brianssparetime/bronica-lens-housing/img-vid/bronica-s2-scan1.png

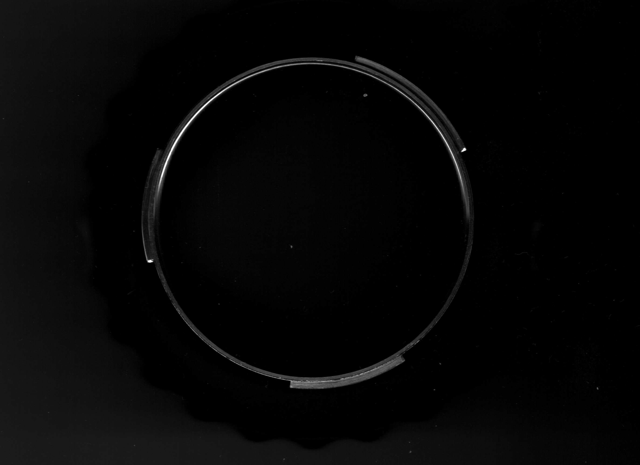
img-vid/bronica-s2-scan1.png
