brianssparetime/bronica-lens-housing/img-vid/bronica-s2-scan2.png

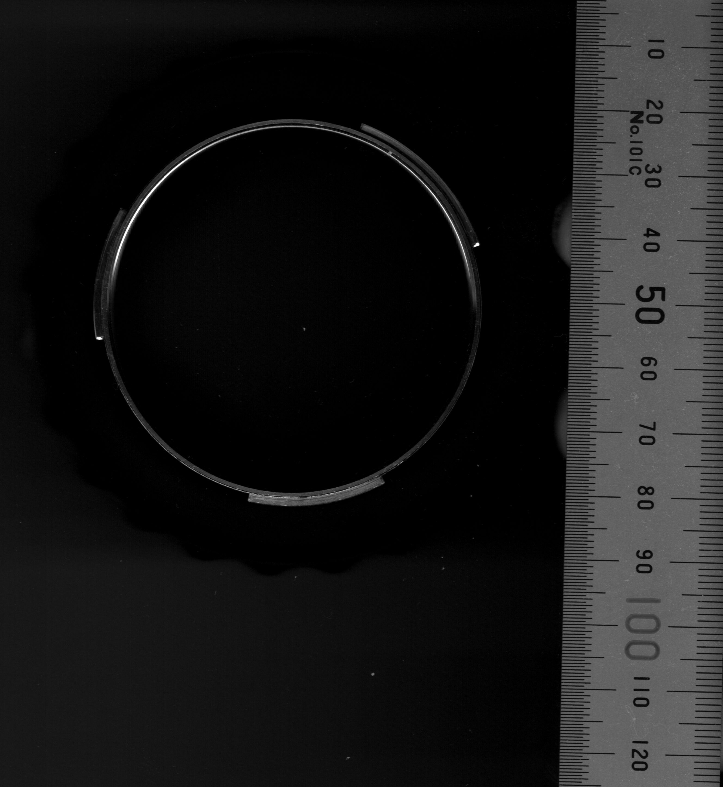
img-vid/bronica-s2-scan2.png
