brianssparetime/bronica-lens-housing/img-vid/IMG_2741 Large head on.jpeg

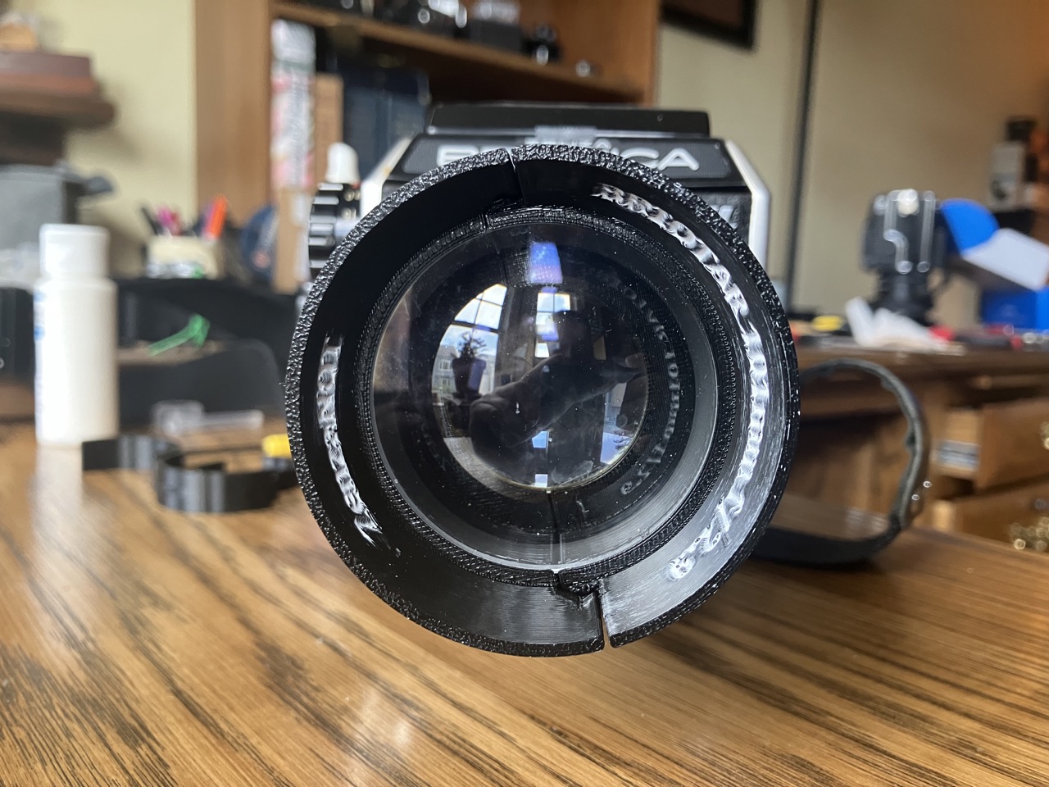
img-vid/IMG_2741 Large head on.jpeg
