brianssparetime/bronica-lens-housing/releases/13f/v13f-mount_ring_slice.stl

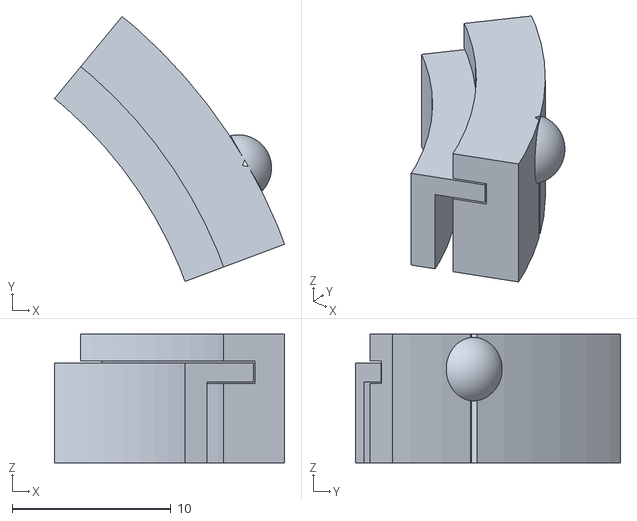
[picture p8: CAD file, 2026-08-01]
releases/13f/v13f-mount_ring_slice.stl
14.5 x 16.7 x 8.10
