brianssparetime/bronica-lens-housing/releases/14a/v14a-print_aperture_cover.stl

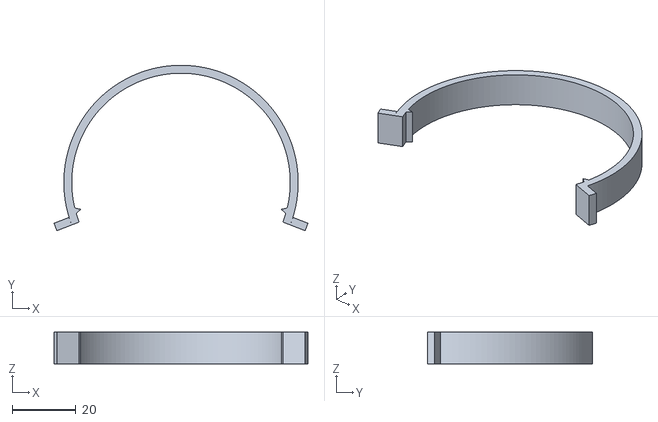
[picture p9: CAD file, 2026-08-01]
releases/14a/v14a-print_aperture_cover.stl
79.6 x 51.9 x 10.0
