brianssparetime/bronica-lens-housing/releases/15a/v15a-print_vertical.stl

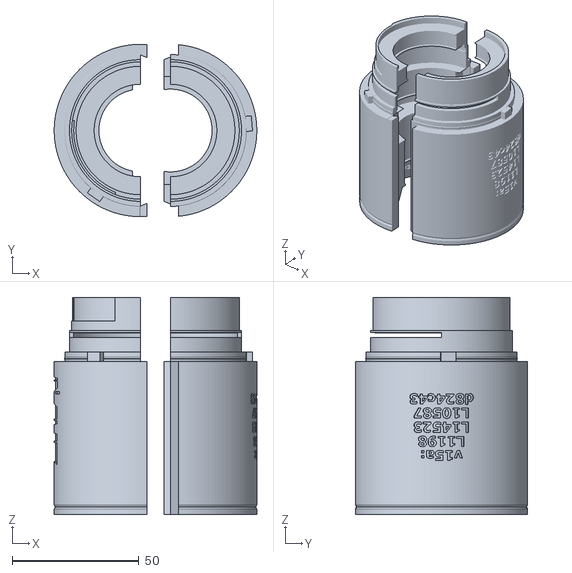
[picture p10: CAD file, 2026-08-01]
releases/15a/v15a-print_vertical.stl
80.1 x 68.1 x 85.8
