brianssparetime/bronica-lens-housing/releases/16c/v16c-print_vertical.stl

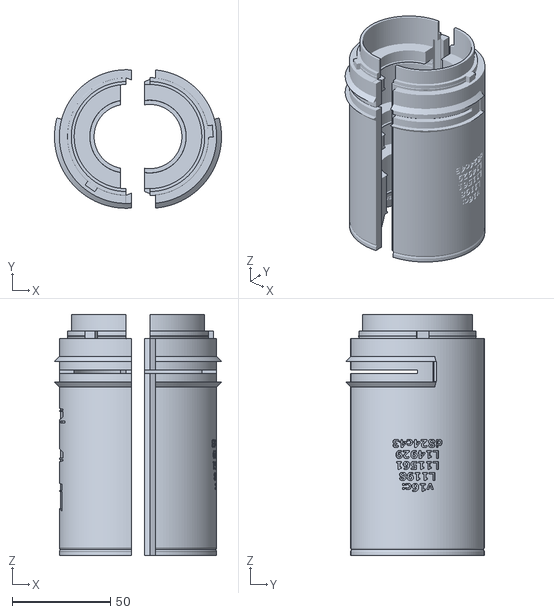
[picture p11: CAD file, 2026-08-01]
releases/16c/v16c-print_vertical.stl
85.1 x 70.6 x 122.8
