brianssparetime/bronica-lens-housing/releases/caps/rear_lens_cap-rear_cap.stl

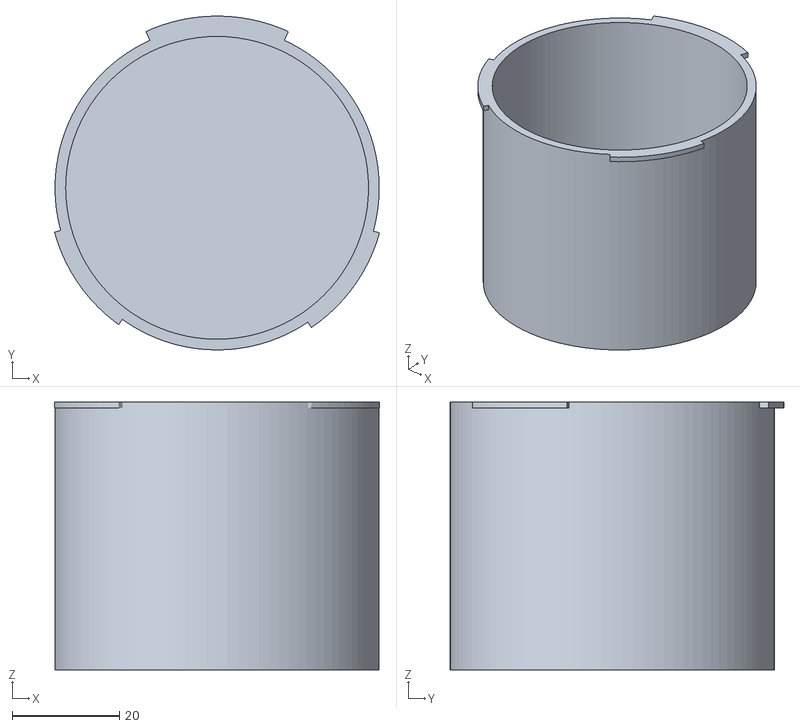
[picture p12: CAD file, 2026-11-03]
releases/caps/rear_lens_cap-rear_cap.stl
60.6 x 62.3 x 50.0
