brianssparetime/bronica-lens-housing/releases/mount-ring/lens_mount_ring-lens_print.stl

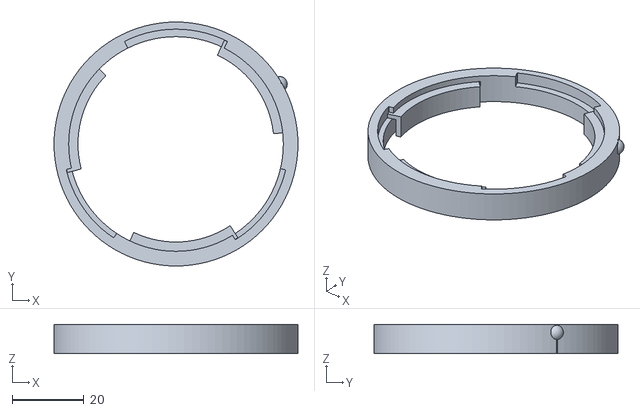
[picture p13: CAD file, 2026-08-01]
releases/mount-ring/lens_mount_ring-lens_print.stl
68.1 x 68.1 x 8.10
