brianssparetime/bronica-lens-housing/releases/14a/v14a-print_hood.stl

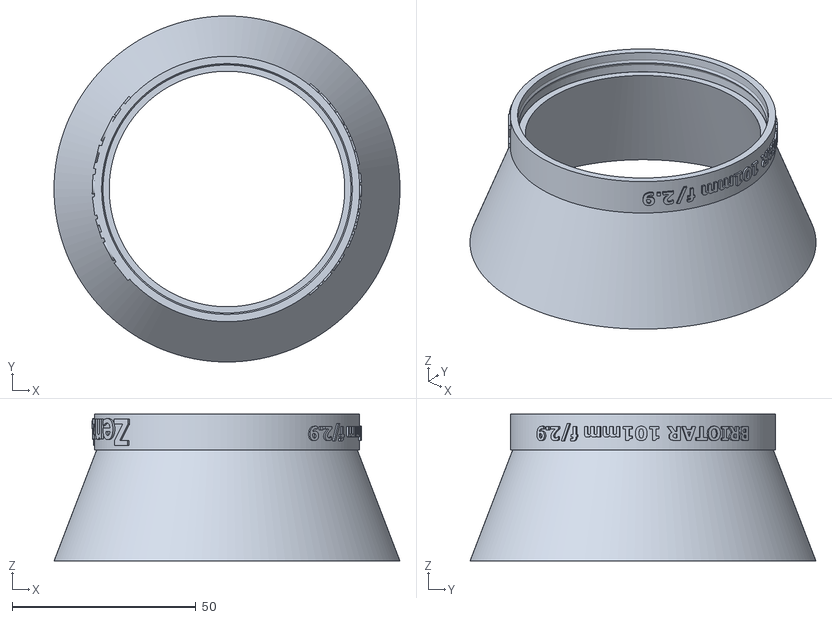
[picture p14: CAD file, 2026-08-01]
releases/14a/v14a-print_hood.stl
94.2 x 94.2 x 40.0
