brianssparetime/bronica-lens-housing/releases/caps/body_cap-cap.stl

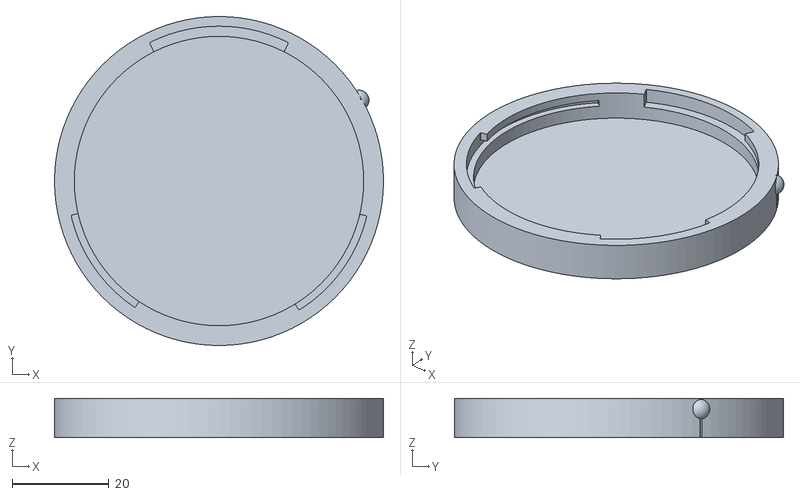
[picture p15: CAD file, 2026-11-03]
releases/caps/body_cap-cap.stl
68.1 x 68.1 x 8.10
