brianssparetime/bronica-lens-housing/releases/mount-ring/lens_mount_ring-lens.stl

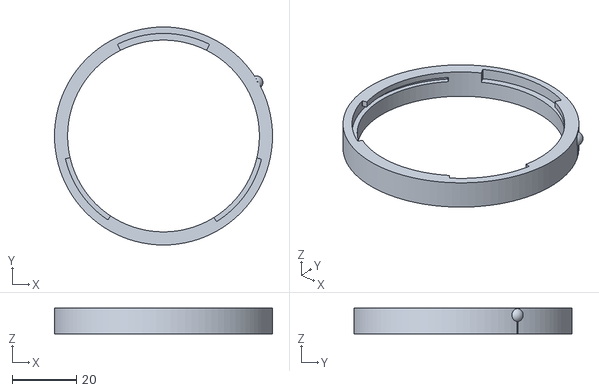
[picture p16: CAD file, 2026-08-01]
releases/mount-ring/lens_mount_ring-lens.stl
68.1 x 68.1 x 8.10
