brianssparetime/bronica-lens-housing/releases/14a/v14a-print_vertical.stl

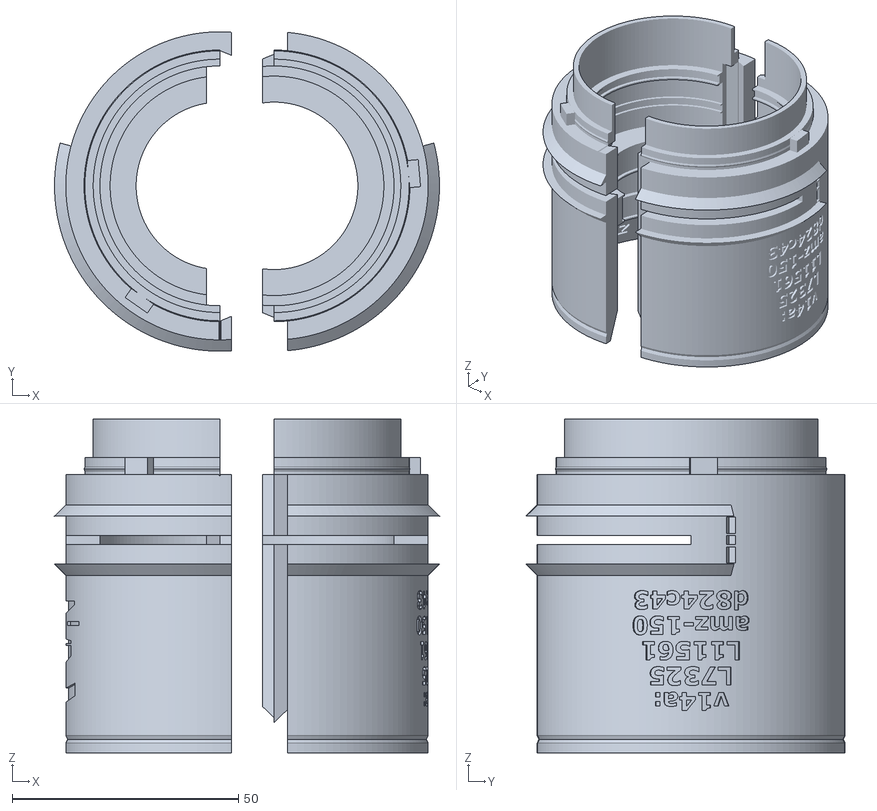
[picture p17: CAD file, 2026-08-01]
releases/14a/v14a-print_vertical.stl
85.1 x 70.6 x 73.8
