brianssparetime/bronica-lens-housing/releases/15a/v15a-print_stops.stl

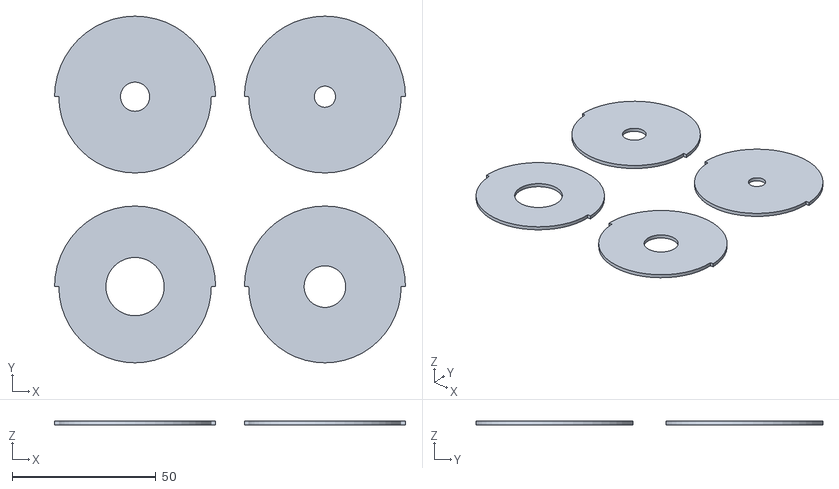
[picture p18: CAD file, 2026-08-01]
releases/15a/v15a-print_stops.stl
122.0 x 120.5 x 1.50
