brianssparetime/bronica-lens-housing/releases/caps/rear_lens_cap-rear_cap_sym.stl

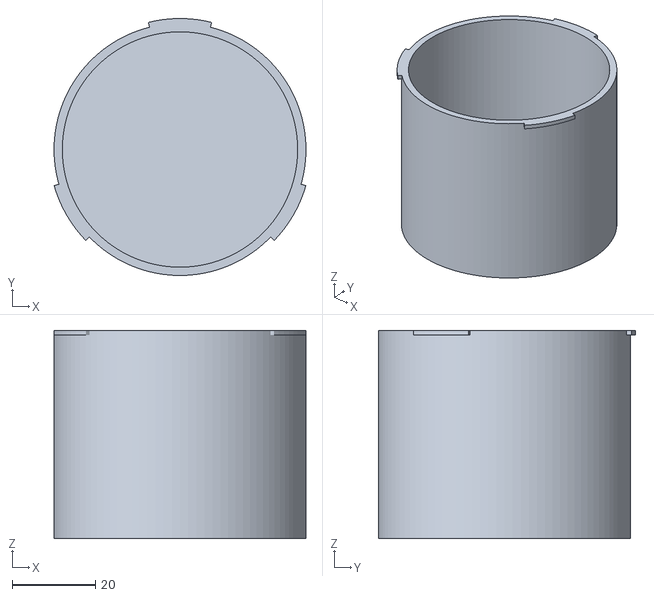
[picture p19: CAD file, 2026-11-03]
releases/caps/rear_lens_cap-rear_cap_sym.stl
60.5 x 61.7 x 50.0
