brianssparetime/bronica-lens-housing/releases/mount-ring/lens_mount_locking_ring-print.stl

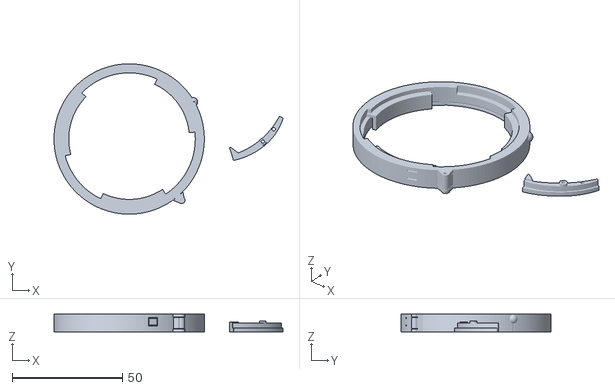
[picture p20: CAD file, 2026-08-01]
releases/mount-ring/lens_mount_locking_ring-print.stl
103.7 x 68.1 x 8.10
