brianssparetime/bronica-lens-housing/releases/15a/v15a-element_grippers.stl

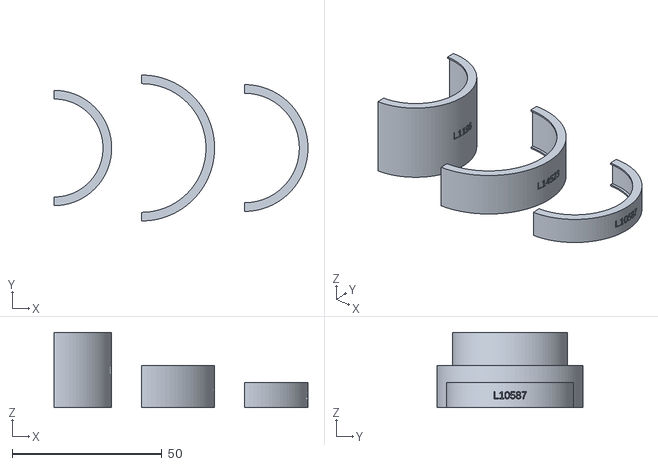
[picture p21: CAD file, 2026-08-01]
releases/15a/v15a-element_grippers.stl
84.8 x 48.7 x 25.1
