brianssparetime/bronica-lens-housing/releases/15a/v15a-print_shape_stops.stl

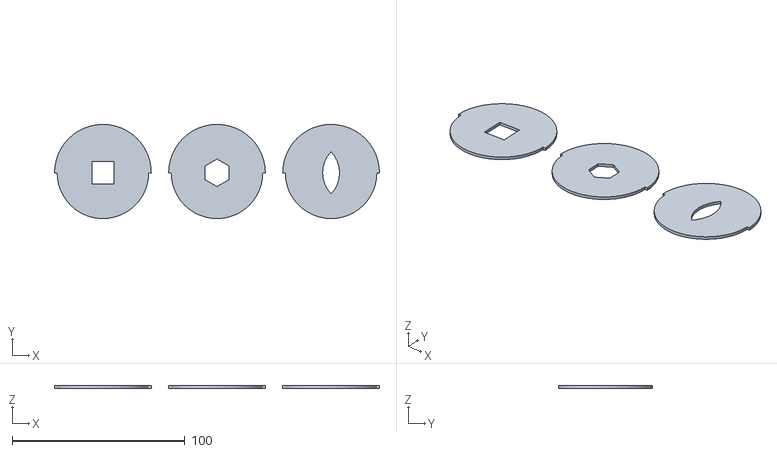
[picture p23: CAD file, 2026-08-01]
releases/15a/v15a-print_shape_stops.stl
188.0 x 54.5 x 1.50
