brianssparetime/bronica-lens-housing/releases/15a/v15a-element_grippers.scad

// Generated by scadwright. Do not hand-edit —
// edit the Python source and regenerate.

$fn = 96;

union() {
    translate([0, 24.35, 0]) {
        intersection() {
            difference() {
                // ElementTestGripper
                //  element     = Element(code='L1198', type='ACH', dia=34.2, edge_thk=23.75, spacing=51.9, face_z_top=64.475, face_z_bot=39.325, constricted=False, throat_dia_required=34.5, clearances=ElementClearances(axial=0.2, radial=0.3))  (input)
                //  grip_depth  = 1.5  (input)
                //  grip_width  = 1  (input)
                //  wall_thk    = 2  (input)
                //  gripper_h   = grip_width / 2 = 0.5
                //  surround_h  = element.face_z_top - element.spacing - gripper_h = 12.075
                //  rim_id      = element.dia - grip_depth = 32.7
                //  surround_id = element.dia + element.clearances.radial = 34.5
                //  od          = surround_id + 2 * wall_thk = 38.5
                //  total_h     = 2 * (gripper_h + surround_h) = 25.15
                union() {
                    // Tube
                    //  h  = 0.5  (input)
                    //  id = 32.7  (input)
                    //  od = 38.5  (input)
                    difference() {
                        cylinder(h=0.5, r=19.25, center=false);
                        translate([0, 0, -0.01]) {
                            scale([1, 1, 1.04]) {
                                cylinder(h=0.5, r=16.35, center=false);
                            }
                        }
                    }
                    translate([0, 0, 0.5]) {
                        // Tube
                        //  h  = 24.15  (input)
                        //  id = 34.5  (input)
                        //  od = 38.5  (input)
                        difference() {
                            cylinder(h=24.15, r=19.25, center=false);
                            translate([0, 0, -0.01]) {
                                scale([1, 1, 1.00083]) {
                                    cylinder(h=24.15, r=17.25, center=false);
                                }
                            }
                        }
                    }
                    translate([0, 0, 24.65]) {
                        // Tube
                        //  h  = 0.5  (input)
                        //  id = 32.7  (input)
                        //  od = 38.5  (input)
                        difference() {
                            cylinder(h=0.5, r=19.25, center=false);
                            translate([0, 0, -0.01]) {
                                scale([1, 1, 1.04]) {
                                    cylinder(h=0.5, r=16.35, center=false);
                                }
                            }
                        }
                    }
                }
                union() {
                    translate([18.4796, -3.66765, 12.575]) {
                        multmatrix([[0.194673, 0, 0.980868, 0], [0.980868, 0, -0.194673, 0], [0, 1, 0, 0], [0, 0, 0, 1]]) {
                            linear_extrude(height=0.91, center=false) {
                                translate([-0.942887, -1.25, 0]) {
                                    text("L", size=2.5);
                                }
                            }
                        }
                    }
                    translate([18.7497, -1.84266, 12.575]) {
                        multmatrix([[0.0978057, 0, 0.995206, 0], [0.995206, 0, -0.0978057, 0], [0, 1, 0, 0], [0, 0, 0, 1]]) {
                            linear_extrude(height=0.91, center=false) {
                                translate([-0.942887, -1.25, 0]) {
                                    text("1", size=2.5);
                                }
                            }
                        }
                    }
                    translate([18.84, 0, 12.575]) {
                        multmatrix([[0, 0, 1, 0], [1, 0, 0, 0], [0, 1, 0, 0], [0, 0, 0, 1]]) {
                            linear_extrude(height=0.91, center=false) {
                                translate([-0.942887, -1.25, 0]) {
                                    text("1", size=2.5);
                                }
                            }
                        }
                    }
                    translate([18.7497, 1.84266, 12.575]) {
                        multmatrix([[-0.0978057, 0, 0.995206, 0], [0.995206, 0, 0.0978057, 0], [0, 1, 0, 0], [0, 0, 0, 1]]) {
                            linear_extrude(height=0.91, center=false) {
                                translate([-0.942887, -1.25, 0]) {
                                    text("9", size=2.5);
                                }
                            }
                        }
                    }
                    translate([18.4796, 3.66765, 12.575]) {
                        multmatrix([[-0.194673, 0, 0.980868, 0], [0.980868, 0, 0.194673, 0], [0, 1, 0, 0], [0, 0, 0, 1]]) {
                            linear_extrude(height=0.91, center=false) {
                                translate([-0.942887, -1.25, 0]) {
                                    text("8", size=2.5);
                                }
                            }
                        }
                    }
                }
            }
            translate([25.653, 0, 0]) {
                cube([51.306, 51.306, 51.306], center=true);
            }
        }
    }

    translate([29.25, 24.35, 0]) {
        intersection() {
            difference() {
                // ElementTestGripper
                //  element     = Element(code='L14523', type='ACH', dia=44.4, edge_thk=12.6, spacing=25.9, face_z_top=32.9, face_z_bot=18.9, constricted=False, throat_dia_required=44.699999999999996, clearances=ElementClearances(axial=0.2, radial=0.3))  (input)
                //  grip_depth  = 1.5  (input)
                //  grip_width  = 1  (input)
                //  wall_thk    = 2  (input)
                //  gripper_h   = grip_width / 2 = 0.5
                //  surround_h  = element.face_z_top - element.spacing - gripper_h = 6.5
                //  rim_id      = element.dia - grip_depth = 42.9
                //  surround_id = element.dia + element.clearances.radial = 44.7
                //  od          = surround_id + 2 * wall_thk = 48.7
                //  total_h     = 2 * (gripper_h + surround_h) = 14
                union() {
                    // Tube
                    //  h  = 0.5  (input)
                    //  id = 42.9  (input)
                    //  od = 48.7  (input)
                    difference() {
                        cylinder(h=0.5, r=24.35, center=false);
                        translate([0, 0, -0.01]) {
                            scale([1, 1, 1.04]) {
                                cylinder(h=0.5, r=21.45, center=false);
                            }
                        }
                    }
                    translate([0, 0, 0.5]) {
                        // Tube
                        //  h  = 13  (input)
                        //  id = 44.7  (input)
                        //  od = 48.7  (input)
                        difference() {
                            cylinder(h=13, r=24.35, center=false);
                            translate([0, 0, -0.01]) {
                                scale([1, 1, 1.00154]) {
                                    cylinder(h=13, r=22.35, center=false);
                                }
                            }
                        }
                    }
                    translate([0, 0, 13.5]) {
                        // Tube
                        //  h  = 0.5  (input)
                        //  id = 42.9  (input)
                        //  od = 48.7  (input)
                        difference() {
                            cylinder(h=0.5, r=24.35, center=false);
                            translate([0, 0, -0.01]) {
                                scale([1, 1, 1.04]) {
                                    cylinder(h=0.5, r=21.45, center=false);
                                }
                            }
                        }
                    }
                }
                union() {
                    translate([23.4927, -4.60615, 7]) {
                        multmatrix([[0.192404, 0, 0.981316, 0], [0.981316, 0, -0.192404, 0], [0, 1, 0, 0], [0, 0, 0, 1]]) {
                            linear_extrude(height=0.91, center=false) {
                                translate([-0.942887, -1.25, 0]) {
                                    text("L", size=2.5);
                                }
                            }
                        }
                    }
                    translate([23.7786, -2.77478, 7]) {
                        multmatrix([[0.115906, 0, 0.99326, 0], [0.99326, 0, -0.115906, 0], [0, 1, 0, 0], [0, 0, 0, 1]]) {
                            linear_extrude(height=0.91, center=false) {
                                translate([-0.942887, -1.25, 0]) {
                                    text("1", size=2.5);
                                }
                            }
                        }
                    }
                    translate([23.9221, -0.926779, 7]) {
                        multmatrix([[0.0387126, 0, 0.99925, 0], [0.99925, 0, -0.0387126, 0], [0, 1, 0, 0], [0, 0, 0, 1]]) {
                            linear_extrude(height=0.91, center=false) {
                                translate([-0.942887, -1.25, 0]) {
                                    text("4", size=2.5);
                                }
                            }
                        }
                    }
                    translate([23.9221, 0.926779, 7]) {
                        multmatrix([[-0.0387126, 0, 0.99925, 0], [0.99925, 0, 0.0387126, 0], [0, 1, 0, 0], [0, 0, 0, 1]]) {
                            linear_extrude(height=0.91, center=false) {
                                translate([-0.942887, -1.25, 0]) {
                                    text("5", size=2.5);
                                }
                            }
                        }
                    }
                    translate([23.7786, 2.77478, 7]) {
                        multmatrix([[-0.115906, 0, 0.99326, 0], [0.99326, 0, 0.115906, 0], [0, 1, 0, 0], [0, 0, 0, 1]]) {
                            linear_extrude(height=0.91, center=false) {
                                translate([-0.942887, -1.25, 0]) {
                                    text("2", size=2.5);
                                }
                            }
                        }
                    }
                    translate([23.4927, 4.60615, 7]) {
                        multmatrix([[-0.192404, 0, 0.981316, 0], [0.981316, 0, 0.192404, 0], [0, 1, 0, 0], [0, 0, 0, 1]]) {
                            linear_extrude(height=0.91, center=false) {
                                translate([-0.942887, -1.25, 0]) {
                                    text("3", size=2.5);
                                }
                            }
                        }
                    }
                }
            }
            translate([24.837, 0, 0]) {
                cube([49.674, 49.674, 49.674], center=true);
            }
        }
    }

    translate([63.6, 24.35, 0]) {
        intersection() {
            difference() {
                // ElementTestGripper
                //  element     = Element(code='L10587', type='ACH', dia=38.0, edge_thk=7.0, spacing=0.9, face_z_top=5.1000000000000005, face_z_bot=-3.3000000000000003, constricted=True, throat_dia_required=38.3, clearances=ElementClearances(axial=0.2, radial=0.3))  (input)
                //  grip_depth  = 1.5  (input)
                //  grip_width  = 1  (input)
                //  wall_thk    = 2  (input)
                //  gripper_h   = grip_width / 2 = 0.5
                //  surround_h  = element.face_z_top - element.spacing - gripper_h = 3.7
                //  rim_id      = element.dia - grip_depth = 36.5
                //  surround_id = element.dia + element.clearances.radial = 38.3
                //  od          = surround_id + 2 * wall_thk = 42.3
                //  total_h     = 2 * (gripper_h + surround_h) = 8.4
                union() {
                    // Tube
                    //  h  = 0.5  (input)
                    //  id = 36.5  (input)
                    //  od = 42.3  (input)
                    difference() {
                        cylinder(h=0.5, r=21.15, center=false);
                        translate([0, 0, -0.01]) {
                            scale([1, 1, 1.04]) {
                                cylinder(h=0.5, r=18.25, center=false);
                            }
                        }
                    }
                    translate([0, 0, 0.5]) {
                        // Tube
                        //  h  = 7.4  (input)
                        //  id = 38.3  (input)
                        //  od = 42.3  (input)
                        difference() {
                            cylinder(h=7.4, r=21.15, center=false);
                            translate([0, 0, -0.01]) {
                                scale([1, 1, 1.0027]) {
                                    cylinder(h=7.4, r=19.15, center=false);
                                }
                            }
                        }
                    }
                    translate([0, 0, 7.9]) {
                        // Tube
                        //  h  = 0.5  (input)
                        //  id = 36.5  (input)
                        //  od = 42.3  (input)
                        difference() {
                            cylinder(h=0.5, r=21.15, center=false);
                            translate([0, 0, -0.01]) {
                                scale([1, 1, 1.04]) {
                                    cylinder(h=0.5, r=18.25, center=false);
                                }
                            }
                        }
                    }
                }
                union() {
                    translate([20.2269, -4.58485, 4.2]) {
                        multmatrix([[0.221063, 0, 0.975259, 0], [0.975259, 0, -0.221063, 0], [0, 1, 0, 0], [0, 0, 0, 1]]) {
                            linear_extrude(height=0.91, center=false) {
                                translate([-0.942887, -1.25, 0]) {
                                    text("L", size=2.5);
                                }
                            }
                        }
                    }
                    translate([20.5548, -2.76556, 4.2]) {
                        multmatrix([[0.133344, 0, 0.99107, 0], [0.99107, 0, -0.133344, 0], [0, 1, 0, 0], [0, 0, 0, 1]]) {
                            linear_extrude(height=0.91, center=false) {
                                translate([-0.942887, -1.25, 0]) {
                                    text("1", size=2.5);
                                }
                            }
                        }
                    }
                    translate([20.7194, -0.924302, 4.2]) {
                        multmatrix([[0.0445662, 0, 0.999006, 0], [0.999006, 0, -0.0445662, 0], [0, 1, 0, 0], [0, 0, 0, 1]]) {
                            linear_extrude(height=0.91, center=false) {
                                translate([-0.942887, -1.25, 0]) {
                                    text("0", size=2.5);
                                }
                            }
                        }
                    }
                    translate([20.7194, 0.924302, 4.2]) {
                        multmatrix([[-0.0445662, 0, 0.999006, 0], [0.999006, 0, 0.0445662, 0], [0, 1, 0, 0], [0, 0, 0, 1]]) {
                            linear_extrude(height=0.91, center=false) {
                                translate([-0.942887, -1.25, 0]) {
                                    text("5", size=2.5);
                                }
                            }
                        }
                    }
                    translate([20.5548, 2.76556, 4.2]) {
                        multmatrix([[-0.133344, 0, 0.99107, 0], [0.99107, 0, 0.133344, 0], [0, 1, 0, 0], [0, 0, 0, 1]]) {
                            linear_extrude(height=0.91, center=false) {
                                translate([-0.942887, -1.25, 0]) {
                                    text("8", size=2.5);
                                }
                            }
                        }
                    }
                    translate([20.2269, 4.58485, 4.2]) {
                        multmatrix([[-0.221063, 0, 0.975259, 0], [0.975259, 0, 0.221063, 0], [0, 1, 0, 0], [0, 0, 0, 1]]) {
                            linear_extrude(height=0.91, center=false) {
                                translate([-0.942887, -1.25, 0]) {
                                    text("7", size=2.5);
                                }
                            }
                        }
                    }
                }
            }
            translate([21.573, 0, 0]) {
                cube([43.146, 43.146, 43.146], center=true);
            }
        }
    }
}
