brianssparetime/bronica-lens-housing/releases/13f/v13f-mount_ring_slice.scad

// Generated by scadwright. Do not hand-edit —
// edit the Python source and regenerate.

$fn = 96;

union() {
    intersection() {
        // BronicaS2LensMount
        //  cam_barrel_id        = 56.5  (input)
        //  cam_barrel_od        = 60.5  (input)
        //  lug_axial            = 1.15  (input)
        //  lugs                 = ((90.0, 49.0, 1.8), (214.75, 39.0, 1.2), (324.25, 40.5, 1.2))  (input)
        //  clearance            = 0.2  (default)
        //  entry_arc_clearance  = 1  (default)
        //  groove_depth         = 0.3  (default)
        //  groove_width         = 0.5  (default)
        //  inner_shrink         = 1  (default)
        //  lock_angle_deg       = 60  (default)
        //  lug_axial_clearance  = 0.25  (default)
        //  lug_radial_clearance = 0  (default)
        //  mount_skirt          = 1.7  (default)
        //  protrusion_len       = 5  (default)
        //  wall_thk             = 2  (default)
        //  insertion_depth      = lug_axial + lug_axial_clearance + mount_skirt = 3.1
        //  h                    = protrusion_len + insertion_depth = 8.1
        //  max_lug_proj         = max((p for c, w, p in lugs)) = 1.8
        //  outer_od             = cam_barrel_od + 2 * max_lug_proj + 2 * wall_thk = 68.1
        //  inner_id             = cam_barrel_id - 2 * wall_thk - inner_shrink = 51.5
        //  body_or              = cam_barrel_od / 2 = 30.25
        //  outer_or             = outer_od / 2 = 34.05
        //  rest_z               = h - insertion_depth = 5
        //  bore_inner_r         = body_or + clearance - inner_shrink / 2 = 29.95
        //  channel_breakthrough = 0.5 = 0.5
        //  channel_inner_r      = bore_inner_r + clearance - channel_breakthrough = 29.65
        //  widest_w             = max((lw for lc, lw, lp in lugs)) = 49
        //  widest_center        = [lc for lc, lw, lp in lugs if lw == widest_w][0] = 90
        //  groove_angle_deg     = widest_center - lock_angle_deg = 30
        union() {
            difference() {
                // Tube
                //  h  = 8.1  (input)
                //  id = 51.5  (input)
                //  od = 68.1  (input)
                difference() {
                    cylinder(h=8.1, r=34.05, center=false);
                    translate([0, 0, -0.01]) {
                        scale([1, 1, 1.00247]) {
                            cylinder(h=8.1, r=25.75, center=false);
                        }
                    }
                }
                translate([0, 0, -0.01]) {
                    linear_extrude(height=8.12, center=false) {
                        offset(r=0.2) {
                            circle(r=29.75);
                        }
                    }
                }
                translate([0, 0, 5]) {
                    linear_extrude(height=3.11, center=false) {
                        offset(r=0.2) {
                            union() {
                                // Arc
                                //  angles  = [63.6606, 116.339]  (input)
                                //  r       = 30.75  (input)
                                //  width   = 2.2  (input)
                                //  inner_r = r - width / 2 = 29.65
                                //  outer_r = r + width / 2 = 31.85
                                difference() {
                                    // Sector
                                    //  angles = [63.6606, 116.339]  (input)
                                    //  r      = 31.85  (input)
                                    intersection() {
                                        circle(r=31.85);
                                        polygon(points=[[0, 0], [28.2628, 57.0868], [-28.2628, 57.0868]]);
                                    }
                                    circle(r=29.65);
                                }
                                // Arc
                                //  angles  = [193.393, 236.107]  (input)
                                //  r       = 30.45  (input)
                                //  width   = 1.6  (input)
                                //  inner_r = r - width / 2 = 29.65
                                //  outer_r = r + width / 2 = 31.25
                                difference() {
                                    // Sector
                                    //  angles = [193.393, 236.107]  (input)
                                    //  r      = 31.25  (input)
                                    intersection() {
                                        circle(r=31.25);
                                        polygon(points=[[0, 0], [-60.8003, -14.4766], [-34.8525, -51.8802]]);
                                    }
                                    circle(r=29.65);
                                }
                                // Arc
                                //  angles  = [302.143, 346.357]  (input)
                                //  r       = 30.45  (input)
                                //  width   = 1.6  (input)
                                //  inner_r = r - width / 2 = 29.65
                                //  outer_r = r + width / 2 = 31.25
                                difference() {
                                    // Sector
                                    //  angles = [302.143, 346.357]  (input)
                                    //  r      = 31.25  (input)
                                    intersection() {
                                        circle(r=31.25);
                                        polygon(points=[[0, 0], [33.2519, -52.9203], [60.7366, -14.7417]]);
                                    }
                                    circle(r=29.65);
                                }
                            }
                        }
                    }
                }
                translate([0, 0, 5]) {
                    linear_extrude(height=1.4, center=false) {
                        offset(r=0.2) {
                            union() {
                                // Arc
                                //  angles  = [5.5, 114.5]  (input)
                                //  r       = 30.75  (input)
                                //  width   = 2.2  (input)
                                //  inner_r = r - width / 2 = 29.65
                                //  outer_r = r + width / 2 = 31.85
                                difference() {
                                    // Sector
                                    //  angles = [5.5, 114.5]  (input)
                                    //  r      = 31.85  (input)
                                    intersection() {
                                        circle(r=31.85);
                                        polygon(points=[[0, 0], [63.4067, 6.10537], [31.85, 55.1658], [-26.416, 57.9645]]);
                                    }
                                    circle(r=29.65);
                                }
                                // Arc
                                //  angles  = [135.25, 234.25]  (input)
                                //  r       = 30.45  (input)
                                //  width   = 1.6  (input)
                                //  inner_r = r - width / 2 = 29.65
                                //  outer_r = r + width / 2 = 31.25
                                difference() {
                                    // Sector
                                    //  angles = [135.25, 234.25]  (input)
                                    //  r      = 31.25  (input)
                                    intersection() {
                                        circle(r=31.25);
                                        polygon(points=[[0, 0], [-44.3866, 44.0009], [-62.2853, -5.17551], [-36.5156, -50.7234]]);
                                    }
                                    circle(r=29.65);
                                }
                                // Arc
                                //  angles  = [244, 344.5]  (input)
                                //  r       = 30.45  (input)
                                //  width   = 1.6  (input)
                                //  inner_r = r - width / 2 = 29.65
                                //  outer_r = r + width / 2 = 31.25
                                difference() {
                                    // Sector
                                    //  angles = [244, 344.5]  (input)
                                    //  r      = 31.25  (input)
                                    intersection() {
                                        circle(r=31.25);
                                        polygon(points=[[0, 0], [-27.3982, -56.1746], [25.6699, -56.9851], [60.2269, -16.7024]]);
                                    }
                                    circle(r=29.65);
                                }
                            }
                        }
                    }
                }
                rotate([0, 0, 30]) {
                    translate([0, 0, -0.01]) {
                        linear_extrude(height=8.12, center=false) {
                            polygon(points=[[33.75, 0], [34.06, 0.25], [34.06, -0.25]]);
                        }
                    }
                }
            }
            rotate([0, 0, 30]) {
                translate([34.04, 0, 5.9]) {
                    rotate([0, 90, 0]) {
                        // Dome
                        //  cap_dia    = 4  (input)
                        //  cap_height = 1.5  (input)
                        //  cap_r      = cap_dia / 2 = 2
                        intersection() {
                            translate([0, 0, -0.583333]) {
                                sphere(r=2.08333);
                            }
                            cylinder(h=1.5, r=2.09333, center=false);
                        }
                    }
                }
            }
        }
        translate([0, 0, -1]) {
            linear_extrude(height=10.1, center=false) {
                // Sector
                //  angles = [20.5, 50.5]  (input)
                //  r      = 38.05  (input)
                intersection() {
                    circle(r=38.05);
                    polygon(points=[[0, 0], [71.2808, 26.6508], [48.4056, 58.7206]]);
                }
            }
        }
    }

    color("red") {
        intersection() {
            // BronicaS2LensMountSupports
            //  cam_barrel_id        = 56.5  (input)
            //  cam_barrel_od        = 60.5  (input)
            //  lug_axial            = 1.15  (input)
            //  lugs                 = ((90.0, 49.0, 1.8), (214.75, 39.0, 1.2), (324.25, 40.5, 1.2))  (input)
            //  clearance            = 0.2  (default)
            //  entry_arc_clearance  = 1  (default)
            //  groove_depth         = 0.3  (default)
            //  groove_width         = 0.5  (default)
            //  inner_shrink         = 1  (default)
            //  lock_angle_deg       = 60  (default)
            //  lug_axial_clearance  = 0.25  (default)
            //  lug_radial_clearance = 0  (default)
            //  mount_skirt          = 1.7  (default)
            //  protrusion_len       = 5  (default)
            //  wall_thk             = 2  (default)
            //  insertion_depth      = lug_axial + lug_axial_clearance + mount_skirt = 3.1
            //  h                    = protrusion_len + insertion_depth = 8.1
            //  max_lug_proj         = max((p for c, w, p in lugs)) = 1.8
            //  outer_od             = cam_barrel_od + 2 * max_lug_proj + 2 * wall_thk = 68.1
            //  inner_id             = cam_barrel_id - 2 * wall_thk - inner_shrink = 51.5
            //  body_or              = cam_barrel_od / 2 = 30.25
            //  outer_or             = outer_od / 2 = 34.05
            //  rest_z               = h - insertion_depth = 5
            //  bore_inner_r         = body_or + clearance - inner_shrink / 2 = 29.95
            //  channel_breakthrough = 0.5 = 0.5
            //  channel_inner_r      = bore_inner_r + clearance - channel_breakthrough = 29.65
            //  widest_w             = max((lw for lc, lw, lp in lugs)) = 49
            //  widest_center        = [lc for lc, lw, lp in lugs if lw == widest_w][0] = 90
            //  groove_angle_deg     = widest_center - lock_angle_deg = 30
            union() {
                translate([0, 0, 0]) {
                    linear_extrude(height=6.3, center=false) {
                        // Arc
                        //  angles  = [6, 65]  (input)
                        //  r       = 28.1  (input)
                        //  width   = 1.5  (input)
                        //  inner_r = r - width / 2 = 27.35
                        //  outer_r = r + width / 2 = 28.85
                        difference() {
                            // Sector
                            //  angles = [6, 65]  (input)
                            //  r      = 28.85  (input)
                            intersection() {
                                circle(r=28.85);
                                polygon(points=[[0, 0], [57.3839, 6.03129], [24.3851, 52.294]]);
                            }
                            circle(r=27.35);
                        }
                    }
                }
                translate([0, 0, 5.1]) {
                    linear_extrude(height=1.2, center=false) {
                        // Arc
                        //  angles  = [6, 65]  (input)
                        //  r       = 30.395  (input)
                        //  width   = 3.11  (input)
                        //  inner_r = r - width / 2 = 28.84
                        //  outer_r = r + width / 2 = 31.95
                        difference() {
                            // Sector
                            //  angles = [6, 65]  (input)
                            //  r      = 31.95  (input)
                            intersection() {
                                circle(r=31.95);
                                polygon(points=[[0, 0], [63.5499, 6.67937], [27.0053, 57.9131]]);
                            }
                            circle(r=28.84);
                        }
                    }
                }
                translate([0, 0, 0]) {
                    linear_extrude(height=6.3, center=false) {
                        // Arc
                        //  angles  = [135.75, 194.75]  (input)
                        //  r       = 28.1  (input)
                        //  width   = 1.5  (input)
                        //  inner_r = r - width / 2 = 27.35
                        //  outer_r = r + width / 2 = 28.85
                        difference() {
                            // Sector
                            //  angles = [135.75, 194.75]  (input)
                            //  r      = 28.85  (input)
                            intersection() {
                                circle(r=28.85);
                                polygon(points=[[0, 0], [-41.3306, 40.2625], [-55.7986, -14.6905]]);
                            }
                            circle(r=27.35);
                        }
                    }
                }
                translate([0, 0, 5.1]) {
                    linear_extrude(height=1.2, center=false) {
                        // Arc
                        //  angles  = [135.75, 194.75]  (input)
                        //  r       = 30.095  (input)
                        //  width   = 2.51  (input)
                        //  inner_r = r - width / 2 = 28.84
                        //  outer_r = r + width / 2 = 31.35
                        difference() {
                            // Sector
                            //  angles = [135.75, 194.75]  (input)
                            //  r      = 31.35  (input)
                            intersection() {
                                circle(r=31.35);
                                polygon(points=[[0, 0], [-44.9121, 43.7515], [-60.6338, -15.9635]]);
                            }
                            circle(r=28.84);
                        }
                    }
                }
                translate([0, 0, 0]) {
                    linear_extrude(height=6.3, center=false) {
                        // Arc
                        //  angles  = [244.5, 303.5]  (input)
                        //  r       = 28.1  (input)
                        //  width   = 1.5  (input)
                        //  inner_r = r - width / 2 = 27.35
                        //  outer_r = r + width / 2 = 28.85
                        difference() {
                            // Sector
                            //  angles = [244.5, 303.5]  (input)
                            //  r      = 28.85  (input)
                            intersection() {
                                circle(r=28.85);
                                polygon(points=[[0, 0], [-24.8405, -52.0792], [31.8468, -48.1152]]);
                            }
                            circle(r=27.35);
                        }
                    }
                }
                translate([0, 0, 5.1]) {
                    linear_extrude(height=1.2, center=false) {
                        // Arc
                        //  angles  = [244.5, 303.5]  (input)
                        //  r       = 30.095  (input)
                        //  width   = 2.51  (input)
                        //  inner_r = r - width / 2 = 28.84
                        //  outer_r = r + width / 2 = 31.35
                        difference() {
                            // Sector
                            //  angles = [244.5, 303.5]  (input)
                            //  r      = 31.35  (input)
                            intersection() {
                                circle(r=31.35);
                                polygon(points=[[0, 0], [-26.993, -56.5921], [34.6064, -52.2846]]);
                            }
                            circle(r=28.84);
                        }
                    }
                }
            }
            translate([0, 0, -1]) {
                linear_extrude(height=10.1, center=false) {
                    // Sector
                    //  angles = [20.5, 50.5]  (input)
                    //  r      = 38.05  (input)
                    intersection() {
                        circle(r=38.05);
                        polygon(points=[[0, 0], [71.2808, 26.6508], [48.4056, 58.7206]]);
                    }
                }
            }
        }
    }
}
