brianssparetime/bronica-lens-housing/releases/14a/v14a-display.scad

// Generated by scadwright. Do not hand-edit —
// edit the Python source and regenerate.

$fn = 48;

union() {
    difference() {
        // S2LensHousing
        //  alignment_groove_depth           = 0.3  (default)
        //  alignment_groove_width           = 0.5  (default)
        //  aperture_cover_axial             = 10  (default)
        //  aperture_cover_clearance         = 0.1  (default)
        //  aperture_cover_fillet_angle      = 45  (default)
        //  aperture_cover_fillet_clearance  = 0.3  (default)
        //  aperture_cover_groove_offset_deg = 15  (default)
        //  aperture_cover_ridge_base        = 1.8  (default)
        //  aperture_cover_ridge_height      = 1.5  (default)
        //  aperture_cover_wall_thk          = 2.5  (default)
        //  aperture_feeler_slot             = [0, 15, 0.5, -30, -20.3, 60, 0.01]  (default)
        //  bore_fillet_base_angle           = 45  (default)
        //  elements                         = (Element(code='L7325', type='NMN', dia=52.0, edge_thk=6.2, spacing=51.489, face_z_top=55.288999999999994, face_z_bot=47.689, constricted=False, throat_dia_required=52.3, clearances=ElementClearances(axial=0.2, radial=0.3)), Element(code='L11561', type='ACH', dia=38.5, edge_thk=7.5, spacing=31.489, face_z_top=35.939, face_z_bot=27.039, constricted=False, throat_dia_required=38.8, clearances=ElementClearances(axial=0.2, radial=0.3)), Element(code='amz-150', type='PCX', dia=50.0, edge_thk=2.0, spacing=9.489, face_z_top=11.189, face_z_bot=7.789000000000001, constricted=False, throat_dia_required=50.3, clearances=ElementClearances(axial=0.2, radial=0.3)))  (default)
        //  flange_flange_len                = 5  (default)
        //  flange_flange_od                 = 68.1  (default)
        //  fov_angle                        = 42  (default)
        //  grip_depth                       = 1.5  (default)
        //  grip_width                       = 1  (default)
        //  helicoid_focus_slot              = [180, 8, 0.8, -20.3, -11, 60, 0.01]  (default)
        //  hood_coupler_overlap             = 6  (default)
        //  hood_snap_axial                  = 1.5  (default)
        //  hood_snap_clearance              = 0.1  (default)
        //  hood_snap_engage                 = 0.3  (default)
        //  lower_inner_len                  = 9.7  (default)
        //  lower_inner_od                   = 49  (default)
        //  lower_inner_thk                  = 1.5  (default)
        //  lower_mid_len                    = 13  (default)
        //  lower_mid_od                     = 54.25  (default)
        //  lower_mid_thk                    = 1.75  (default)
        //  lower_outer_len                  = 7.3  (default)
        //  lower_outer_od                   = 56  (default)
        //  lower_outer_thk                  = 1.5  (default)
        //  mating_disc                      = [59.65, 1.2, 5]  (default)
        //  mating_disc_bead                 = [0.2, 1, 3.75, 0.05, 0.05]  (default)
        //  mating_disc_tabs                 = MatingDiscTabs(axial=3.8, radial=2.4, circumferential=6.0, z_top=5.0, angles_deg=(55.0, 185.0), clearance=0.15, disc_od=59.65, housing_tab_offset_deg=-60.0)  (default)
        //  mount_offset                     = 5  (default)
        //  stop                             = [19.439, 1.5, 0.5]  (default)
        //  upper_barrel_thk                 = 5  (default)
        //  force_all_lower_segments         = false  (default)
        //  slot_hi                          = 20.439  (default)
        //  hood_base_angle                  = 90 - fov_angle / 2 = 69
        //  lower_outer_id                   = lower_outer_od - 2 * lower_outer_thk = 53
        //  lower_mid_id                     = lower_mid_od - 2 * lower_mid_thk = 50.75
        //  lower_inner_id                   = lower_inner_od - 2 * lower_inner_thk = 46
        //  lower_outer_z_top                = mount_offset = 5
        //  lower_outer_z_bot                = -lower_outer_len = -7.3
        //  lower_mid_z_top                  = lower_outer_z_bot = -7.3
        //  lower_mid_z_bot                  = lower_mid_z_top - lower_mid_len = -20.3
        //  lower_inner_z_top                = lower_mid_z_bot = -20.3
        //  lower_inner_z_bot                = lower_inner_z_top - lower_inner_len = -30
        //  housing_insertion_depth          = lower_outer_len + lower_mid_len + lower_inner_len = 30
        //  lower_housing_len                = housing_insertion_depth + mount_offset = 35
        //  unconstricted                    = tuple((e for e in elements if not e.constricted)) = (Element(code='L7325', type='NMN', dia=52.0, edge_thk=6.2, spacing=51.489, face_z_top=55.288999999999994, face_z_bot=47.689, constricted=False, throat_dia_required=52.3, clearances=ElementClearances(axial=0.2, radial=0.3)), Element(code='L11561', type='ACH', dia=38.5, edge_thk=7.5, spacing=31.489, face_z_top=35.939, face_z_bot=27.039, constricted=False, throat_dia_required=38.8, clearances=ElementClearances(axial=0.2, radial=0.3)), Element(code='amz-150', type='PCX', dia=50.0, edge_thk=2.0, spacing=9.489, face_z_top=11.189, face_z_bot=7.789000000000001, constricted=False, throat_dia_required=50.3, clearances=ElementClearances(axial=0.2, radial=0.3)))
        //  max_upper_ele_dia                = max((e.dia for e in unconstricted), default=0.0) = 52
        //  is_wide                          = max_upper_ele_dia > lower_outer_id = false
        //  expansion_funnel_len             = min((e.face_z_bot for e in unconstricted), default=inf) = 7.789
        //  upper_housing_len                = max((e.face_z_top for e in elements)) = 55.289
        //  upper_housing_od                 = max_upper_ele_dia + 2 * upper_barrel_thk if is_wide else flange_flange_od = 68.1
        //  slot_lo                          = stop.spacing - (stop.thk + stop.clr) / 2 = 18.439
        //  upper_floor                      = expansion_funnel_len if is_wide else mount_offset + flange_flange_len = 10
        union() {
            difference() {
                union() {
                    difference() {
                        union() {
                            // HousingSection
                            //  bot_id        = 53  (input)
                            //  thk           = 1.5  (input)
                            //  top_id        = 53  (input)
                            //  top_overshoot = 0.01  (input)
                            //  z_bot         = -7.3  (input)
                            //  z_top         = 5  (input)
                            translate([0, 0, -7.3]) {
                                // Tube
                                //  h  = 12.31  (input)
                                //  id = 53  (input)
                                //  od = 56  (input)
                                difference() {
                                    cylinder(h=12.31, r=28, center=false);
                                    translate([0, 0, -0.01]) {
                                        scale([1, 1, 1.00162]) {
                                            cylinder(h=12.31, r=26.5, center=false);
                                        }
                                    }
                                }
                            }
                            // HousingSection
                            //  bot_id        = 53  (input)
                            //  thk           = 7.55  (input)
                            //  top_id        = 53  (input)
                            //  top_overshoot = 0.01  (input)
                            //  z_bot         = 5  (input)
                            //  z_top         = 10  (input)
                            translate([0, 0, 5]) {
                                // Tube
                                //  h  = 5.01  (input)
                                //  id = 53  (input)
                                //  od = 68.1  (input)
                                difference() {
                                    cylinder(h=5.01, r=34.05, center=false);
                                    translate([0, 0, -0.01]) {
                                        scale([1, 1, 1.00399]) {
                                            cylinder(h=5.01, r=26.5, center=false);
                                        }
                                    }
                                }
                            }
                            // HousingSection
                            //  bot_id = 53  (input)
                            //  thk    = 7.55  (input)
                            //  top_id = 53  (input)
                            //  z_bot  = 10  (input)
                            //  z_top  = 55.289  (input)
                            translate([0, 0, 10]) {
                                // Tube
                                //  h  = 45.289  (input)
                                //  id = 53  (input)
                                //  od = 68.1  (input)
                                difference() {
                                    cylinder(h=45.289, r=34.05, center=false);
                                    translate([0, 0, -0.01]) {
                                        scale([1, 1, 1.00044]) {
                                            cylinder(h=45.289, r=26.5, center=false);
                                        }
                                    }
                                }
                            }
                            // HousingSection
                            //  bot_id = 56  (input)
                            //  thk    = 1.825  (input)
                            //  top_id = 56  (input)
                            //  z_bot  = 1.2  (input)
                            //  z_top  = 5  (input)
                            translate([0, 0, 1.2]) {
                                // Tube
                                //  h  = 3.8  (input)
                                //  id = 56  (input)
                                //  od = 59.65  (input)
                                difference() {
                                    cylinder(h=3.8, r=29.825, center=false);
                                    translate([0, 0, -0.01]) {
                                        scale([1, 1, 1.00526]) {
                                            cylinder(h=3.8, r=28, center=false);
                                        }
                                    }
                                }
                            }
                        }
                        translate([0, 0, 18.439]) {
                            intersection() {
                                // Tube
                                //  h  = 2  (input)
                                //  id = 52.9  (input)
                                //  od = 69.1  (input)
                                difference() {
                                    cylinder(h=2, r=34.55, center=false);
                                    translate([0, 0, -0.01]) {
                                        scale([1, 1, 1.01]) {
                                            cylinder(h=2, r=26.45, center=false);
                                        }
                                    }
                                }
                                translate([0, 35.241, 0]) {
                                    cube([70.482, 70.482, 70.482], center=true);
                                }
                            }
                        }
                        translate([0, 34.06, 5]) {
                            rotate([90, 0, 0]) {
                                linear_extrude(height=4.245, center=false) {
                                    polygon(points=[[-0.25, -0.01], [0.25, -0.01], [0, 0.3]]);
                                }
                            }
                        }
                        union() {
                            rotate([0, 0, -15]) {
                                translate([0, 0, 14.339]) {
                                    linear_extrude(height=10.2, center=false) {
                                        polygon(points=[[34.06, -1], [34.06, 1], [32.45, 0]]);
                                    }
                                }
                            }
                            rotate([0, 0, 195]) {
                                translate([0, 0, 14.339]) {
                                    linear_extrude(height=10.2, center=false) {
                                        polygon(points=[[34.06, -1], [34.06, 1], [32.45, 0]]);
                                    }
                                }
                            }
                        }
                    }
                    rotate([0, 0, -15]) {
                        rotate_extrude(angle=210) {
                            polygon(points=[[34.04, 24.739], [36.55, 24.739], [34.04, 27.239]]);
                        }
                    }
                    rotate([0, 0, -15]) {
                        rotate_extrude(angle=210) {
                            polygon(points=[[34.04, 14.139], [36.55, 14.139], [34.04, 11.639]]);
                        }
                    }
                    rotate([0, 0, -5]) {
                        translate([0, 0, 1.2]) {
                            linear_extrude(height=3.8, center=false) {
                                polygon(points=[[29.815, -3], [32.225, -3], [32.225, 3], [29.815, 3]]);
                            }
                        }
                    }
                    rotate([0, 0, 125]) {
                        translate([0, 0, 1.2]) {
                            linear_extrude(height=3.8, center=false) {
                                polygon(points=[[29.815, -3], [32.225, -3], [32.225, 3], [29.815, 3]]);
                            }
                        }
                    }
                    rotate_extrude() {
                        polygon(points=[[29.815, 3.25], [30.025, 3.75], [29.815, 4.25]]);
                    }
                }
                rotate_extrude() {
                    polygon(points=[[34.06, 62.6409], [34.06, 64.3409], [33.65, 63.4909]]);
                }
            }
            // ElementHolder
            //  element    = Element(code='L7325', type='NMN', dia=52.0, edge_thk=6.2, spacing=51.489, face_z_top=55.288999999999994, face_z_bot=47.689, constricted=False, throat_dia_required=52.3, clearances=ElementClearances(axial=0.2, radial=0.3))  (input)
            //  grip_depth = 1.5  (input)
            //  grip_width = 1  (input)
            //  od         = 53.02  (input)
            union() {
                translate([0, 0, 47.689]) {
                    // Tube
                    //  h  = 7.6  (input)
                    //  id = 52.3  (input)
                    //  od = 53.02  (input)
                    difference() {
                        cylinder(h=7.6, r=26.51, center=false);
                        translate([0, 0, -0.01]) {
                            scale([1, 1, 1.00263]) {
                                cylinder(h=7.6, r=26.15, center=false);
                            }
                        }
                    }
                }
                translate([0, 0, 47.689]) {
                    // Tube
                    //  h  = 0.5  (input)
                    //  id = 50.5  (input)
                    //  od = 53.02  (input)
                    difference() {
                        cylinder(h=0.5, r=26.51, center=false);
                        translate([0, 0, -0.01]) {
                            scale([1, 1, 1.04]) {
                                cylinder(h=0.5, r=25.25, center=false);
                            }
                        }
                    }
                }
                translate([0, 0, 54.789]) {
                    // Tube
                    //  h  = 0.5  (input)
                    //  id = 50.5  (input)
                    //  od = 53.02  (input)
                    difference() {
                        cylinder(h=0.5, r=26.51, center=false);
                        translate([0, 0, -0.01]) {
                            scale([1, 1, 1.04]) {
                                cylinder(h=0.5, r=25.25, center=false);
                            }
                        }
                    }
                }
            }
            // ElementHolder
            //  element    = Element(code='L11561', type='ACH', dia=38.5, edge_thk=7.5, spacing=31.489, face_z_top=35.939, face_z_bot=27.039, constricted=False, throat_dia_required=38.8, clearances=ElementClearances(axial=0.2, radial=0.3))  (input)
            //  grip_depth = 1.5  (input)
            //  grip_width = 1  (input)
            //  od         = 53.02  (input)
            union() {
                translate([0, 0, 27.039]) {
                    // Tube
                    //  h  = 8.9  (input)
                    //  id = 38.8  (input)
                    //  od = 53.02  (input)
                    difference() {
                        cylinder(h=8.9, r=26.51, center=false);
                        translate([0, 0, -0.01]) {
                            scale([1, 1, 1.00225]) {
                                cylinder(h=8.9, r=19.4, center=false);
                            }
                        }
                    }
                }
                translate([0, 0, 27.039]) {
                    // Tube
                    //  h  = 0.5  (input)
                    //  id = 37  (input)
                    //  od = 53.02  (input)
                    difference() {
                        cylinder(h=0.5, r=26.51, center=false);
                        translate([0, 0, -0.01]) {
                            scale([1, 1, 1.04]) {
                                cylinder(h=0.5, r=18.5, center=false);
                            }
                        }
                    }
                }
                translate([0, 0, 35.439]) {
                    // Tube
                    //  h  = 0.5  (input)
                    //  id = 37  (input)
                    //  od = 53.02  (input)
                    difference() {
                        cylinder(h=0.5, r=26.51, center=false);
                        translate([0, 0, -0.01]) {
                            scale([1, 1, 1.04]) {
                                cylinder(h=0.5, r=18.5, center=false);
                            }
                        }
                    }
                }
            }
            // ElementHolder
            //  element    = Element(code='amz-150', type='PCX', dia=50.0, edge_thk=2.0, spacing=9.489, face_z_top=11.189, face_z_bot=7.789000000000001, constricted=False, throat_dia_required=50.3, clearances=ElementClearances(axial=0.2, radial=0.3))  (input)
            //  grip_depth = 1.5  (input)
            //  grip_width = 1  (input)
            //  od         = 53.02  (input)
            union() {
                translate([0, 0, 7.789]) {
                    // Tube
                    //  h  = 3.4  (input)
                    //  id = 50.3  (input)
                    //  od = 53.02  (input)
                    difference() {
                        cylinder(h=3.4, r=26.51, center=false);
                        translate([0, 0, -0.01]) {
                            scale([1, 1, 1.00588]) {
                                cylinder(h=3.4, r=25.15, center=false);
                            }
                        }
                    }
                }
                translate([0, 0, 7.789]) {
                    // Tube
                    //  h  = 0.5  (input)
                    //  id = 48.5  (input)
                    //  od = 53.02  (input)
                    difference() {
                        cylinder(h=0.5, r=26.51, center=false);
                        translate([0, 0, -0.01]) {
                            scale([1, 1, 1.04]) {
                                cylinder(h=0.5, r=24.25, center=false);
                            }
                        }
                    }
                }
                translate([0, 0, 10.689]) {
                    // Tube
                    //  h  = 0.5  (input)
                    //  id = 48.5  (input)
                    //  od = 53.02  (input)
                    difference() {
                        cylinder(h=0.5, r=26.51, center=false);
                        translate([0, 0, -0.01]) {
                            scale([1, 1, 1.04]) {
                                cylinder(h=0.5, r=24.25, center=false);
                            }
                        }
                    }
                }
            }
            // StopHolder
            //  barrel_id  = 53  (input)
            //  grip_depth = 1.5  (input)
            //  grip_width = 1  (input)
            //  od_bot     = 68.1  (input)
            //  od_top     = 68.1  (input)
            //  stop       = [19.439, 1.5, 0.5]  (input)
            color("green") {
                translate([0, 0, 19.439]) {
                    union() {
                        translate([0, 0, 1]) {
                            // Tube
                            //  h  = 0.5  (input)
                            //  id = 51.5  (input)
                            //  od = 68.1  (input)
                            difference() {
                                cylinder(h=0.5, r=34.05, center=false);
                                translate([0, 0, -0.01]) {
                                    scale([1, 1, 1.04]) {
                                        cylinder(h=0.5, r=25.75, center=false);
                                    }
                                }
                            }
                        }
                        translate([0, 0, -1.5]) {
                            // Tube
                            //  h  = 0.5  (input)
                            //  id = 51.5  (input)
                            //  od = 68.1  (input)
                            difference() {
                                cylinder(h=0.5, r=34.05, center=false);
                                translate([0, 0, -0.01]) {
                                    scale([1, 1, 1.04]) {
                                        cylinder(h=0.5, r=25.75, center=false);
                                    }
                                }
                            }
                        }
                    }
                }
            }
            difference() {
                translate([0, 0, 55.279]) {
                    // TruncFilletRing
                    //  base_angle = 69  (input)
                    //  id         = 55.5  (input)
                    //  od         = 68.1  (input)
                    //  rim_width  = 2  (input)
                    //  slant      = 'inwards'  (input)
                    //  h_full     = tan(base_angle) * (od - id) / 2 = 16.4121
                    //  z_t        = tan(base_angle) * ((od - id) / 2 - rim_width) = 11.2019
                    difference() {
                        // FilletRing
                        //  base_angle = 69  (input)
                        //  id         = 55.5  (input)
                        //  od         = 68.1  (input)
                        //  slant      = 'inwards'  (input)
                        difference() {
                            cylinder(h=16.4121, r=34.05, center=false);
                            translate([0, 0, -0.0681]) {
                                cylinder(h=16.5483, r1=27.75, r2=34.1181, center=false);
                            }
                        }
                        translate([0, 0, -0.0215]) {
                            scale([1, 1, 1.00192]) {
                                translate([0, 0, 11.2019]) {
                                    cylinder(h=5.21018, r=34.06, center=false);
                                }
                            }
                        }
                    }
                }
                rotate_extrude() {
                    polygon(points=[[34.06, 62.6409], [34.06, 64.3409], [33.65, 63.4909]]);
                }
            }
        }
        union() {
            translate([0, 0, 11.2417]) {
                union() {
                    translate([32.7831, -6.59567, 43.8445]) {
                        multmatrix([[0.197239, 0, 0.980355, 0], [0.980355, 0, -0.197239, 0], [0, 1, 0, 0], [0, 0, 0, 1]]) {
                            linear_extrude(height=1.11, center=false) {
                                translate([-1.76293, -2, 0]) {
                                    text("v", size=4, font="Verdana:style=Bold");
                                }
                            }
                        }
                    }
                    translate([33.3043, -3.00984, 43.8445]) {
                        multmatrix([[0.0900071, 0, 0.995941, 0], [0.995941, 0, -0.0900071, 0], [0, 1, 0, 0], [0, 0, 0, 1]]) {
                            linear_extrude(height=1.11, center=false) {
                                translate([-1.92849, -2, 0]) {
                                    text("1", size=4, font="Verdana:style=Bold");
                                }
                            }
                        }
                    }
                    translate([33.431, 0.773897, 43.8445]) {
                        multmatrix([[-0.0231429, 0, 0.999732, 0], [0.999732, 0, 0.0231429, 0], [0, 1, 0, 0], [0, 0, 0, 1]]) {
                            linear_extrude(height=1.11, center=false) {
                                translate([-1.92849, -2, 0]) {
                                    text("4", size=4, font="Verdana:style=Bold");
                                }
                            }
                        }
                    }
                    translate([33.1447, 4.43428, 43.8445]) {
                        multmatrix([[-0.132604, 0, 0.991169, 0], [0.991169, 0, 0.132604, 0], [0, 1, 0, 0], [0, 0, 0, 1]]) {
                            linear_extrude(height=1.11, center=false) {
                                translate([-1.81193, -2, 0]) {
                                    text("a", size=4, font="Verdana:style=Bold");
                                }
                            }
                        }
                    }
                    translate([32.6466, 7.24088, 43.8445]) {
                        multmatrix([[-0.216534, 0, 0.976275, 0], [0.976275, 0, 0.216534, 0], [0, 1, 0, 0], [0, 0, 0, 1]]) {
                            linear_extrude(height=1.11, center=false) {
                                translate([-1.0914, -2, 0]) {
                                    text(":", size=4, font="Verdana:style=Bold");
                                }
                            }
                        }
                    }
                    translate([32.5855, -7.51113, 38.2445]) {
                        multmatrix([[0.224615, 0, 0.974448, 0], [0.974448, 0, -0.224615, 0], [0, 1, 0, 0], [0, 0, 0, 1]]) {
                            linear_extrude(height=1.11, center=false) {
                                translate([-1.72849, -2, 0]) {
                                    text("L", size=4, font="Verdana:style=Bold");
                                }
                            }
                        }
                    }
                    translate([33.2029, -3.97488, 38.2445]) {
                        multmatrix([[0.118866, 0, 0.99291, 0], [0.99291, 0, -0.118866, 0], [0, 1, 0, 0], [0, 0, 0, 1]]) {
                            linear_extrude(height=1.11, center=false) {
                                translate([-1.92849, -2, 0]) {
                                    text("7", size=4, font="Verdana:style=Bold");
                                }
                            }
                        }
                    }
                    translate([33.4394, -0.196417, 38.2445]) {
                        multmatrix([[0.00587372, 0, 0.999983, 0], [0.999983, 0, -0.00587372, 0], [0, 1, 0, 0], [0, 0, 0, 1]]) {
                            linear_extrude(height=1.11, center=false) {
                                translate([-1.92849, -2, 0]) {
                                    text("3", size=4, font="Verdana:style=Bold");
                                }
                            }
                        }
                    }
                    translate([33.2473, 3.58456, 38.2445]) {
                        multmatrix([[-0.107194, 0, 0.994238, 0], [0.994238, 0, 0.107194, 0], [0, 1, 0, 0], [0, 0, 0, 1]]) {
                            linear_extrude(height=1.11, center=false) {
                                translate([-1.92849, -2, 0]) {
                                    text("2", size=4, font="Verdana:style=Bold");
                                }
                            }
                        }
                    }
                    translate([32.6291, 7.3196, 38.2445]) {
                        multmatrix([[-0.218887, 0, 0.97575, 0], [0.97575, 0, 0.218887, 0], [0, 1, 0, 0], [0, 0, 0, 1]]) {
                            linear_extrude(height=1.11, center=false) {
                                translate([-1.92849, -2, 0]) {
                                    text("5", size=4, font="Verdana:style=Bold");
                                }
                            }
                        }
                    }
                    translate([32.1081, -9.34364, 32.6445]) {
                        multmatrix([[0.279415, 0, 0.96017, 0], [0.96017, 0, -0.279415, 0], [0, 1, 0, 0], [0, 0, 0, 1]]) {
                            linear_extrude(height=1.11, center=false) {
                                translate([-1.72849, -2, 0]) {
                                    text("L", size=4, font="Verdana:style=Bold");
                                }
                            }
                        }
                    }
                    translate([32.9247, -5.84801, 32.6445]) {
                        multmatrix([[0.174881, 0, 0.98459, 0], [0.98459, 0, -0.174881, 0], [0, 1, 0, 0], [0, 0, 0, 1]]) {
                            linear_extrude(height=1.11, center=false) {
                                translate([-1.92849, -2, 0]) {
                                    text("1", size=4, font="Verdana:style=Bold");
                                }
                            }
                        }
                    }
                    translate([33.3747, -2.089, 32.6445]) {
                        multmatrix([[0.06247, 0, 0.998047, 0], [0.998047, 0, -0.06247, 0], [0, 1, 0, 0], [0, 0, 0, 1]]) {
                            linear_extrude(height=1.11, center=false) {
                                translate([-1.92849, -2, 0]) {
                                    text("1", size=4, font="Verdana:style=Bold");
                                }
                            }
                        }
                    }
                    translate([33.3969, 1.69679, 32.6445]) {
                        multmatrix([[-0.0507414, 0, 0.998712, 0], [0.998712, 0, 0.0507414, 0], [0, 1, 0, 0], [0, 0, 0, 1]]) {
                            linear_extrude(height=1.11, center=false) {
                                translate([-1.92849, -2, 0]) {
                                    text("5", size=4, font="Verdana:style=Bold");
                                }
                            }
                        }
                    }
                    translate([32.9911, 5.46084, 32.6445]) {
                        multmatrix([[-0.163303, 0, 0.986576, 0], [0.986576, 0, 0.163303, 0], [0, 1, 0, 0], [0, 0, 0, 1]]) {
                            linear_extrude(height=1.11, center=false) {
                                translate([-1.92849, -2, 0]) {
                                    text("6", size=4, font="Verdana:style=Bold");
                                }
                            }
                        }
                    }
                    translate([32.1624, 9.15489, 32.6445]) {
                        multmatrix([[-0.273771, 0, 0.961795, 0], [0.961795, 0, 0.273771, 0], [0, 1, 0, 0], [0, 0, 0, 1]]) {
                            linear_extrude(height=1.11, center=false) {
                                translate([-1.92849, -2, 0]) {
                                    text("1", size=4, font="Verdana:style=Bold");
                                }
                            }
                        }
                    }
                    translate([31.526, -11.1511, 27.0445]) {
                        multmatrix([[0.333466, 0, 0.942762, 0], [0.942762, 0, -0.333466, 0], [0, 1, 0, 0], [0, 0, 0, 1]]) {
                            linear_extrude(height=1.11, center=false) {
                                translate([-1.81193, -2, 0]) {
                                    text("a", size=4, font="Verdana:style=Bold");
                                }
                            }
                        }
                    }
                    translate([32.7569, -6.72441, 27.0445]) {
                        multmatrix([[0.201089, 0, 0.979573, 0], [0.979573, 0, -0.201089, 0], [0, 1, 0, 0], [0, 0, 0, 1]]) {
                            linear_extrude(height=1.11, center=false) {
                                translate([-2.87022, -2, 0]) {
                                    text("m", size=4, font="Verdana:style=Bold");
                                }
                            }
                        }
                    }
                    translate([33.3566, -2.36026, 27.0445]) {
                        multmatrix([[0.0705819, 0, 0.997506, 0], [0.997506, 0, -0.0705819, 0], [0, 1, 0, 0], [0, 0, 0, 1]]) {
                            linear_extrude(height=1.11, center=false) {
                                translate([-1.61855, -2, 0]) {
                                    text("z", size=4, font="Verdana:style=Bold");
                                }
                            }
                        }
                    }
                    translate([33.4362, 0.505985, 27.0445]) {
                        multmatrix([[-0.0151311, 0, 0.999886, 0], [0.999886, 0, 0.0151311, 0], [0, 1, 0, 0], [0, 0, 0, 1]]) {
                            linear_extrude(height=1.11, center=false) {
                                translate([-1.302, -2, 0]) {
                                    text("-", size=4, font="Verdana:style=Bold");
                                }
                            }
                        }
                    }
                    translate([33.2379, 3.6712, 27.0445]) {
                        multmatrix([[-0.109785, 0, 0.993955, 0], [0.993955, 0, 0.109785, 0], [0, 1, 0, 0], [0, 0, 0, 1]]) {
                            linear_extrude(height=1.11, center=false) {
                                translate([-1.92849, -2, 0]) {
                                    text("1", size=4, font="Verdana:style=Bold");
                                }
                            }
                        }
                    }
                    translate([32.6099, 7.40461, 27.0445]) {
                        multmatrix([[-0.22143, 0, 0.975176, 0], [0.975176, 0, 0.22143, 0], [0, 1, 0, 0], [0, 0, 0, 1]]) {
                            linear_extrude(height=1.11, center=false) {
                                translate([-1.92849, -2, 0]) {
                                    text("5", size=4, font="Verdana:style=Bold");
                                }
                            }
                        }
                    }
                    translate([31.564, 11.0431, 27.0445]) {
                        multmatrix([[-0.330237, 0, 0.943898, 0], [0.943898, 0, 0.330237, 0], [0, 1, 0, 0], [0, 0, 0, 1]]) {
                            linear_extrude(height=1.11, center=false) {
                                translate([-1.92849, -2, 0]) {
                                    text("0", size=4, font="Verdana:style=Bold");
                                }
                            }
                        }
                    }
                    translate([31.635, -10.8378, 21.4445]) {
                        multmatrix([[0.324098, 0, 0.946023, 0], [0.946023, 0, -0.324098, 0], [0, 1, 0, 0], [0, 0, 0, 1]]) {
                            linear_extrude(height=1.11, center=false) {
                                translate([-1.8967, -2, 0]) {
                                    text("d", size=4, font="Verdana:style=Bold");
                                }
                            }
                        }
                    }
                    translate([32.6506, -7.2231, 21.4445]) {
                        multmatrix([[0.216002, 0, 0.976393, 0], [0.976393, 0, -0.216002, 0], [0, 1, 0, 0], [0, 0, 0, 1]]) {
                            linear_extrude(height=1.11, center=false) {
                                translate([-1.92849, -2, 0]) {
                                    text("8", size=4, font="Verdana:style=Bold");
                                }
                            }
                        }
                    }
                    translate([33.2578, -3.48626, 21.4445]) {
                        multmatrix([[0.104254, 0, 0.994551, 0], [0.994551, 0, -0.104254, 0], [0, 1, 0, 0], [0, 0, 0, 1]]) {
                            linear_extrude(height=1.11, center=false) {
                                translate([-1.92849, -2, 0]) {
                                    text("2", size=4, font="Verdana:style=Bold");
                                }
                            }
                        }
                    }
                    translate([33.4387, 0.295274, 21.4445]) {
                        multmatrix([[-0.00882996, 0, 0.999961, 0], [0.999961, 0, 0.00882996, 0], [0, 1, 0, 0], [0, 0, 0, 1]]) {
                            linear_extrude(height=1.11, center=false) {
                                translate([-1.92849, -2, 0]) {
                                    text("4", size=4, font="Verdana:style=Bold");
                                }
                            }
                        }
                    }
                    translate([33.2292, 3.74877, 21.4445]) {
                        multmatrix([[-0.112104, 0, 0.993696, 0], [0.993696, 0, 0.112104, 0], [0, 1, 0, 0], [0, 0, 0, 1]]) {
                            linear_extrude(height=1.11, center=false) {
                                translate([-1.59604, -2, 0]) {
                                    text("c", size=4, font="Verdana:style=Bold");
                                }
                            }
                        }
                    }
                    translate([32.664, 7.16213, 21.4445]) {
                        multmatrix([[-0.214178, 0, 0.976795, 0], [0.976795, 0, 0.214178, 0], [0, 1, 0, 0], [0, 0, 0, 1]]) {
                            linear_extrude(height=1.11, center=false) {
                                translate([-1.92849, -2, 0]) {
                                    text("4", size=4, font="Verdana:style=Bold");
                                }
                            }
                        }
                    }
                    translate([31.6451, 10.8083, 21.4445]) {
                        multmatrix([[-0.323215, 0, 0.946326, 0], [0.946326, 0, 0.323215, 0], [0, 1, 0, 0], [0, 0, 0, 1]]) {
                            linear_extrude(height=1.11, center=false) {
                                translate([-1.92849, -2, 0]) {
                                    text("3", size=4, font="Verdana:style=Bold");
                                }
                            }
                        }
                    }
                }
            }
            translate([15.162, 26.4759, 60.8899]) {
                multmatrix([[0.867779, 0.178091, -0.463943, 0], [-0.49695, 0.310984, -0.810142, 0], [0, 0.93358, 0.358368, 0], [0, 0, 0, 1]]) {
                    linear_extrude(height=1.11, center=false) {
                        translate([-1.95413, -1.89149, 0]) {
                            text("B", size=3.78297, font="Verdana:style=Bold");
                        }
                    }
                }
            }
            translate([18.5261, 24.2413, 60.8899]) {
                multmatrix([[0.794537, 0.217607, -0.566885, 0], [-0.607216, 0.284737, -0.741764, 0], [0, 0.93358, 0.358368, 0], [0, 0, 0, 1]]) {
                    linear_extrude(height=1.11, center=false) {
                        translate([-2.00674, -1.89149, 0]) {
                            text("R", size=3.78297, font="Verdana:style=Bold");
                        }
                    }
                }
            }
            translate([21.1624, 21.9776, 60.8899]) {
                multmatrix([[0.72034, 0.248572, -0.647552, 0], [-0.693622, 0.258147, -0.672495, 0], [0, 0.93358, 0.358368, 0], [0, 0, 0, 1]]) {
                    linear_extrude(height=1.11, center=false) {
                        translate([-1.40046, -1.89149, 0]) {
                            text("I", size=3.78297, font="Verdana:style=Bold");
                        }
                    }
                }
            }
            translate([23.6369, 19.2914, 60.8899]) {
                multmatrix([[0.632298, 0.277637, -0.723269, 0], [-0.774726, 0.226595, -0.590301, 0], [0, 0.93358, 0.358368, 0], [0, 0, 0, 1]]) {
                    linear_extrude(height=1.11, center=false) {
                        translate([-2.18086, -1.89149, 0]) {
                            text("O", size=3.78297, font="Verdana:style=Bold");
                        }
                    }
                }
            }
            translate([25.9611, 16.0275, 60.8899]) {
                multmatrix([[0.525321, 0.304937, -0.794388, 0], [-0.850904, 0.188258, -0.490429, 0], [0, 0.93358, 0.358368, 0], [0, 0, 0, 1]]) {
                    linear_extrude(height=1.11, center=false) {
                        translate([-1.7487, -1.89149, 0]) {
                            text("T", size=3.78297, font="Verdana:style=Bold");
                        }
                    }
                }
            }
            translate([27.758, 12.6631, 60.8899]) {
                multmatrix([[0.415047, 0.326043, -0.849371, 0], [-0.9098, 0.14874, -0.38748, 0], [0, 0.93358, 0.358368, 0], [0, 0, 0, 1]]) {
                    linear_extrude(height=1.11, center=false) {
                        translate([-1.99171, -1.89149, 0]) {
                            text("A", size=3.78297, font="Verdana:style=Bold");
                        }
                    }
                }
            }
            translate([29.1985, 8.84908, 60.8899]) {
                multmatrix([[0.290039, 0.342963, -0.89345, 0], [-0.957015, 0.103941, -0.270775, 0], [0, 0.93358, 0.358368, 0], [0, 0, 0, 1]]) {
                    linear_extrude(height=1.11, center=false) {
                        translate([-2.00674, -1.89149, 0]) {
                            text("R", size=3.78297, font="Verdana:style=Bold");
                        }
                    }
                }
            }
            translate([29.9149, 5.99638, 60.8899]) {
                multmatrix([[0.196538, 0.351378, -0.915372, 0], [-0.980496, 0.070433, -0.183484, 0], [0, 0.93358, 0.358368, 0], [0, 0, 0, 1]]) {
                    linear_extrude(height=1.11, center=false) {
                        translate([-0.876853, -1.89149, 0]) {
                            text(" ", size=3.78297, font="Verdana:style=Bold");
                        }
                    }
                }
            }
            translate([30.3339, 3.27356, 60.8899]) {
                multmatrix([[0.107295, 0.356299, -0.928191, 0], [-0.994227, 0.0384509, -0.100168, 0], [0, 0.93358, 0.358368, 0], [0, 0, 0, 1]]) {
                    linear_extrude(height=1.11, center=false) {
                        translate([-1.82385, -1.89149, 0]) {
                            text("1", size=3.78297, font="Verdana:style=Bold");
                        }
                    }
                }
            }
            translate([30.5068, -0.442243, 60.8899]) {
                multmatrix([[-0.014495, 0.35833, -0.933482, 0], [-0.999895, -0.00519455, 0.0135323, 0], [0, 0.93358, 0.358368, 0], [0, 0, 0, 1]]) {
                    linear_extrude(height=1.11, center=false) {
                        translate([-1.82385, -1.89149, 0]) {
                            text("0", size=3.78297, font="Verdana:style=Bold");
                        }
                    }
                }
            }
            translate([30.2262, -4.15147, 60.8899]) {
                multmatrix([[-0.136069, 0.355035, -0.924898, 0], [-0.990699, -0.0487628, 0.127031, 0], [0, 0.93358, 0.358368, 0], [0, 0, 0, 1]]) {
                    linear_extrude(height=1.11, center=false) {
                        translate([-1.82385, -1.89149, 0]) {
                            text("1", size=3.78297, font="Verdana:style=Bold");
                        }
                    }
                }
            }
            translate([29.251, -8.674, 60.8899]) {
                multmatrix([[-0.2843, 0.34358, -0.895057, 0], [-0.958735, -0.101884, 0.265417, 0], [0, 0.93358, 0.358368, 0], [0, 0, 0, 1]]) {
                    linear_extrude(height=1.11, center=false) {
                        translate([-2.71449, -1.89149, 0]) {
                            text("m", size=3.78297, font="Verdana:style=Bold");
                        }
                    }
                }
            }
            translate([27.2039, -13.8134, 60.8899]) {
                multmatrix([[-0.45275, 0.319534, -0.832415, 0], [-0.891637, -0.162251, 0.422679, 0], [0, 0.93358, 0.358368, 0], [0, 0, 0, 1]]) {
                    linear_extrude(height=1.11, center=false) {
                        translate([-2.71449, -1.89149, 0]) {
                            text("m", size=3.78297, font="Verdana:style=Bold");
                        }
                    }
                }
            }
            translate([25.3527, -16.9735, 60.8899]) {
                multmatrix([[-0.556327, 0.297791, -0.775771, 0], [-0.830963, -0.19937, 0.519376, 0], [0, 0.93358, 0.358368, 0], [0, 0, 0, 1]]) {
                    linear_extrude(height=1.11, center=false) {
                        translate([-0.876853, -1.89149, 0]) {
                            text(" ", size=3.78297, font="Verdana:style=Bold");
                        }
                    }
                }
            }
            translate([24.1861, -18.5981, 60.8899]) {
                multmatrix([[-0.609575, 0.284088, -0.740076, 0], [-0.792729, -0.218452, 0.569087, 0], [0, 0.93358, 0.358368, 0], [0, 0, 0, 1]]) {
                    linear_extrude(height=1.11, center=false) {
                        translate([-1.08354, -1.89149, 0]) {
                            text("f", size=3.78297, font="Verdana:style=Bold");
                        }
                    }
                }
            }
            translate([22.3047, -20.8173, 60.8899]) {
                multmatrix([[-0.68231, 0.261989, -0.682506, 0], [-0.731063, -0.244518, 0.636991, 0], [0, 0.93358, 0.358368, 0], [0, 0, 0, 1]]) {
                    linear_extrude(height=1.11, center=false) {
                        translate([-1.76874, -1.89149, 0]) {
                            text("/", size=3.78297, font="Verdana:style=Bold");
                        }
                    }
                }
            }
            translate([19.6487, -23.3407, 60.8899]) {
                multmatrix([[-0.76502, 0.230791, -0.601232, 0], [-0.644007, -0.274158, 0.714207, 0], [0, 0.93358, 0.358368, 0], [0, 0, 0, 1]]) {
                    linear_extrude(height=1.11, center=false) {
                        translate([-1.82385, -1.89149, 0]) {
                            text("2", size=3.78297, font="Verdana:style=Bold");
                        }
                    }
                }
            }
            translate([17.4212, -25.0472, 60.8899]) {
                multmatrix([[-0.82095, 0.204628, -0.533075, 0], [-0.571001, -0.294202, 0.766423, 0], [0, 0.93358, 0.358368, 0], [0, 0, 0, 1]]) {
                    linear_extrude(height=1.11, center=false) {
                        translate([-0.926959, -1.89149, 0]) {
                            text(".", size=3.78297, font="Verdana:style=Bold");
                        }
                    }
                }
            }
            translate([15.0465, -26.5417, 60.8899]) {
                multmatrix([[-0.869936, 0.176734, -0.460409, 0], [-0.493165, -0.311757, 0.812155, 0], [0, 0.93358, 0.358368, 0], [0, 0, 0, 1]]) {
                    linear_extrude(height=1.11, center=false) {
                        translate([-1.82385, -1.89149, 0]) {
                            text("9", size=3.78297, font="Verdana:style=Bold");
                        }
                    }
                }
            }
            translate([-27.7521, -12.6759, 60.8899]) {
                multmatrix([[-0.415468, -0.325974, 0.849192, 0], [0.909608, -0.14889, 0.387872, 0], [0, 0.93358, 0.358368, 0], [0, 0, 0, 1]]) {
                    linear_extrude(height=1.11, center=false) {
                        translate([-1.76585, -1.88174, 0]) {
                            text("Z", size=3.76348, font="Verdana:style=Bold");
                        }
                    }
                }
            }
            translate([-29.0303, -9.38619, 60.8899]) {
                multmatrix([[-0.307643, -0.340988, 0.888303, 0], [0.951502, -0.110249, 0.28721, 0], [0, 0.93358, 0.358368, 0], [0, 0, 0, 1]]) {
                    linear_extrude(height=1.11, center=false) {
                        translate([-1.69482, -1.88174, 0]) {
                            text("e", size=3.76348, font="Verdana:style=Bold");
                        }
                    }
                }
            }
            translate([-29.9304, -5.91849, 60.8899]) {
                multmatrix([[-0.193985, -0.351561, 0.915847, 0], [0.981004, -0.0695181, 0.181101, 0], [0, 0.93358, 0.358368, 0], [0, 0, 0, 1]]) {
                    linear_extrude(height=1.11, center=false) {
                        translate([-1.81819, -1.88174, 0]) {
                            text("n", size=3.76348, font="Verdana:style=Bold");
                        }
                    }
                }
            }
            translate([-30.4037, -2.54409, 60.8899]) {
                multmatrix([[-0.0833855, -0.35712, 0.930329, 0], [0.996517, -0.0298827, 0.077847, 0], [0, 0.93358, 0.358368, 0], [0, 0, 0, 1]]) {
                    linear_extrude(height=1.11, center=false) {
                        translate([-1.52285, -1.88174, 0]) {
                            text("z", size=3.76348, font="Verdana:style=Bold");
                        }
                    }
                }
            }
            translate([-30.5009, 0.746364, 60.8899]) {
                multmatrix([[0.0244629, -0.358261, 0.933301, 0], [0.999701, 0.00876674, -0.0228381, 0], [0, 0.93358, 0.358368, 0], [0, 0, 0, 1]]) {
                    linear_extrude(height=1.11, center=false) {
                        translate([-1.70479, -1.88174, 0]) {
                            text("a", size=3.76348, font="Verdana:style=Bold");
                        }
                    }
                }
            }
            translate([-30.1501, 4.67253, 60.8899]) {
                multmatrix([[0.153148, -0.35414, 0.922567, 0], [0.988203, 0.0548832, -0.142976, 0], [0, 0.93358, 0.358368, 0], [0, 0, 0, 1]]) {
                    linear_extrude(height=1.11, center=false) {
                        translate([-2.1609, -1.88174, 0]) {
                            text("N", size=3.76348, font="Verdana:style=Bold");
                        }
                    }
                }
            }
            translate([-29.16, 8.9751, 60.8899]) {
                multmatrix([[0.294169, -0.342511, 0.892273, 0], [0.955753, 0.105421, -0.274631, 0], [0, 0.93358, 0.358368, 0], [0, 0, 0, 1]]) {
                    linear_extrude(height=1.11, center=false) {
                        translate([-2.16962, -1.88174, 0]) {
                            text("O", size=3.76348, font="Verdana:style=Bold");
                        }
                    }
                }
            }
            translate([-27.741, 12.7002, 60.8899]) {
                multmatrix([[0.416264, -0.325844, 0.848852, 0], [0.909244, 0.149176, -0.388616, 0], [0, 0.93358, 0.358368, 0], [0, 0, 0, 1]]) {
                    linear_extrude(height=1.11, center=false) {
                        translate([-1.73968, -1.88174, 0]) {
                            text("T", size=3.76348, font="Verdana:style=Bold");
                        }
                    }
                }
            }
        }
    }

    translate([0, 0, 77.6911]) {
        // S2LensHood
        //  back_label       = 'ZenzaNOT'  (input)
        //  hood_base_angle  = 69  (input)
        //  housing_upper_od = 68.1  (input)
        //  label            = 'BRIOTAR 101mm f/2.9'  (input)
        //  label_font       = 'Verdana:style=Bold'  (input)
        //  snap_axial       = 1.5  (input)
        //  snap_engage      = 0.3  (input)
        //  coupler_overlap  = 6  (default)
        //  hood_clr         = 0.15  (default)
        //  hood_length      = 34  (default)
        //  wall_thk         = 2  (default)
        //  id_coupler       = housing_upper_od + hood_clr = 68.25
        //  od_coupler       = id_coupler + 2 * wall_thk = 72.25
        //  flare_od         = housing_upper_od + 2 * hood_length * tan(90 - hood_base_angle) = 94.2028
        union() {
            // Tube
            //  h   = 6  (input)
            //  id  = 68.25  (input)
            //  thk = 2  (input)
            //  od  = id + 2 * thk = 72.25
            difference() {
                cylinder(h=6, r=36.125, center=false);
                translate([0, 0, -0.01]) {
                    scale([1, 1, 1.00333]) {
                        cylinder(h=6, r=34.125, center=false);
                    }
                }
            }
            translate([0, 0, 2.25804]) {
                union() {
                    translate([23.217, -27.0205, 3]) {
                        multmatrix([[0.758471, 0, 0.651706, 0], [0.651706, 0, -0.758471, 0], [0, 1, 0, 0], [0, 0, 0, 1]]) {
                            linear_extrude(height=1, center=false) {
                                translate([-1.9346, -1.87258, 0]) {
                                    text("B", size=3.74515, font="Verdana:style=Bold");
                                }
                            }
                        }
                    }
                    translate([26.0076, -24.3463, 3]) {
                        multmatrix([[0.683405, 0, 0.730039, 0], [0.730039, 0, -0.683405, 0], [0, 1, 0, 0], [0, 0, 0, 1]]) {
                            linear_extrude(height=1, center=false) {
                                translate([-1.98668, -1.87258, 0]) {
                                    text("R", size=3.74515, font="Verdana:style=Bold");
                                }
                            }
                        }
                    }
                    translate([28.1644, -21.8153, 3]) {
                        multmatrix([[0.61236, 0, 0.790579, 0], [0.790579, 0, -0.61236, 0], [0, 1, 0, 0], [0, 0, 0, 1]]) {
                            linear_extrude(height=1, center=false) {
                                translate([-1.38646, -1.87258, 0]) {
                                    text("I", size=3.74515, font="Verdana:style=Bold");
                                }
                            }
                        }
                    }
                    translate([30.1665, -18.9506, 3]) {
                        multmatrix([[0.531946, 0, 0.846778, 0], [0.846778, 0, -0.531946, 0], [0, 1, 0, 0], [0, 0, 0, 1]]) {
                            linear_extrude(height=1, center=false) {
                                translate([-2.15906, -1.87258, 0]) {
                                    text("O", size=3.74515, font="Verdana:style=Bold");
                                }
                            }
                        }
                    }
                    translate([32.0286, -15.5985, 3]) {
                        multmatrix([[0.437852, 0, 0.899047, 0], [0.899047, 0, -0.437852, 0], [0, 1, 0, 0], [0, 0, 0, 1]]) {
                            linear_extrude(height=1, center=false) {
                                translate([-1.73121, -1.87258, 0]) {
                                    text("T", size=3.74515, font="Verdana:style=Bold");
                                }
                            }
                        }
                    }
                    translate([33.4566, -12.2392, 3]) {
                        multmatrix([[0.343557, 0, 0.939132, 0], [0.939132, 0, -0.343557, 0], [0, 1, 0, 0], [0, 0, 0, 1]]) {
                            linear_extrude(height=1, center=false) {
                                translate([-1.9718, -1.87258, 0]) {
                                    text("A", size=3.74515, font="Verdana:style=Bold");
                                }
                            }
                        }
                    }
                    translate([34.5944, -8.50708, 3]) {
                        multmatrix([[0.238795, 0, 0.97107, 0], [0.97107, 0, -0.238795, 0], [0, 1, 0, 0], [0, 0, 0, 1]]) {
                            linear_extrude(height=1, center=false) {
                                translate([-1.98668, -1.87258, 0]) {
                                    text("R", size=3.74515, font="Verdana:style=Bold");
                                }
                            }
                        }
                    }
                    translate([35.158, -5.74956, 3]) {
                        multmatrix([[0.161391, 0, 0.986891, 0], [0.986891, 0, -0.161391, 0], [0, 1, 0, 0], [0, 0, 0, 1]]) {
                            linear_extrude(height=1, center=false) {
                                translate([-0.868088, -1.87258, 0]) {
                                    text(" ", size=3.74515, font="Verdana:style=Bold");
                                }
                            }
                        }
                    }
                    translate([35.4869, -3.13406, 3]) {
                        multmatrix([[0.0879736, 0, 0.996123, 0], [0.996123, 0, -0.0879736, 0], [0, 1, 0, 0], [0, 0, 0, 1]]) {
                            linear_extrude(height=1, center=false) {
                                translate([-1.80562, -1.87258, 0]) {
                                    text("1", size=3.74515, font="Verdana:style=Bold");
                                }
                            }
                        }
                    }
                    translate([35.6225, 0.423134, 3]) {
                        multmatrix([[-0.0118775, 0, 0.999929, 0], [0.999929, 0, 0.0118775, 0], [0, 1, 0, 0], [0, 0, 0, 1]]) {
                            linear_extrude(height=1, center=false) {
                                translate([-1.80562, -1.87258, 0]) {
                                    text("0", size=3.74515, font="Verdana:style=Bold");
                                }
                            }
                        }
                    }
                    translate([35.4024, 3.9761, 3]) {
                        multmatrix([[-0.11161, 0, 0.993752, 0], [0.993752, 0, 0.11161, 0], [0, 1, 0, 0], [0, 0, 0, 1]]) {
                            linear_extrude(height=1, center=false) {
                                translate([-1.80562, -1.87258, 0]) {
                                    text("1", size=3.74515, font="Verdana:style=Bold");
                                }
                            }
                        }
                    }
                    translate([34.6357, 8.33715, 3]) {
                        multmatrix([[-0.234025, 0, 0.972231, 0], [0.972231, 0, 0.234025, 0], [0, 1, 0, 0], [0, 0, 0, 1]]) {
                            linear_extrude(height=1, center=false) {
                                translate([-2.68735, -1.87258, 0]) {
                                    text("m", size=3.74515, font="Verdana:style=Bold");
                                }
                            }
                        }
                    }
                    translate([33.0172, 13.3792, 3]) {
                        multmatrix([[-0.375556, 0, 0.9268, 0], [0.9268, 0, 0.375556, 0], [0, 1, 0, 0], [0, 0, 0, 1]]) {
                            linear_extrude(height=1, center=false) {
                                translate([-2.68735, -1.87258, 0]) {
                                    text("m", size=3.74515, font="Verdana:style=Bold");
                                }
                            }
                        }
                    }
                    translate([31.5428, 16.5588, 3]) {
                        multmatrix([[-0.464807, 0, 0.885412, 0], [0.885412, 0, 0.464807, 0], [0, 1, 0, 0], [0, 0, 0, 1]]) {
                            linear_extrude(height=1, center=false) {
                                translate([-0.868088, -1.87258, 0]) {
                                    text(" ", size=3.74515, font="Verdana:style=Bold");
                                }
                            }
                        }
                    }
                    translate([30.6081, 18.2287, 3]) {
                        multmatrix([[-0.511682, 0, 0.859175, 0], [0.859175, 0, 0.511682, 0], [0, 1, 0, 0], [0, 0, 0, 1]]) {
                            linear_extrude(height=1, center=false) {
                                translate([-1.07271, -1.87258, 0]) {
                                    text("f", size=3.74515, font="Verdana:style=Bold");
                                }
                            }
                        }
                    }
                    translate([29.0912, 20.5631, 3]) {
                        multmatrix([[-0.57721, 0, 0.816596, 0], [0.816596, 0, 0.57721, 0], [0, 1, 0, 0], [0, 0, 0, 1]]) {
                            linear_extrude(height=1, center=false) {
                                translate([-1.75106, -1.87258, 0]) {
                                    text("/", size=3.74515, font="Verdana:style=Bold");
                                }
                            }
                        }
                    }
                    translate([26.9291, 23.3231, 3]) {
                        multmatrix([[-0.654683, 0, 0.755904, 0], [0.755904, 0, 0.654683, 0], [0, 1, 0, 0], [0, 0, 0, 1]]) {
                            linear_extrude(height=1, center=false) {
                                translate([-1.80562, -1.87258, 0]) {
                                    text("2", size=3.74515, font="Verdana:style=Bold");
                                }
                            }
                        }
                    }
                    translate([25.096, 25.285, 3]) {
                        multmatrix([[-0.709754, 0, 0.70445, 0], [0.70445, 0, 0.709754, 0], [0, 1, 0, 0], [0, 0, 0, 1]]) {
                            linear_extrude(height=1, center=false) {
                                translate([-0.917693, -1.87258, 0]) {
                                    text(".", size=3.74515, font="Verdana:style=Bold");
                                }
                            }
                        }
                    }
                    translate([23.1204, 27.1033, 3]) {
                        multmatrix([[-0.760793, 0, 0.648994, 0], [0.648994, 0, 0.760793, 0], [0, 1, 0, 0], [0, 0, 0, 1]]) {
                            linear_extrude(height=1, center=false) {
                                translate([-1.80562, -1.87258, 0]) {
                                    text("9", size=3.74515, font="Verdana:style=Bold");
                                }
                            }
                        }
                    }
                }
            }
            translate([0, 0, 1.92819]) {
                union() {
                    translate([-27.9921, 22.036, 3]) {
                        multmatrix([[-0.618553, 0, -0.785743, 0], [-0.785743, 0, 0.618553, 0], [0, 1, 0, 0], [0, 0, 0, 1]]) {
                            linear_extrude(height=1, center=false) {
                                translate([-3.32082, -3.53875, 0]) {
                                    text("Z", size=7.0775, font="Verdana:style=Bold");
                                }
                            }
                        }
                    }
                    translate([-31.4875, 16.6637, 3]) {
                        multmatrix([[-0.467753, 0, -0.883859, 0], [-0.883859, 0, 0.467753, 0], [0, 1, 0, 0], [0, 0, 0, 1]]) {
                            linear_extrude(height=1, center=false) {
                                translate([-3.18724, -3.53875, 0]) {
                                    text("e", size=7.0775, font="Verdana:style=Bold");
                                }
                            }
                        }
                    }
                    translate([-33.9929, 10.6595, 3]) {
                        multmatrix([[-0.299213, 0, -0.954186, 0], [-0.954186, 0, 0.299213, 0], [0, 1, 0, 0], [0, 0, 0, 1]]) {
                            linear_extrude(height=1, center=false) {
                                translate([-3.41925, -3.53875, 0]) {
                                    text("n", size=7.0775, font="Verdana:style=Bold");
                                }
                            }
                        }
                    }
                    translate([-35.3247, 4.61616, 3]) {
                        multmatrix([[-0.129576, 0, -0.991569, 0], [-0.991569, 0, 0.129576, 0], [0, 1, 0, 0], [0, 0, 0, 1]]) {
                            linear_extrude(height=1, center=false) {
                                translate([-2.86383, -3.53875, 0]) {
                                    text("z", size=7.0775, font="Verdana:style=Bold");
                                }
                            }
                        }
                    }
                    translate([-35.5992, -1.3563, 3]) {
                        multmatrix([[0.0380716, 0, -0.999275, 0], [-0.999275, 0, -0.0380716, 0], [0, 1, 0, 0], [0, 0, 0, 1]]) {
                            linear_extrude(height=1, center=false) {
                                translate([-3.20599, -3.53875, 0]) {
                                    text("a", size=7.0775, font="Verdana:style=Bold");
                                }
                            }
                        }
                    }
                    translate([-34.6097, -8.44458, 3]) {
                        multmatrix([[0.237041, 0, -0.9715, 0], [-0.9715, 0, -0.237041, 0], [0, 1, 0, 0], [0, 0, 0, 1]]) {
                            linear_extrude(height=1, center=false) {
                                translate([-4.06373, -3.53875, 0]) {
                                    text("N", size=7.0775, font="Verdana:style=Bold");
                                }
                            }
                        }
                    }
                    translate([-31.8463, -15.9672, 3]) {
                        multmatrix([[0.448203, 0, -0.893932, 0], [-0.893932, 0, -0.448203, 0], [0, 1, 0, 0], [0, 0, 0, 1]]) {
                            linear_extrude(height=1, center=false) {
                                translate([-4.08013, -3.53875, 0]) {
                                    text("O", size=7.0775, font="Verdana:style=Bold");
                                }
                            }
                        }
                    }
                    translate([-27.962, -22.0741, 3]) {
                        multmatrix([[0.619623, 0, -0.784899, 0], [-0.784899, 0, -0.619623, 0], [0, 1, 0, 0], [0, 0, 0, 1]]) {
                            linear_extrude(height=1, center=false) {
                                translate([-3.27161, -3.53875, 0]) {
                                    text("T", size=7.0775, font="Verdana:style=Bold");
                                }
                            }
                        }
                    }
                }
            }
            rotate_extrude() {
                polygon(points=[[34.135, 2.25], [34.135, 3.75], [33.75, 3]]);
            }
            translate([0, 0, 6]) {
                union() {
                    // Funnel
                    //  bot_od = 68.1  (input)
                    //  h      = 34  (input)
                    //  thk    = 2  (input)
                    //  top_od = 94.2028  (input)
                    difference() {
                        cylinder(h=34, r1=34.05, r2=47.1014, center=false);
                        translate([0, 0, -0.01]) {
                            scale([1, 1, 1.00059]) {
                                cylinder(h=34, r1=32.05, r2=45.1014, center=false);
                            }
                        }
                    }
                    multmatrix([[1, 0, 0, 0], [0, -1, 1.22465e-16, 0], [0, -1.22465e-16, -1, 0], [0, 0, 0, 1]]) {
                        linear_extrude(height=0.01, center=false) {
                            projection(cut=true) {
                                multmatrix([[1, 0, 0, 0], [0, -1, -1.22465e-16, 0], [0, 1.22465e-16, -1, 0], [0, 0, 0, 1]]) {
                                    // Funnel
                                    //  bot_od = 68.1  (input)
                                    //  h      = 34  (input)
                                    //  thk    = 2  (input)
                                    //  top_od = 94.2028  (input)
                                    difference() {
                                        cylinder(h=34, r1=34.05, r2=47.1014, center=false);
                                        translate([0, 0, -0.01]) {
                                            scale([1, 1, 1.00059]) {
                                                cylinder(h=34, r1=32.05, r2=45.1014, center=false);
                                            }
                                        }
                                    }
                                }
                            }
                        }
                    }
                }
            }
            translate([0, 0, 5.99]) {
                // FilletRing
                //  base_angle = 63  (input)
                //  id         = 68.25  (input)
                //  od         = 72.25  (input)
                //  slant      = 'inwards'  (input)
                difference() {
                    cylinder(h=3.92522, r=36.125, center=false);
                    translate([0, 0, -0.07225]) {
                        cylinder(h=4.06972, r1=34.125, r2=36.1972, center=false);
                    }
                }
            }
        }
    }

    // WaterhouseStop
    //  hole_d         = 23.78  (input)
    //  inner_diameter = 53  (input)
    //  outer_diameter = 68.1  (input)
    //  spacing        = 19.439  (input)
    //  thk            = 1.5  (input)
    //  slot_bottom    = spacing - thk / 2 = 18.689
    color("red") {
        translate([0, 0, 18.689]) {
            linear_extrude(height=1.5, center=false) {
                difference() {
                    union() {
                        // Sector
                        //  angles = [0, 180]  (input)
                        //  r      = 34.05  (input)
                        intersection() {
                            circle(r=34.05);
                            polygon(points=[[0, 0], [68.1, 0], [4.16992e-15, 68.1], [-68.1, 8.33984e-15]]);
                        }
                        // Sector
                        //  angles = [180, 360]  (input)
                        //  r      = 26.5  (input)
                        intersection() {
                            circle(r=26.5);
                            polygon(points=[[0, 0], [-53, 6.49063e-15], [-9.73594e-15, -53], [53, -1.29813e-14]]);
                        }
                    }
                    circle(r=11.89);
                }
            }
        }
    }

    color("orange") {
        // S2ApertureCover
        //  barrel_od         = 68.1  (input)
        //  cover_axial       = 10  (input)
        //  groove_offset_deg = 15  (input)
        //  ridge_base        = 1.8  (input)
        //  ridge_height      = 1.5  (input)
        //  z_center          = 19.439  (input)
        //  end_extension     = 4  (default)
        //  id_clearance      = 0.2  (default)
        //  tab_radial        = 5  (default)
        //  tab_thk           = 2.5  (default)
        //  wall_thk          = 2.5  (default)
        //  id                = barrel_od + 2 * id_clearance = 68.5
        //  od                = id + 2 * wall_thk = 73.5
        //  cover_z_bot       = z_center - cover_axial / 2 = 14.439
        union() {
            translate([0, 0, 14.439]) {
                linear_extrude(height=10, center=false) {
                    difference() {
                        // Sector
                        //  angles = [-21.2363, 201.236]  (input)
                        //  r      = 36.75  (input)
                        intersection() {
                            circle(r=36.75);
                            polygon(points=[[0, 0], [68.509, -26.6228], [44.3141, 58.6389], [-44.3141, 58.6389], [-68.509, -26.6228]]);
                        }
                        circle(r=34.25);
                    }
                }
            }
            rotate([0, 0, -15]) {
                translate([0, 0, 14.439]) {
                    linear_extrude(height=10, center=false) {
                        polygon(points=[[34.26, -0.9], [34.26, 0.9], [32.55, 0]]);
                    }
                }
            }
            rotate([0, 0, 195]) {
                translate([0, 0, 14.439]) {
                    linear_extrude(height=10, center=false) {
                        polygon(points=[[34.26, -0.9], [34.26, 0.9], [32.55, 0]]);
                    }
                }
            }
            rotate([0, 0, -21.2363]) {
                translate([0, 0, 14.439]) {
                    linear_extrude(height=10, center=false) {
                        polygon(points=[[36.74, 0], [41.75, 0], [41.75, 2.5], [36.74, 2.5]]);
                    }
                }
            }
            rotate([0, 0, 201.236]) {
                translate([0, 0, 14.439]) {
                    linear_extrude(height=10, center=false) {
                        polygon(points=[[36.74, -2.5], [41.75, -2.5], [41.75, 0], [36.74, 0]]);
                    }
                }
            }
        }
    }
}
