brianssparetime/bronica-lens-housing/releases/15a/v15a-print_shape_stops.scad

// Generated by scadwright. Do not hand-edit —
// edit the Python source and regenerate.

$fn = 48;

union() {
    translate([28, 26.5, 6.15]) {
        // SquareStop
        //  equiv_area_circle_dia = 14.46  (input)
        //  inner_diameter        = 53  (input)
        //  outer_diameter        = 56  (input)
        //  spacing               = -5.4  (input)
        //  thk                   = 1.5  (input)
        //  slot_bottom           = spacing - thk / 2 = -6.15
        //  target_area           = pi * equiv_area_circle_dia ** 2 / 4 = 164.22
        //  side                  = equiv_area_circle_dia * sqrt(pi) / 2 = 12.8148
        color("red") {
            translate([0, 0, -6.15]) {
                linear_extrude(height=1.5, center=false) {
                    difference() {
                        union() {
                            // Sector
                            //  angles = [0, 180]  (input)
                            //  r      = 28  (input)
                            intersection() {
                                circle(r=28);
                                polygon(points=[[0, 0], [56, 0], [3.42901e-15, 56], [-56, 6.85802e-15]]);
                            }
                            // Sector
                            //  angles = [180, 360]  (input)
                            //  r      = 26.5  (input)
                            intersection() {
                                circle(r=26.5);
                                polygon(points=[[0, 0], [-53, 6.49063e-15], [-9.73594e-15, -53], [53, -1.29813e-14]]);
                            }
                        }
                        square([12.8148, 12.8148], center=true);
                    }
                }
            }
        }
    }

    translate([94, 26.5, 6.15]) {
        // HexStop
        //  equiv_area_circle_dia = 14.46  (input)
        //  inner_diameter        = 53  (input)
        //  outer_diameter        = 56  (input)
        //  spacing               = -5.4  (input)
        //  thk                   = 1.5  (input)
        //  slot_bottom           = spacing - thk / 2 = -6.15
        //  target_area           = pi * equiv_area_circle_dia ** 2 / 4 = 164.22
        //  hex_r                 = equiv_area_circle_dia * sqrt(pi / (6 * sqrt(3))) = 7.95037
        color("red") {
            translate([0, 0, -6.15]) {
                linear_extrude(height=1.5, center=false) {
                    difference() {
                        union() {
                            // Sector
                            //  angles = [0, 180]  (input)
                            //  r      = 28  (input)
                            intersection() {
                                circle(r=28);
                                polygon(points=[[0, 0], [56, 0], [3.42901e-15, 56], [-56, 6.85802e-15]]);
                            }
                            // Sector
                            //  angles = [180, 360]  (input)
                            //  r      = 26.5  (input)
                            intersection() {
                                circle(r=26.5);
                                polygon(points=[[0, 0], [-53, 6.49063e-15], [-9.73594e-15, -53], [53, -1.29813e-14]]);
                            }
                        }
                        rotate([0, 0, 30]) {
                            polygon(points=[[7.95037, 0], [3.97518, 6.88522], [-3.97518, 6.88522], [-7.95037, 9.73639e-16], [-3.97518, -6.88522], [3.97518, -6.88522]]);
                        }
                    }
                }
            }
        }
    }

    translate([160, 26.5, 6.15]) {
        // AlmondStop
        //  equiv_area_circle_dia = 14.46  (input)
        //  inner_diameter        = 53  (input)
        //  outer_diameter        = 56  (input)
        //  spacing               = -5.4  (input)
        //  thk                   = 1.5  (input)
        //  aspect                = 2.5  (default)
        //  slot_bottom           = spacing - thk / 2 = -6.15
        //  target_area           = pi * equiv_area_circle_dia ** 2 / 4 = 164.22
        //  almond_seg_r          = (aspect ** 2 + 1) / 2 = 3.625
        //  almond_half           = asin(2 * aspect / (aspect ** 2 + 1)) = 43.6028
        //  almond_area_unit      = almond_seg_r ** 2 * (radians(2 * almond_half) - sin(2 * almond_half)) = 6.87537
        //  sag                   = sqrt(target_area / almond_area_unit) = 4.88726
        //  chord_r               = aspect * sag = 12.2181
        color("red") {
            translate([0, 0, -6.15]) {
                linear_extrude(height=1.5, center=false) {
                    difference() {
                        union() {
                            // Sector
                            //  angles = [0, 180]  (input)
                            //  r      = 28  (input)
                            intersection() {
                                circle(r=28);
                                polygon(points=[[0, 0], [56, 0], [3.42901e-15, 56], [-56, 6.85802e-15]]);
                            }
                            // Sector
                            //  angles = [180, 360]  (input)
                            //  r      = 26.5  (input)
                            intersection() {
                                circle(r=26.5);
                                polygon(points=[[0, 0], [-53, 6.49063e-15], [-9.73594e-15, -53], [53, -1.29813e-14]]);
                            }
                        }
                        rotate([0, 0, 90]) {
                            polygon(points=[[12.2181, 1.77636e-15], [9.57162, 2.07906], [6.57967, 3.62013], [3.35029, 4.56759], [0, 4.88726], [-3.35029, 4.56759], [-6.57967, 3.62013], [-9.57162, 2.07906], [-12.2181, -1.77636e-15], [-9.57162, -2.07906], [-6.57967, -3.62013], [-3.35029, -4.56759], [0, -4.88726], [3.35029, -4.56759], [6.57967, -3.62013], [9.57162, -2.07906]]);
                        }
                    }
                }
            }
        }
    }
}
