brianssparetime/bronica-lens-housing/releases/15a/v15a-print_vertical.scad

// Generated by scadwright. Do not hand-edit —
// edit the Python source and regenerate.

$fn = 128;

module S2LensHousing_e53bc72f() {
    // S2LensHousing
    //  alignment_groove_depth           = 0.3  (default)
    //  alignment_groove_width           = 0.5  (default)
    //  aperture_cover_axial             = 10  (default)
    //  aperture_cover_clearance         = 0.1  (default)
    //  aperture_cover_fillet_angle      = 45  (default)
    //  aperture_cover_fillet_clearance  = 0.3  (default)
    //  aperture_cover_groove_offset_deg = 15  (default)
    //  aperture_cover_ridge_base        = 1.8  (default)
    //  aperture_cover_ridge_height      = 1.5  (default)
    //  aperture_cover_wall_thk          = 2.5  (default)
    //  aperture_feeler_slot             = [0, 15, 0.5, -30, -20.3, 60, 0.01]  (default)
    //  bore_fillet_base_angle           = 45  (default)
    //  elements                         = (Element(code='L1198', type='ACH', dia=34.2, edge_thk=23.75, spacing=37.9, face_z_top=50.474999999999994, face_z_bot=25.325, constricted=False, throat_dia_required=34.5, clearances=ElementClearances(axial=0.2, radial=0.3)), Element(code='L14523', type='ACH', dia=44.4, edge_thk=12.6, spacing=11.899999999999999, face_z_top=18.9, face_z_bot=4.899999999999999, constricted=True, throat_dia_required=44.699999999999996, clearances=ElementClearances(axial=0.2, radial=0.3)), Element(code='L10587', type='ACH', dia=38.0, edge_thk=7.0, spacing=-13.1, face_z_top=-8.899999999999999, face_z_bot=-17.3, constricted=True, throat_dia_required=38.3, clearances=ElementClearances(axial=0.2, radial=0.3)))  (default)
    //  flange_flange_len                = 5  (default)
    //  flange_flange_od                 = 68.1  (default)
    //  fov_angle                        = 47  (default)
    //  grip_depth                       = 1.5  (default)
    //  grip_width                       = 1  (default)
    //  helicoid_focus_slot              = [180, 8, 0.8, -20.3, -11, 60, 0.01]  (default)
    //  hood_coupler_overlap             = 6  (default)
    //  hood_snap_axial                  = 1.5  (default)
    //  hood_snap_clearance              = 0.1  (default)
    //  hood_snap_engage                 = 0.3  (default)
    //  lower_inner_len                  = 9.7  (default)
    //  lower_inner_od                   = 49  (default)
    //  lower_inner_thk                  = 1.5  (default)
    //  lower_mid_len                    = 13  (default)
    //  lower_mid_od                     = 54.25  (default)
    //  lower_mid_thk                    = 1.75  (default)
    //  lower_outer_len                  = 7.3  (default)
    //  lower_outer_od                   = 56  (default)
    //  lower_outer_thk                  = 1.5  (default)
    //  mating_disc                      = [59.65, 1.2, 5]  (default)
    //  mating_disc_bead                 = [0.2, 1, 3.75, 0.05, 0.05]  (default)
    //  mating_disc_tabs                 = MatingDiscTabs(axial=3.8, radial=2.4, circumferential=6.0, z_top=5.0, angles_deg=(55.0, 185.0), clearance=0.15, disc_od=59.65, housing_tab_offset_deg=-60.0)  (default)
    //  mount_offset                     = 5  (default)
    //  stop                             = [-5.4, 1.5, 0.5]  (default)
    //  upper_barrel_thk                 = 5  (default)
    //  force_all_lower_segments         = false  (default)
    //  slot_hi                          = -4.4  (default)
    //  hood_base_angle                  = 90 - fov_angle / 2 = 66.5
    //  lower_outer_id                   = lower_outer_od - 2 * lower_outer_thk = 53
    //  lower_mid_id                     = lower_mid_od - 2 * lower_mid_thk = 50.75
    //  lower_inner_id                   = lower_inner_od - 2 * lower_inner_thk = 46
    //  lower_outer_z_top                = mount_offset = 5
    //  lower_outer_z_bot                = -lower_outer_len = -7.3
    //  lower_mid_z_top                  = lower_outer_z_bot = -7.3
    //  lower_mid_z_bot                  = lower_mid_z_top - lower_mid_len = -20.3
    //  lower_inner_z_top                = lower_mid_z_bot = -20.3
    //  lower_inner_z_bot                = lower_inner_z_top - lower_inner_len = -30
    //  housing_insertion_depth          = lower_outer_len + lower_mid_len + lower_inner_len = 30
    //  lower_housing_len                = housing_insertion_depth + mount_offset = 35
    //  unconstricted                    = tuple((e for e in elements if not e.constricted)) = (Element(code='L1198', type='ACH', dia=34.2, edge_thk=23.75, spacing=37.9, face_z_top=50.474999999999994, face_z_bot=25.325, constricted=False, throat_dia_required=34.5, clearances=ElementClearances(axial=0.2, radial=0.3)),)
    //  max_upper_ele_dia                = max((e.dia for e in unconstricted), default=0.0) = 34.2
    //  is_wide                          = max_upper_ele_dia > lower_outer_id = false
    //  expansion_funnel_len             = min((e.face_z_bot for e in unconstricted), default=inf) = 25.325
    //  upper_housing_len                = max((e.face_z_top for e in elements)) = 50.475
    //  upper_housing_od                 = max_upper_ele_dia + 2 * upper_barrel_thk if is_wide else flange_flange_od = 68.1
    //  slot_lo                          = stop.spacing - (stop.thk + stop.clr) / 2 = -6.4
    //  upper_floor                      = expansion_funnel_len if is_wide else mount_offset + flange_flange_len = 10
    union() {
        difference() {
            union() {
                difference() {
                    union() {
                        // HousingSection
                        //  bot_id        = 53  (input)
                        //  thk           = 1.5  (input)
                        //  top_id        = 53  (input)
                        //  top_overshoot = 0.01  (input)
                        //  z_bot         = -7.3  (input)
                        //  z_top         = 5  (input)
                        translate([0, 0, -7.3]) {
                            // Tube
                            //  h  = 12.31  (input)
                            //  id = 53  (input)
                            //  od = 56  (input)
                            difference() {
                                cylinder(h=12.31, r=28, center=false);
                                translate([0, 0, -0.01]) {
                                    scale([1, 1, 1.00162]) {
                                        cylinder(h=12.31, r=26.5, center=false);
                                    }
                                }
                            }
                        }
                        // HousingSection
                        //  bot_id        = 50.75  (input)
                        //  thk           = 1.75  (input)
                        //  top_id        = 50.75  (input)
                        //  top_overshoot = 0.01  (input)
                        //  z_bot         = -20.3  (input)
                        //  z_top         = -7.3  (input)
                        translate([0, 0, -20.3]) {
                            // Tube
                            //  h  = 13.01  (input)
                            //  id = 50.75  (input)
                            //  od = 54.25  (input)
                            difference() {
                                cylinder(h=13.01, r=27.125, center=false);
                                translate([0, 0, -0.01]) {
                                    scale([1, 1, 1.00154]) {
                                        cylinder(h=13.01, r=25.375, center=false);
                                    }
                                }
                            }
                        }
                        // FilletSection
                        //  base_angle = 45  (input)
                        //  bot_id     = 50.75  (input)
                        //  top_id     = 53  (input)
                        //  z_bot      = -7.3  (input)
                        //  h_full     = tan(base_angle) * (top_id - bot_id) / 2 = 1.125
                        //  z_top      = z_bot + h_full = -6.175
                        translate([0, 0, -7.3]) {
                            // FilletRing
                            //  base_angle = 45  (input)
                            //  id         = 50.75  (input)
                            //  od         = 53  (input)
                            //  slant      = 'inwards'  (input)
                            difference() {
                                cylinder(h=1.125, r=26.5, center=false);
                                translate([0, 0, -0.053]) {
                                    cylinder(h=1.231, r1=25.375, r2=26.553, center=false);
                                }
                            }
                        }
                        // HousingSection
                        //  bot_id        = 53  (input)
                        //  thk           = 7.55  (input)
                        //  top_id        = 53  (input)
                        //  top_overshoot = 0.01  (input)
                        //  z_bot         = 5  (input)
                        //  z_top         = 10  (input)
                        translate([0, 0, 5]) {
                            // Tube
                            //  h  = 5.01  (input)
                            //  id = 53  (input)
                            //  od = 68.1  (input)
                            difference() {
                                cylinder(h=5.01, r=34.05, center=false);
                                translate([0, 0, -0.01]) {
                                    scale([1, 1, 1.00399]) {
                                        cylinder(h=5.01, r=26.5, center=false);
                                    }
                                }
                            }
                        }
                        // HousingSection
                        //  bot_id = 53  (input)
                        //  thk    = 7.55  (input)
                        //  top_id = 53  (input)
                        //  z_bot  = 10  (input)
                        //  z_top  = 50.475  (input)
                        translate([0, 0, 10]) {
                            // Tube
                            //  h  = 40.475  (input)
                            //  id = 53  (input)
                            //  od = 68.1  (input)
                            difference() {
                                cylinder(h=40.475, r=34.05, center=false);
                                translate([0, 0, -0.01]) {
                                    scale([1, 1, 1.00049]) {
                                        cylinder(h=40.475, r=26.5, center=false);
                                    }
                                }
                            }
                        }
                        // HousingSection
                        //  bot_id = 56  (input)
                        //  thk    = 1.825  (input)
                        //  top_id = 56  (input)
                        //  z_bot  = 1.2  (input)
                        //  z_top  = 5  (input)
                        translate([0, 0, 1.2]) {
                            // Tube
                            //  h  = 3.8  (input)
                            //  id = 56  (input)
                            //  od = 59.65  (input)
                            difference() {
                                cylinder(h=3.8, r=29.825, center=false);
                                translate([0, 0, -0.01]) {
                                    scale([1, 1, 1.00526]) {
                                        cylinder(h=3.8, r=28, center=false);
                                    }
                                }
                            }
                        }
                    }
                    translate([0, 0, -6.4]) {
                        intersection() {
                            // Tube
                            //  h  = 2  (input)
                            //  id = 52.9  (input)
                            //  od = 57  (input)
                            difference() {
                                cylinder(h=2, r=28.5, center=false);
                                translate([0, 0, -0.01]) {
                                    scale([1, 1, 1.01]) {
                                        cylinder(h=2, r=26.45, center=false);
                                    }
                                }
                            }
                            translate([0, 29.07, 0]) {
                                cube([58.14, 58.14, 58.14], center=true);
                            }
                        }
                    }
                    translate([0, 0, -20.31]) {
                        intersection() {
                            // Tube
                            //  h  = 9.31  (input)
                            //  id = 52.65  (input)
                            //  od = 54.27  (input)
                            difference() {
                                cylinder(h=9.31, r=27.135, center=false);
                                translate([0, 0, -0.01]) {
                                    scale([1, 1, 1.00215]) {
                                        cylinder(h=9.31, r=26.325, center=false);
                                    }
                                }
                            }
                            linear_extrude(height=9.31, center=false) {
                                // Sector
                                //  angles = [111.551, 188.449]  (input)
                                //  r      = 27.135  (input)
                                intersection() {
                                    circle(r=27.135);
                                    polygon(points=[[0, 0], [-19.9348, 50.4761], [-53.681, -7.97398]]);
                                }
                            }
                        }
                    }
                    translate([0, 34.06, 5]) {
                        rotate([90, 0, 0]) {
                            linear_extrude(height=4.245, center=false) {
                                polygon(points=[[-0.25, -0.01], [0.25, -0.01], [0, 0.3]]);
                            }
                        }
                    }
                }
                rotate([0, 0, -5]) {
                    translate([0, 0, 1.2]) {
                        linear_extrude(height=3.8, center=false) {
                            polygon(points=[[29.815, -3], [32.225, -3], [32.225, 3], [29.815, 3]]);
                        }
                    }
                }
                rotate([0, 0, 125]) {
                    translate([0, 0, 1.2]) {
                        linear_extrude(height=3.8, center=false) {
                            polygon(points=[[29.815, -3], [32.225, -3], [32.225, 3], [29.815, 3]]);
                        }
                    }
                }
                rotate_extrude() {
                    polygon(points=[[29.815, 3.25], [30.025, 3.75], [29.815, 4.25]]);
                }
            }
            rotate_extrude() {
                polygon(points=[[34.06, 61.625], [34.06, 63.325], [33.65, 62.475]]);
            }
        }
        // ElementHolder
        //  element    = Element(code='L1198', type='ACH', dia=34.2, edge_thk=23.75, spacing=37.9, face_z_top=50.474999999999994, face_z_bot=25.325, constricted=False, throat_dia_required=34.5, clearances=ElementClearances(axial=0.2, radial=0.3))  (input)
        //  grip_depth = 1.5  (input)
        //  grip_width = 1  (input)
        //  od         = 53.02  (input)
        union() {
            translate([0, 0, 25.325]) {
                // Tube
                //  h  = 25.15  (input)
                //  id = 34.5  (input)
                //  od = 53.02  (input)
                difference() {
                    cylinder(h=25.15, r=26.51, center=false);
                    translate([0, 0, -0.01]) {
                        scale([1, 1, 1.0008]) {
                            cylinder(h=25.15, r=17.25, center=false);
                        }
                    }
                }
            }
            translate([0, 0, 25.325]) {
                // Tube
                //  h  = 0.5  (input)
                //  id = 32.7  (input)
                //  od = 53.02  (input)
                difference() {
                    cylinder(h=0.5, r=26.51, center=false);
                    translate([0, 0, -0.01]) {
                        scale([1, 1, 1.04]) {
                            cylinder(h=0.5, r=16.35, center=false);
                        }
                    }
                }
            }
            translate([0, 0, 49.975]) {
                // Tube
                //  h  = 0.5  (input)
                //  id = 32.7  (input)
                //  od = 53.02  (input)
                difference() {
                    cylinder(h=0.5, r=26.51, center=false);
                    translate([0, 0, -0.01]) {
                        scale([1, 1, 1.04]) {
                            cylinder(h=0.5, r=16.35, center=false);
                        }
                    }
                }
            }
        }
        // ElementHolder
        //  element    = Element(code='L14523', type='ACH', dia=44.4, edge_thk=12.6, spacing=11.899999999999999, face_z_top=18.9, face_z_bot=4.899999999999999, constricted=True, throat_dia_required=44.699999999999996, clearances=ElementClearances(axial=0.2, radial=0.3))  (input)
        //  grip_depth = 1.5  (input)
        //  grip_width = 1  (input)
        //  od         = 53.02  (input)
        union() {
            translate([0, 0, 4.9]) {
                // Tube
                //  h  = 14  (input)
                //  id = 44.7  (input)
                //  od = 53.02  (input)
                difference() {
                    cylinder(h=14, r=26.51, center=false);
                    translate([0, 0, -0.01]) {
                        scale([1, 1, 1.00143]) {
                            cylinder(h=14, r=22.35, center=false);
                        }
                    }
                }
            }
            translate([0, 0, 4.9]) {
                // Tube
                //  h  = 0.5  (input)
                //  id = 42.9  (input)
                //  od = 53.02  (input)
                difference() {
                    cylinder(h=0.5, r=26.51, center=false);
                    translate([0, 0, -0.01]) {
                        scale([1, 1, 1.04]) {
                            cylinder(h=0.5, r=21.45, center=false);
                        }
                    }
                }
            }
            translate([0, 0, 18.4]) {
                // Tube
                //  h  = 0.5  (input)
                //  id = 42.9  (input)
                //  od = 53.02  (input)
                difference() {
                    cylinder(h=0.5, r=26.51, center=false);
                    translate([0, 0, -0.01]) {
                        scale([1, 1, 1.04]) {
                            cylinder(h=0.5, r=21.45, center=false);
                        }
                    }
                }
            }
        }
        // ElementHolder
        //  element    = Element(code='L10587', type='ACH', dia=38.0, edge_thk=7.0, spacing=-13.1, face_z_top=-8.899999999999999, face_z_bot=-17.3, constricted=True, throat_dia_required=38.3, clearances=ElementClearances(axial=0.2, radial=0.3))  (input)
        //  grip_depth = 1.5  (input)
        //  grip_width = 1  (input)
        //  od         = 50.77  (input)
        union() {
            translate([0, 0, -17.3]) {
                // Tube
                //  h  = 8.4  (input)
                //  id = 38.3  (input)
                //  od = 50.77  (input)
                difference() {
                    cylinder(h=8.4, r=25.385, center=false);
                    translate([0, 0, -0.01]) {
                        scale([1, 1, 1.00238]) {
                            cylinder(h=8.4, r=19.15, center=false);
                        }
                    }
                }
            }
            translate([0, 0, -17.3]) {
                // Tube
                //  h  = 0.5  (input)
                //  id = 36.5  (input)
                //  od = 50.77  (input)
                difference() {
                    cylinder(h=0.5, r=25.385, center=false);
                    translate([0, 0, -0.01]) {
                        scale([1, 1, 1.04]) {
                            cylinder(h=0.5, r=18.25, center=false);
                        }
                    }
                }
            }
            translate([0, 0, -9.4]) {
                // Tube
                //  h  = 0.5  (input)
                //  id = 36.5  (input)
                //  od = 50.77  (input)
                difference() {
                    cylinder(h=0.5, r=25.385, center=false);
                    translate([0, 0, -0.01]) {
                        scale([1, 1, 1.04]) {
                            cylinder(h=0.5, r=18.25, center=false);
                        }
                    }
                }
            }
        }
        // StopHolder
        //  barrel_id  = 53  (input)
        //  grip_depth = 1.5  (input)
        //  grip_width = 1  (input)
        //  od_bot     = 56  (input)
        //  od_top     = 56  (input)
        //  stop       = [-5.4, 1.5, 0.5]  (input)
        color("green") {
            translate([0, 0, -5.4]) {
                union() {
                    translate([0, 0, 1]) {
                        // Tube
                        //  h  = 0.5  (input)
                        //  id = 51.5  (input)
                        //  od = 56  (input)
                        difference() {
                            cylinder(h=0.5, r=28, center=false);
                            translate([0, 0, -0.01]) {
                                scale([1, 1, 1.04]) {
                                    cylinder(h=0.5, r=25.75, center=false);
                                }
                            }
                        }
                    }
                    translate([0, 0, -1.5]) {
                        // Tube
                        //  h  = 0.5  (input)
                        //  id = 51.5  (input)
                        //  od = 56  (input)
                        difference() {
                            cylinder(h=0.5, r=28, center=false);
                            translate([0, 0, -0.01]) {
                                scale([1, 1, 1.04]) {
                                    cylinder(h=0.5, r=25.75, center=false);
                                }
                            }
                        }
                    }
                }
            }
        }
        difference() {
            translate([0, 0, 50.465]) {
                // TruncFilletRing
                //  base_angle = 66.5  (input)
                //  id         = 37.7  (input)
                //  od         = 68.1  (input)
                //  rim_width  = 8.67781  (input)
                //  slant      = 'inwards'  (input)
                //  h_full     = tan(base_angle) * (od - id) / 2 = 34.9576
                //  z_t        = tan(base_angle) * ((od - id) / 2 - rim_width) = 15
                difference() {
                    // FilletRing
                    //  base_angle = 66.5  (input)
                    //  id         = 37.7  (input)
                    //  od         = 68.1  (input)
                    //  slant      = 'inwards'  (input)
                    difference() {
                        cylinder(h=34.9576, r=34.05, center=false);
                        translate([0, 0, -0.0681]) {
                            cylinder(h=35.0938, r1=18.85, r2=34.1181, center=false);
                        }
                    }
                    translate([0, 0, -0.00751593]) {
                        scale([1, 1, 1.0005]) {
                            translate([0, 0, 15]) {
                                cylinder(h=19.9576, r=34.06, center=false);
                            }
                        }
                    }
                }
            }
            rotate_extrude() {
                polygon(points=[[34.06, 61.625], [34.06, 63.325], [33.65, 62.475]]);
            }
        }
    }
}

module lap_split_x_5f912fee(clearance, key_sides, mid_radius, overlap, side, z_min) {
    difference() {
        union() {
            intersection() {
                children();
                translate([-100, 0, 0]) {
                    cube([200, 200, 200], center=true);
                }
            }
            difference() {
                intersection() {
                    children();
                    translate([-0.01, 0, 5]) {
                        translate([0, -100, 0]) {
                            cube([2.61, 200, 200], center=false);
                        }
                    }
                }
                translate([0, 0, -100]) {
                    linear_extrude(height=200, center=false) {
                        polygon(points=[[29.9, 0], [21.1425, 21.1425], [1.83085e-15, 29.9], [-21.1425, 21.1425], [-29.9, 3.66169e-15], [-21.1425, -21.1425], [-5.49254e-15, -29.9], [21.1425, -21.1425]]);
                    }
                }
            }
        }
        intersection() {
            children();
            translate([-3, 0, 5]) {
                translate([0, -100, 0]) {
                    cube([3.01, 200, 200], center=false);
                }
            }
            translate([0, 0, -100]) {
                linear_extrude(height=200, center=false) {
                    polygon(points=[[29.5, 0], [20.8597, 20.8597], [1.80635e-15, 29.5], [-20.8597, 20.8597], [-29.5, 3.61271e-15], [-20.8597, -20.8597], [-5.41906e-15, -29.5], [20.8597, -20.8597]]);
                }
            }
        }
    }
}

module lap_split_x_4b63ed99(clearance, key_sides, mid_radius, overlap, side, z_min) {
    difference() {
        union() {
            intersection() {
                children();
                translate([100, 0, 0]) {
                    cube([200, 200, 200], center=true);
                }
            }
            intersection() {
                children();
                translate([-2.6, 0, 5]) {
                    translate([0, -100, 0]) {
                        cube([2.61, 200, 200], center=false);
                    }
                }
                translate([0, 0, -100]) {
                    linear_extrude(height=200, center=false) {
                        polygon(points=[[29.1, 0], [20.5768, 20.5768], [1.78186e-15, 29.1], [-20.5768, 20.5768], [-29.1, 3.56372e-15], [-20.5768, -20.5768], [-5.34558e-15, -29.1], [20.5768, -20.5768]]);
                    }
                }
            }
        }
        difference() {
            intersection() {
                children();
                translate([-0.01, 0, 5]) {
                    translate([0, -100, 0]) {
                        cube([3.01, 200, 200], center=false);
                    }
                }
            }
            translate([0, 0, -100]) {
                linear_extrude(height=200, center=false) {
                    polygon(points=[[29.5, 0], [20.8597, 20.8597], [1.80635e-15, 29.5], [-20.8597, 20.8597], [-29.5, 3.61271e-15], [-20.8597, -20.8597], [-5.41906e-15, -29.5], [20.8597, -20.8597]]);
                }
            }
        }
    }
}

translate([40.05, 34.05, 65.475]) {
    union() {
        translate([-6, 0, 0]) {
            rotate([180, 0, 0]) {
                difference() {
                    render() {
                        lap_split_x_5f912fee(clearance=0.4, key_sides=8, mid_radius=29.5, overlap=3, side="minus", z_min=5) {
                            S2LensHousing_e53bc72f();
                        }
                    }
                    union() {
                        translate([0, 0, 0.721231]) {
                            union() {
                                translate([32.7831, -6.59567, 41.4375]) {
                                    multmatrix([[0.197239, 0, 0.980355, 0], [0.980355, 0, -0.197239, 0], [0, 1, 0, 0], [0, 0, 0, 1]]) {
                                        linear_extrude(height=1.11, center=false) {
                                            translate([-1.76293, -2, 0]) {
                                                text("v", size=4, font="Verdana:style=Bold");
                                            }
                                        }
                                    }
                                }
                                translate([33.3043, -3.00984, 41.4375]) {
                                    multmatrix([[0.0900071, 0, 0.995941, 0], [0.995941, 0, -0.0900071, 0], [0, 1, 0, 0], [0, 0, 0, 1]]) {
                                        linear_extrude(height=1.11, center=false) {
                                            translate([-1.92849, -2, 0]) {
                                                text("1", size=4, font="Verdana:style=Bold");
                                            }
                                        }
                                    }
                                }
                                translate([33.431, 0.773897, 41.4375]) {
                                    multmatrix([[-0.0231429, 0, 0.999732, 0], [0.999732, 0, 0.0231429, 0], [0, 1, 0, 0], [0, 0, 0, 1]]) {
                                        linear_extrude(height=1.11, center=false) {
                                            translate([-1.92849, -2, 0]) {
                                                text("5", size=4, font="Verdana:style=Bold");
                                            }
                                        }
                                    }
                                }
                                translate([33.1447, 4.43428, 41.4375]) {
                                    multmatrix([[-0.132604, 0, 0.991169, 0], [0.991169, 0, 0.132604, 0], [0, 1, 0, 0], [0, 0, 0, 1]]) {
                                        linear_extrude(height=1.11, center=false) {
                                            translate([-1.81193, -2, 0]) {
                                                text("a", size=4, font="Verdana:style=Bold");
                                            }
                                        }
                                    }
                                }
                                translate([32.6466, 7.24088, 41.4375]) {
                                    multmatrix([[-0.216534, 0, 0.976275, 0], [0.976275, 0, 0.216534, 0], [0, 1, 0, 0], [0, 0, 0, 1]]) {
                                        linear_extrude(height=1.11, center=false) {
                                            translate([-1.0914, -2, 0]) {
                                                text(":", size=4, font="Verdana:style=Bold");
                                            }
                                        }
                                    }
                                }
                                translate([32.5855, -7.51113, 35.8375]) {
                                    multmatrix([[0.224615, 0, 0.974448, 0], [0.974448, 0, -0.224615, 0], [0, 1, 0, 0], [0, 0, 0, 1]]) {
                                        linear_extrude(height=1.11, center=false) {
                                            translate([-1.72849, -2, 0]) {
                                                text("L", size=4, font="Verdana:style=Bold");
                                            }
                                        }
                                    }
                                }
                                translate([33.2029, -3.97488, 35.8375]) {
                                    multmatrix([[0.118866, 0, 0.99291, 0], [0.99291, 0, -0.118866, 0], [0, 1, 0, 0], [0, 0, 0, 1]]) {
                                        linear_extrude(height=1.11, center=false) {
                                            translate([-1.92849, -2, 0]) {
                                                text("1", size=4, font="Verdana:style=Bold");
                                            }
                                        }
                                    }
                                }
                                translate([33.4394, -0.196417, 35.8375]) {
                                    multmatrix([[0.00587372, 0, 0.999983, 0], [0.999983, 0, -0.00587372, 0], [0, 1, 0, 0], [0, 0, 0, 1]]) {
                                        linear_extrude(height=1.11, center=false) {
                                            translate([-1.92849, -2, 0]) {
                                                text("1", size=4, font="Verdana:style=Bold");
                                            }
                                        }
                                    }
                                }
                                translate([33.2473, 3.58456, 35.8375]) {
                                    multmatrix([[-0.107194, 0, 0.994238, 0], [0.994238, 0, 0.107194, 0], [0, 1, 0, 0], [0, 0, 0, 1]]) {
                                        linear_extrude(height=1.11, center=false) {
                                            translate([-1.92849, -2, 0]) {
                                                text("9", size=4, font="Verdana:style=Bold");
                                            }
                                        }
                                    }
                                }
                                translate([32.6291, 7.3196, 35.8375]) {
                                    multmatrix([[-0.218887, 0, 0.97575, 0], [0.97575, 0, 0.218887, 0], [0, 1, 0, 0], [0, 0, 0, 1]]) {
                                        linear_extrude(height=1.11, center=false) {
                                            translate([-1.92849, -2, 0]) {
                                                text("8", size=4, font="Verdana:style=Bold");
                                            }
                                        }
                                    }
                                }
                                translate([32.1081, -9.34364, 30.2375]) {
                                    multmatrix([[0.279415, 0, 0.96017, 0], [0.96017, 0, -0.279415, 0], [0, 1, 0, 0], [0, 0, 0, 1]]) {
                                        linear_extrude(height=1.11, center=false) {
                                            translate([-1.72849, -2, 0]) {
                                                text("L", size=4, font="Verdana:style=Bold");
                                            }
                                        }
                                    }
                                }
                                translate([32.9247, -5.84801, 30.2375]) {
                                    multmatrix([[0.174881, 0, 0.98459, 0], [0.98459, 0, -0.174881, 0], [0, 1, 0, 0], [0, 0, 0, 1]]) {
                                        linear_extrude(height=1.11, center=false) {
                                            translate([-1.92849, -2, 0]) {
                                                text("1", size=4, font="Verdana:style=Bold");
                                            }
                                        }
                                    }
                                }
                                translate([33.3747, -2.089, 30.2375]) {
                                    multmatrix([[0.06247, 0, 0.998047, 0], [0.998047, 0, -0.06247, 0], [0, 1, 0, 0], [0, 0, 0, 1]]) {
                                        linear_extrude(height=1.11, center=false) {
                                            translate([-1.92849, -2, 0]) {
                                                text("4", size=4, font="Verdana:style=Bold");
                                            }
                                        }
                                    }
                                }
                                translate([33.3969, 1.69679, 30.2375]) {
                                    multmatrix([[-0.0507414, 0, 0.998712, 0], [0.998712, 0, 0.0507414, 0], [0, 1, 0, 0], [0, 0, 0, 1]]) {
                                        linear_extrude(height=1.11, center=false) {
                                            translate([-1.92849, -2, 0]) {
                                                text("5", size=4, font="Verdana:style=Bold");
                                            }
                                        }
                                    }
                                }
                                translate([32.9911, 5.46084, 30.2375]) {
                                    multmatrix([[-0.163303, 0, 0.986576, 0], [0.986576, 0, 0.163303, 0], [0, 1, 0, 0], [0, 0, 0, 1]]) {
                                        linear_extrude(height=1.11, center=false) {
                                            translate([-1.92849, -2, 0]) {
                                                text("2", size=4, font="Verdana:style=Bold");
                                            }
                                        }
                                    }
                                }
                                translate([32.1624, 9.15489, 30.2375]) {
                                    multmatrix([[-0.273771, 0, 0.961795, 0], [0.961795, 0, 0.273771, 0], [0, 1, 0, 0], [0, 0, 0, 1]]) {
                                        linear_extrude(height=1.11, center=false) {
                                            translate([-1.92849, -2, 0]) {
                                                text("3", size=4, font="Verdana:style=Bold");
                                            }
                                        }
                                    }
                                }
                                translate([32.1081, -9.34364, 24.6375]) {
                                    multmatrix([[0.279415, 0, 0.96017, 0], [0.96017, 0, -0.279415, 0], [0, 1, 0, 0], [0, 0, 0, 1]]) {
                                        linear_extrude(height=1.11, center=false) {
                                            translate([-1.72849, -2, 0]) {
                                                text("L", size=4, font="Verdana:style=Bold");
                                            }
                                        }
                                    }
                                }
                                translate([32.9247, -5.84801, 24.6375]) {
                                    multmatrix([[0.174881, 0, 0.98459, 0], [0.98459, 0, -0.174881, 0], [0, 1, 0, 0], [0, 0, 0, 1]]) {
                                        linear_extrude(height=1.11, center=false) {
                                            translate([-1.92849, -2, 0]) {
                                                text("1", size=4, font="Verdana:style=Bold");
                                            }
                                        }
                                    }
                                }
                                translate([33.3747, -2.089, 24.6375]) {
                                    multmatrix([[0.06247, 0, 0.998047, 0], [0.998047, 0, -0.06247, 0], [0, 1, 0, 0], [0, 0, 0, 1]]) {
                                        linear_extrude(height=1.11, center=false) {
                                            translate([-1.92849, -2, 0]) {
                                                text("0", size=4, font="Verdana:style=Bold");
                                            }
                                        }
                                    }
                                }
                                translate([33.3969, 1.69679, 24.6375]) {
                                    multmatrix([[-0.0507414, 0, 0.998712, 0], [0.998712, 0, 0.0507414, 0], [0, 1, 0, 0], [0, 0, 0, 1]]) {
                                        linear_extrude(height=1.11, center=false) {
                                            translate([-1.92849, -2, 0]) {
                                                text("5", size=4, font="Verdana:style=Bold");
                                            }
                                        }
                                    }
                                }
                                translate([32.9911, 5.46084, 24.6375]) {
                                    multmatrix([[-0.163303, 0, 0.986576, 0], [0.986576, 0, 0.163303, 0], [0, 1, 0, 0], [0, 0, 0, 1]]) {
                                        linear_extrude(height=1.11, center=false) {
                                            translate([-1.92849, -2, 0]) {
                                                text("8", size=4, font="Verdana:style=Bold");
                                            }
                                        }
                                    }
                                }
                                translate([32.1624, 9.15489, 24.6375]) {
                                    multmatrix([[-0.273771, 0, 0.961795, 0], [0.961795, 0, 0.273771, 0], [0, 1, 0, 0], [0, 0, 0, 1]]) {
                                        linear_extrude(height=1.11, center=false) {
                                            translate([-1.92849, -2, 0]) {
                                                text("7", size=4, font="Verdana:style=Bold");
                                            }
                                        }
                                    }
                                }
                                translate([31.635, -10.8378, 19.0375]) {
                                    multmatrix([[0.324098, 0, 0.946023, 0], [0.946023, 0, -0.324098, 0], [0, 1, 0, 0], [0, 0, 0, 1]]) {
                                        linear_extrude(height=1.11, center=false) {
                                            translate([-1.8967, -2, 0]) {
                                                text("d", size=4, font="Verdana:style=Bold");
                                            }
                                        }
                                    }
                                }
                                translate([32.6506, -7.2231, 19.0375]) {
                                    multmatrix([[0.216002, 0, 0.976393, 0], [0.976393, 0, -0.216002, 0], [0, 1, 0, 0], [0, 0, 0, 1]]) {
                                        linear_extrude(height=1.11, center=false) {
                                            translate([-1.92849, -2, 0]) {
                                                text("8", size=4, font="Verdana:style=Bold");
                                            }
                                        }
                                    }
                                }
                                translate([33.2578, -3.48626, 19.0375]) {
                                    multmatrix([[0.104254, 0, 0.994551, 0], [0.994551, 0, -0.104254, 0], [0, 1, 0, 0], [0, 0, 0, 1]]) {
                                        linear_extrude(height=1.11, center=false) {
                                            translate([-1.92849, -2, 0]) {
                                                text("2", size=4, font="Verdana:style=Bold");
                                            }
                                        }
                                    }
                                }
                                translate([33.4387, 0.295274, 19.0375]) {
                                    multmatrix([[-0.00882996, 0, 0.999961, 0], [0.999961, 0, 0.00882996, 0], [0, 1, 0, 0], [0, 0, 0, 1]]) {
                                        linear_extrude(height=1.11, center=false) {
                                            translate([-1.92849, -2, 0]) {
                                                text("4", size=4, font="Verdana:style=Bold");
                                            }
                                        }
                                    }
                                }
                                translate([33.2292, 3.74877, 19.0375]) {
                                    multmatrix([[-0.112104, 0, 0.993696, 0], [0.993696, 0, 0.112104, 0], [0, 1, 0, 0], [0, 0, 0, 1]]) {
                                        linear_extrude(height=1.11, center=false) {
                                            translate([-1.59604, -2, 0]) {
                                                text("c", size=4, font="Verdana:style=Bold");
                                            }
                                        }
                                    }
                                }
                                translate([32.664, 7.16213, 19.0375]) {
                                    multmatrix([[-0.214178, 0, 0.976795, 0], [0.976795, 0, 0.214178, 0], [0, 1, 0, 0], [0, 0, 0, 1]]) {
                                        linear_extrude(height=1.11, center=false) {
                                            translate([-1.92849, -2, 0]) {
                                                text("4", size=4, font="Verdana:style=Bold");
                                            }
                                        }
                                    }
                                }
                                translate([31.6451, 10.8083, 19.0375]) {
                                    multmatrix([[-0.323215, 0, 0.946326, 0], [0.946326, 0, 0.323215, 0], [0, 1, 0, 0], [0, 0, 0, 1]]) {
                                        linear_extrude(height=1.11, center=false) {
                                            translate([-1.92849, -2, 0]) {
                                                text("3", size=4, font="Verdana:style=Bold");
                                            }
                                        }
                                    }
                                }
                            }
                        }
                        translate([5.21673, 22.1141, 57.975]) {
                            multmatrix([[0.973285, 0.0915521, -0.210555, 0], [-0.229598, 0.388097, -0.892561, 0], [0, 0.91706, 0.398749, 0], [0, 0, 0, 1]]) {
                                linear_extrude(height=1.11, center=false) {
                                    translate([-1.95526, -1.89258, 0]) {
                                        text("B", size=3.78516, font="Verdana:style=Bold");
                                    }
                                }
                            }
                        }
                        translate([9.07567, 20.8298, 57.975]) {
                            multmatrix([[0.91676, 0.159275, -0.366309, 0], [-0.399438, 0.365557, -0.840724, 0], [0, 0.91706, 0.398749, 0], [0, 0, 0, 1]]) {
                                linear_extrude(height=1.11, center=false) {
                                    translate([-2.0079, -1.89258, 0]) {
                                        text("R", size=3.78516, font="Verdana:style=Bold");
                                    }
                                }
                            }
                        }
                        translate([12.1669, 19.1889, 57.975]) {
                            multmatrix([[0.844542, 0.213526, -0.491076, 0], [-0.53549, 0.33676, -0.774496, 0], [0, 0.91706, 0.398749, 0], [0, 0, 0, 1]]) {
                                linear_extrude(height=1.11, center=false) {
                                    translate([-1.40127, -1.89258, 0]) {
                                        text("I", size=3.78516, font="Verdana:style=Bold");
                                    }
                                }
                            }
                        }
                        translate([15.1037, 16.9743, 57.975]) {
                            multmatrix([[0.747072, 0.265066, -0.60961, 0], [-0.664743, 0.297894, -0.68511, 0], [0, 0.91706, 0.398749, 0], [0, 0, 0, 1]]) {
                                linear_extrude(height=1.11, center=false) {
                                    translate([-2.18212, -1.89258, 0]) {
                                        text("O", size=3.78516, font="Verdana:style=Bold");
                                    }
                                }
                            }
                        }
                        translate([17.868, 14.035, 57.975]) {
                            multmatrix([[0.617708, 0.313579, -0.721183, 0], [-0.786408, 0.24631, -0.566475, 0], [0, 0.91706, 0.398749, 0], [0, 0, 0, 1]]) {
                                linear_extrude(height=1.11, center=false) {
                                    translate([-1.74971, -1.89258, 0]) {
                                        text("T", size=3.78516, font="Verdana:style=Bold");
                                    }
                                }
                            }
                        }
                        translate([19.977, 10.8245, 57.975]) {
                            multmatrix([[0.476406, 0.35059, -0.806303, 0], [-0.879225, 0.189966, -0.436893, 0], [0, 0.91706, 0.398749, 0], [0, 0, 0, 1]]) {
                                linear_extrude(height=1.11, center=false) {
                                    translate([-1.99286, -1.89258, 0]) {
                                        text("A", size=3.78516, font="Verdana:style=Bold");
                                    }
                                }
                            }
                        }
                        translate([21.5987, 7.05283, 57.975]) {
                            multmatrix([[0.310409, 0.379052, -0.87176, 0], [-0.950603, 0.123775, -0.284664, 0], [0, 0.91706, 0.398749, 0], [0, 0, 0, 1]]) {
                                linear_extrude(height=1.11, center=false) {
                                    translate([-2.0079, -1.89258, 0]) {
                                        text("R", size=3.78516, font="Verdana:style=Bold");
                                    }
                                }
                            }
                        }
                        translate([22.3328, 4.18246, 57.975]) {
                            multmatrix([[0.184078, 0.391935, -0.901389, 0], [-0.982912, 0.073401, -0.168811, 0], [0, 0.91706, 0.398749, 0], [0, 0, 0, 1]]) {
                                linear_extrude(height=1.11, center=false) {
                                    translate([-0.87736, -1.89258, 0]) {
                                        text(" ", size=3.78516, font="Verdana:style=Bold");
                                    }
                                }
                            }
                        }
                        translate([22.6761, 1.42868, 57.975]) {
                            multmatrix([[0.0628791, 0.39796, -0.915245, 0], [-0.998021, 0.025073, -0.0576639, 0], [0, 0.91706, 0.398749, 0], [0, 0, 0, 1]]) {
                                linear_extrude(height=1.11, center=false) {
                                    translate([-1.82491, -1.89258, 0]) {
                                        text("9", size=3.78516, font="Verdana:style=Bold");
                                    }
                                }
                            }
                        }
                        translate([22.6027, -2.31685, 57.975]) {
                            multmatrix([[-0.101969, 0.396671, -0.91228, 0], [-0.994788, -0.0406601, 0.0935119, 0], [0, 0.91706, 0.398749, 0], [0, 0, 0, 1]]) {
                                linear_extrude(height=1.11, center=false) {
                                    translate([-1.82491, -1.89258, 0]) {
                                        text("0", size=3.78516, font="Verdana:style=Bold");
                                    }
                                }
                            }
                        }
                        translate([21.6552, -6.87752, 57.975]) {
                            multmatrix([[-0.302693, 0.380043, -0.874039, 0], [-0.953088, -0.120699, 0.277588, 0], [0, 0.91706, 0.398749, 0], [0, 0, 0, 1]]) {
                                linear_extrude(height=1.11, center=false) {
                                    translate([-2.71606, -1.89258, 0]) {
                                        text("m", size=3.78516, font="Verdana:style=Bold");
                                    }
                                }
                            }
                        }
                        translate([19.3323, -11.9378, 57.975]) {
                            multmatrix([[-0.525405, 0.339277, -0.780283, 0], [-0.850852, -0.209505, 0.481828, 0], [0, 0.91706, 0.398749, 0], [0, 0, 0, 1]]) {
                                linear_extrude(height=1.11, center=false) {
                                    translate([-2.71606, -1.89258, 0]) {
                                        text("m", size=3.78516, font="Verdana:style=Bold");
                                    }
                                }
                            }
                        }
                        translate([17.146, -14.9085, 57.975]) {
                            multmatrix([[-0.656151, 0.300908, -0.69204, 0], [-0.754629, -0.26164, 0.60173, 0], [0, 0.91706, 0.398749, 0], [0, 0, 0, 1]]) {
                                linear_extrude(height=1.11, center=false) {
                                    translate([-0.87736, -1.89258, 0]) {
                                        text(" ", size=3.78516, font="Verdana:style=Bold");
                                    }
                                }
                            }
                        }
                        translate([15.7577, -16.3689, 57.975]) {
                            multmatrix([[-0.720428, 0.276544, -0.636008, 0], [-0.693529, -0.28727, 0.660676, 0], [0, 0.91706, 0.398749, 0], [0, 0, 0, 1]]) {
                                linear_extrude(height=1.11, center=false) {
                                    translate([-1.08417, -1.89258, 0]) {
                                        text("f", size=3.78516, font="Verdana:style=Bold");
                                    }
                                }
                            }
                        }
                        translate([13.5198, -18.261, 57.975]) {
                            multmatrix([[-0.803703, 0.237268, -0.545679, 0], [-0.595031, -0.320476, 0.737044, 0], [0, 0.91706, 0.398749, 0], [0, 0, 0, 1]]) {
                                linear_extrude(height=1.11, center=false) {
                                    translate([-1.76976, -1.89258, 0]) {
                                        text("/", size=3.78516, font="Verdana:style=Bold");
                                    }
                                }
                            }
                        }
                        translate([10.3858, -20.2085, 57.975]) {
                            multmatrix([[-0.889416, 0.182268, -0.419188, 0], [-0.457099, -0.354654, 0.815648, 0], [0, 0.91706, 0.398749, 0], [0, 0, 0, 1]]) {
                                linear_extrude(height=1.11, center=false) {
                                    translate([-1.82491, -1.89258, 0]) {
                                        text("3", size=3.78516, font="Verdana:style=Bold");
                                    }
                                }
                            }
                        }
                        translate([7.79636, -21.3416, 57.975]) {
                            multmatrix([[-0.939287, 0.136824, -0.314674, 0], [-0.343133, -0.37454, 0.861382, 0], [0, 0.91706, 0.398749, 0], [0, 0, 0, 1]]) {
                                linear_extrude(height=1.11, center=false) {
                                    translate([-0.927495, -1.89258, 0]) {
                                        text(".", size=3.78516, font="Verdana:style=Bold");
                                    }
                                }
                            }
                        }
                        translate([5.08627, -22.1445, 57.975]) {
                            multmatrix([[-0.974622, 0.0892626, -0.20529, 0], [-0.223857, -0.38863, 0.893787, 0], [0, 0.91706, 0.398749, 0], [0, 0, 0, 1]]) {
                                linear_extrude(height=1.11, center=false) {
                                    translate([-1.82491, -1.89258, 0]) {
                                        text("1", size=3.78516, font="Verdana:style=Bold");
                                    }
                                }
                            }
                        }
                        translate([-19.0075, -12.4484, 57.975]) {
                            multmatrix([[-0.547878, -0.333577, 0.767174, 0], [0.836558, -0.218466, 0.502437, 0], [0, 0.91706, 0.398749, 0], [0, 0, 0, 1]]) {
                                linear_extrude(height=1.11, center=false) {
                                    translate([-1.76719, -1.88316, 0]) {
                                        text("Z", size=3.76633, font="Verdana:style=Bold");
                                    }
                                }
                            }
                        }
                        translate([-20.7167, -9.33097, 57.975]) {
                            multmatrix([[-0.410674, -0.363572, 0.836159, 0], [0.911782, -0.163756, 0.376613, 0], [0, 0.91706, 0.398749, 0], [0, 0, 0, 1]]) {
                                linear_extrude(height=1.11, center=false) {
                                    translate([-1.69611, -1.88316, 0]) {
                                        text("e", size=3.76633, font="Verdana:style=Bold");
                                    }
                                }
                            }
                        }
                        translate([-21.9328, -5.93316, 57.975]) {
                            multmatrix([[-0.26113, -0.384914, 0.885241, 0], [0.965304, -0.104125, 0.239472, 0], [0, 0.91706, 0.398749, 0], [0, 0, 0, 1]]) {
                                linear_extrude(height=1.11, center=false) {
                                    translate([-1.81957, -1.88316, 0]) {
                                        text("n", size=3.76633, font="Verdana:style=Bold");
                                    }
                                }
                            }
                        }
                        translate([-22.5762, -2.56147, 57.975]) {
                            multmatrix([[-0.112735, -0.396207, 0.911214, 0], [0.993625, -0.0449532, 0.103385, 0], [0, 0.91706, 0.398749, 0], [0, 0, 0, 1]]) {
                                linear_extrude(height=1.11, center=false) {
                                    translate([-1.524, -1.88316, 0]) {
                                        text("z", size=3.76633, font="Verdana:style=Bold");
                                    }
                                }
                            }
                        }
                        translate([-22.7086, 0.752128, 57.975]) {
                            multmatrix([[0.0331026, -0.398531, 0.916557, 0], [0.999452, 0.0131996, -0.0303571, 0], [0, 0.91706, 0.398749, 0], [0, 0, 0, 1]]) {
                                linear_extrude(height=1.11, center=false) {
                                    translate([-1.70608, -1.88316, 0]) {
                                        text("a", size=3.76633, font="Verdana:style=Bold");
                                    }
                                }
                            }
                        }
                        translate([-22.231, 4.69357, 57.975]) {
                            multmatrix([[0.206573, -0.390148, 0.89728, 0], [0.978431, 0.0823709, -0.18944, 0], [0, 0.91706, 0.398749, 0], [0, 0, 0, 1]]) {
                                linear_extrude(height=1.11, center=false) {
                                    translate([-2.16254, -1.88316, 0]) {
                                        text("N", size=3.76633, font="Verdana:style=Bold");
                                    }
                                }
                            }
                        }
                        translate([-20.8913, 8.93317, 57.975]) {
                            multmatrix([[0.393166, -0.366637, 0.843207, 0], [0.919467, 0.156775, -0.360557, 0], [0, 0.91706, 0.398749, 0], [0, 0, 0, 1]]) {
                                linear_extrude(height=1.11, center=false) {
                                    translate([-2.17127, -1.88316, 0]) {
                                        text("O", size=3.76633, font="Verdana:style=Bold");
                                    }
                                }
                            }
                        }
                        translate([-18.9928, 12.4709, 57.975]) {
                            multmatrix([[0.548868, -0.333318, 0.766579, 0], [0.835909, 0.218861, -0.503345, 0], [0, 0.91706, 0.398749, 0], [0, 0, 0, 1]]) {
                                linear_extrude(height=1.11, center=false) {
                                    translate([-1.741, -1.88316, 0]) {
                                        text("T", size=3.76633, font="Verdana:style=Bold");
                                    }
                                }
                            }
                        }
                        translate([-31.4885, 12.9568, 30.9375]) {
                            multmatrix([[-0.380524, 0, -0.924771, 0], [-0.924771, 0, 0.380524, 0], [0, 1, 0, 0], [0, 0, 0, 1]]) {
                                translate([13.2918, 0, -0.6]) {
                                    linear_extrude(height=1.11, center=false) {
                                        intersection() {
                                            scale([0.293301, 0.293301, 1]) {
                                                translate([-46.0375, 87.6653, 0]) {
                                                    rotate([0, 0, -90]) {
                                                        import(file="v15a.svg");
                                                    }
                                                }
                                            }
                                            translate([-13.2918, 0, 0]) {
                                                square([0.421963, 53.4246], center=true);
                                            }
                                        }
                                    }
                                }
                            }
                        }
                        translate([-31.6466, 12.5656, 30.9375]) {
                            multmatrix([[-0.369035, 0, -0.929416, 0], [-0.929416, 0, 0.369035, 0], [0, 1, 0, 0], [0, 0, 0, 1]]) {
                                translate([12.8699, 0, -0.6]) {
                                    linear_extrude(height=1.11, center=false) {
                                        intersection() {
                                            scale([0.293301, 0.293301, 1]) {
                                                translate([-46.0375, 87.6653, 0]) {
                                                    rotate([0, 0, -90]) {
                                                        import(file="v15a.svg");
                                                    }
                                                }
                                            }
                                            translate([-12.8699, 0, 0]) {
                                                square([0.421963, 53.4246], center=true);
                                            }
                                        }
                                    }
                                }
                            }
                        }
                        translate([-31.7999, 12.1725, 30.9375]) {
                            multmatrix([[-0.357489, 0, -0.933917, 0], [-0.933917, 0, 0.357489, 0], [0, 1, 0, 0], [0, 0, 0, 1]]) {
                                translate([12.4479, 0, -0.6]) {
                                    linear_extrude(height=1.11, center=false) {
                                        intersection() {
                                            scale([0.293301, 0.293301, 1]) {
                                                translate([-46.0375, 87.6653, 0]) {
                                                    rotate([0, 0, -90]) {
                                                        import(file="v15a.svg");
                                                    }
                                                }
                                            }
                                            translate([-12.4479, 0, 0]) {
                                                square([0.421963, 53.4246], center=true);
                                            }
                                        }
                                    }
                                }
                            }
                        }
                        translate([-31.9483, 11.7775, 30.9375]) {
                            multmatrix([[-0.345888, 0, -0.938276, 0], [-0.938276, 0, 0.345888, 0], [0, 1, 0, 0], [0, 0, 0, 1]]) {
                                translate([12.026, 0, -0.6]) {
                                    linear_extrude(height=1.11, center=false) {
                                        intersection() {
                                            scale([0.293301, 0.293301, 1]) {
                                                translate([-46.0375, 87.6653, 0]) {
                                                    rotate([0, 0, -90]) {
                                                        import(file="v15a.svg");
                                                    }
                                                }
                                            }
                                            translate([-12.026, 0, 0]) {
                                                square([0.421963, 53.4246], center=true);
                                            }
                                        }
                                    }
                                }
                            }
                        }
                        translate([-32.0918, 11.3807, 30.9375]) {
                            multmatrix([[-0.334234, 0, -0.94249, 0], [-0.94249, 0, 0.334234, 0], [0, 1, 0, 0], [0, 0, 0, 1]]) {
                                translate([11.604, 0, -0.6]) {
                                    linear_extrude(height=1.11, center=false) {
                                        intersection() {
                                            scale([0.293301, 0.293301, 1]) {
                                                translate([-46.0375, 87.6653, 0]) {
                                                    rotate([0, 0, -90]) {
                                                        import(file="v15a.svg");
                                                    }
                                                }
                                            }
                                            translate([-11.604, 0, 0]) {
                                                square([0.421963, 53.4246], center=true);
                                            }
                                        }
                                    }
                                }
                            }
                        }
                        translate([-32.2304, 10.9821, 30.9375]) {
                            multmatrix([[-0.322529, 0, -0.946559, 0], [-0.946559, 0, 0.322529, 0], [0, 1, 0, 0], [0, 0, 0, 1]]) {
                                translate([11.182, 0, -0.6]) {
                                    linear_extrude(height=1.11, center=false) {
                                        intersection() {
                                            scale([0.293301, 0.293301, 1]) {
                                                translate([-46.0375, 87.6653, 0]) {
                                                    rotate([0, 0, -90]) {
                                                        import(file="v15a.svg");
                                                    }
                                                }
                                            }
                                            translate([-11.182, 0, 0]) {
                                                square([0.421963, 53.4246], center=true);
                                            }
                                        }
                                    }
                                }
                            }
                        }
                        translate([-32.364, 10.5819, 30.9375]) {
                            multmatrix([[-0.310775, 0, -0.950484, 0], [-0.950484, 0, 0.310775, 0], [0, 1, 0, 0], [0, 0, 0, 1]]) {
                                translate([10.7601, 0, -0.6]) {
                                    linear_extrude(height=1.11, center=false) {
                                        intersection() {
                                            scale([0.293301, 0.293301, 1]) {
                                                translate([-46.0375, 87.6653, 0]) {
                                                    rotate([0, 0, -90]) {
                                                        import(file="v15a.svg");
                                                    }
                                                }
                                            }
                                            translate([-10.7601, 0, 0]) {
                                                square([0.421963, 53.4246], center=true);
                                            }
                                        }
                                    }
                                }
                            }
                        }
                        translate([-32.4926, 10.18, 30.9375]) {
                            multmatrix([[-0.298972, 0, -0.954262, 0], [-0.954262, 0, 0.298972, 0], [0, 1, 0, 0], [0, 0, 0, 1]]) {
                                translate([10.3381, 0, -0.6]) {
                                    linear_extrude(height=1.11, center=false) {
                                        intersection() {
                                            scale([0.293301, 0.293301, 1]) {
                                                translate([-46.0375, 87.6653, 0]) {
                                                    rotate([0, 0, -90]) {
                                                        import(file="v15a.svg");
                                                    }
                                                }
                                            }
                                            translate([-10.3381, 0, 0]) {
                                                square([0.421963, 53.4246], center=true);
                                            }
                                        }
                                    }
                                }
                            }
                        }
                        translate([-32.6163, 9.77657, 30.9375]) {
                            multmatrix([[-0.287124, 0, -0.957893, 0], [-0.957893, 0, 0.287124, 0], [0, 1, 0, 0], [0, 0, 0, 1]]) {
                                translate([9.91614, 0, -0.6]) {
                                    linear_extrude(height=1.11, center=false) {
                                        intersection() {
                                            scale([0.293301, 0.293301, 1]) {
                                                translate([-46.0375, 87.6653, 0]) {
                                                    rotate([0, 0, -90]) {
                                                        import(file="v15a.svg");
                                                    }
                                                }
                                            }
                                            translate([-9.91614, 0, 0]) {
                                                square([0.421963, 53.4246], center=true);
                                            }
                                        }
                                    }
                                }
                            }
                        }
                        translate([-32.7349, 9.37163, 30.9375]) {
                            multmatrix([[-0.275231, 0, -0.961378, 0], [-0.961378, 0, 0.275231, 0], [0, 1, 0, 0], [0, 0, 0, 1]]) {
                                translate([9.49418, 0, -0.6]) {
                                    linear_extrude(height=1.11, center=false) {
                                        intersection() {
                                            scale([0.293301, 0.293301, 1]) {
                                                translate([-46.0375, 87.6653, 0]) {
                                                    rotate([0, 0, -90]) {
                                                        import(file="v15a.svg");
                                                    }
                                                }
                                            }
                                            translate([-9.49418, 0, 0]) {
                                                square([0.421963, 53.4246], center=true);
                                            }
                                        }
                                    }
                                }
                            }
                        }
                        translate([-32.8485, 8.96526, 30.9375]) {
                            multmatrix([[-0.263297, 0, -0.964715, 0], [-0.964715, 0, 0.263297, 0], [0, 1, 0, 0], [0, 0, 0, 1]]) {
                                translate([9.07221, 0, -0.6]) {
                                    linear_extrude(height=1.11, center=false) {
                                        intersection() {
                                            scale([0.293301, 0.293301, 1]) {
                                                translate([-46.0375, 87.6653, 0]) {
                                                    rotate([0, 0, -90]) {
                                                        import(file="v15a.svg");
                                                    }
                                                }
                                            }
                                            translate([-9.07221, 0, 0]) {
                                                square([0.421963, 53.4246], center=true);
                                            }
                                        }
                                    }
                                }
                            }
                        }
                        translate([-32.9571, 8.5575, 30.9375]) {
                            multmatrix([[-0.251322, 0, -0.967904, 0], [-0.967904, 0, 0.251322, 0], [0, 1, 0, 0], [0, 0, 0, 1]]) {
                                translate([8.65025, 0, -0.6]) {
                                    linear_extrude(height=1.11, center=false) {
                                        intersection() {
                                            scale([0.293301, 0.293301, 1]) {
                                                translate([-46.0375, 87.6653, 0]) {
                                                    rotate([0, 0, -90]) {
                                                        import(file="v15a.svg");
                                                    }
                                                }
                                            }
                                            translate([-8.65025, 0, 0]) {
                                                square([0.421963, 53.4246], center=true);
                                            }
                                        }
                                    }
                                }
                            }
                        }
                        translate([-33.0606, 8.14844, 30.9375]) {
                            multmatrix([[-0.239308, 0, -0.970944, 0], [-0.970944, 0, 0.239308, 0], [0, 1, 0, 0], [0, 0, 0, 1]]) {
                                translate([8.22829, 0, -0.6]) {
                                    linear_extrude(height=1.11, center=false) {
                                        intersection() {
                                            scale([0.293301, 0.293301, 1]) {
                                                translate([-46.0375, 87.6653, 0]) {
                                                    rotate([0, 0, -90]) {
                                                        import(file="v15a.svg");
                                                    }
                                                }
                                            }
                                            translate([-8.22829, 0, 0]) {
                                                square([0.421963, 53.4246], center=true);
                                            }
                                        }
                                    }
                                }
                            }
                        }
                        translate([-33.1591, 7.73812, 30.9375]) {
                            multmatrix([[-0.227258, 0, -0.973835, 0], [-0.973835, 0, 0.227258, 0], [0, 1, 0, 0], [0, 0, 0, 1]]) {
                                translate([7.80632, 0, -0.6]) {
                                    linear_extrude(height=1.11, center=false) {
                                        intersection() {
                                            scale([0.293301, 0.293301, 1]) {
                                                translate([-46.0375, 87.6653, 0]) {
                                                    rotate([0, 0, -90]) {
                                                        import(file="v15a.svg");
                                                    }
                                                }
                                            }
                                            translate([-7.80632, 0, 0]) {
                                                square([0.421963, 53.4246], center=true);
                                            }
                                        }
                                    }
                                }
                            }
                        }
                        translate([-33.2524, 7.32661, 30.9375]) {
                            multmatrix([[-0.215172, 0, -0.976576, 0], [-0.976576, 0, 0.215172, 0], [0, 1, 0, 0], [0, 0, 0, 1]]) {
                                translate([7.38436, 0, -0.6]) {
                                    linear_extrude(height=1.11, center=false) {
                                        intersection() {
                                            scale([0.293301, 0.293301, 1]) {
                                                translate([-46.0375, 87.6653, 0]) {
                                                    rotate([0, 0, -90]) {
                                                        import(file="v15a.svg");
                                                    }
                                                }
                                            }
                                            translate([-7.38436, 0, 0]) {
                                                square([0.421963, 53.4246], center=true);
                                            }
                                        }
                                    }
                                }
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
