brianssparetime/bronica-lens-housing/releases/16c/v16c-print_vertical.scad

// Generated by scadwright. Do not hand-edit —
// edit the Python source and regenerate.

$fn = 128;

module S2LensHousing_84f589e7() {
    // S2LensHousing
    //  alignment_groove_depth           = 0.3  (default)
    //  alignment_groove_width           = 0.5  (default)
    //  aperture_cover_axial             = 10  (default)
    //  aperture_cover_clearance         = 0.1  (default)
    //  aperture_cover_fillet_angle      = 45  (default)
    //  aperture_cover_fillet_clearance  = 0.3  (default)
    //  aperture_cover_groove_offset_deg = 15  (default)
    //  aperture_cover_ridge_base        = 1.8  (default)
    //  aperture_cover_ridge_height      = 1.5  (default)
    //  aperture_cover_wall_thk          = 2.5  (default)
    //  aperture_feeler_slot             = [0, 15, 0.5, -30, -20.3, 60, 0.01]  (default)
    //  bore_fillet_base_angle           = 45  (default)
    //  elements                         = (Element(code='L1198', type='ACH', dia=34.2, edge_thk=23.75, spacing=87.907, face_z_top=100.482, face_z_bot=75.332, constricted=False, throat_dia_required=34.5, clearances=ElementClearances(axial=0.2, radial=0.3)), Element(code='L11561', type='ACH', dia=38.5, edge_thk=7.5, spacing=51.907, face_z_top=56.357, face_z_bot=47.456999999999994, constricted=False, throat_dia_required=38.8, clearances=ElementClearances(axial=0.2, radial=0.3)), Element(code='L14929', type='ACH', dia=38.6, edge_thk=6.3, spacing=13.907, face_z_top=17.757, face_z_bot=10.057, constricted=False, throat_dia_required=38.9, clearances=ElementClearances(axial=0.2, radial=0.3)))  (default)
    //  flange_flange_len                = 5  (default)
    //  flange_flange_od                 = 68.1  (default)
    //  fov_angle                        = 43  (default)
    //  grip_depth                       = 1.5  (default)
    //  grip_width                       = 1  (default)
    //  helicoid_focus_slot              = [180, 8, 0.8, -20.3, -11, 60, 0.01]  (default)
    //  hood_coupler_overlap             = 6  (default)
    //  hood_snap_axial                  = 1.5  (default)
    //  hood_snap_clearance              = 0.1  (default)
    //  hood_snap_engage                 = 0.3  (default)
    //  lower_inner_len                  = 9.7  (default)
    //  lower_inner_od                   = 49  (default)
    //  lower_inner_thk                  = 1.5  (default)
    //  lower_mid_len                    = 13  (default)
    //  lower_mid_od                     = 54.25  (default)
    //  lower_mid_thk                    = 1.75  (default)
    //  lower_outer_len                  = 7.3  (default)
    //  lower_outer_od                   = 56  (default)
    //  lower_outer_thk                  = 1.5  (default)
    //  mating_disc                      = [59.65, 1.2, 5]  (default)
    //  mating_disc_bead                 = [0.2, 1, 3.75, 0.05, 0.05]  (default)
    //  mating_disc_tabs                 = MatingDiscTabs(axial=3.8, radial=2.4, circumferential=6.0, z_top=5.0, angles_deg=(55.0, 185.0), clearance=0.15, disc_od=59.65, housing_tab_offset_deg=-60.0)  (default)
    //  mount_offset                     = 5  (default)
    //  stop                             = [21.857, 1.5, 0.5]  (default)
    //  upper_barrel_thk                 = 5  (default)
    //  force_all_lower_segments         = false  (default)
    //  slot_hi                          = 22.857  (default)
    //  hood_base_angle                  = 90 - fov_angle / 2 = 68.5
    //  lower_outer_id                   = lower_outer_od - 2 * lower_outer_thk = 53
    //  lower_mid_id                     = lower_mid_od - 2 * lower_mid_thk = 50.75
    //  lower_inner_id                   = lower_inner_od - 2 * lower_inner_thk = 46
    //  lower_outer_z_top                = mount_offset = 5
    //  lower_outer_z_bot                = -lower_outer_len = -7.3
    //  lower_mid_z_top                  = lower_outer_z_bot = -7.3
    //  lower_mid_z_bot                  = lower_mid_z_top - lower_mid_len = -20.3
    //  lower_inner_z_top                = lower_mid_z_bot = -20.3
    //  lower_inner_z_bot                = lower_inner_z_top - lower_inner_len = -30
    //  housing_insertion_depth          = lower_outer_len + lower_mid_len + lower_inner_len = 30
    //  lower_housing_len                = housing_insertion_depth + mount_offset = 35
    //  unconstricted                    = tuple((e for e in elements if not e.constricted)) = (Element(code='L1198', type='ACH', dia=34.2, edge_thk=23.75, spacing=87.907, face_z_top=100.482, face_z_bot=75.332, constricted=False, throat_dia_required=34.5, clearances=ElementClearances(axial=0.2, radial=0.3)), Element(code='L11561', type='ACH', dia=38.5, edge_thk=7.5, spacing=51.907, face_z_top=56.357, face_z_bot=47.456999999999994, constricted=False, throat_dia_required=38.8, clearances=ElementClearances(axial=0.2, radial=0.3)), Element(code='L14929', type='ACH', dia=38.6, edge_thk=6.3, spacing=13.907, face_z_top=17.757, face_z_bot=10.057, constricted=False, throat_dia_required=38.9, clearances=ElementClearances(axial=0.2, radial=0.3)))
    //  max_upper_ele_dia                = max((e.dia for e in unconstricted), default=0.0) = 38.6
    //  is_wide                          = max_upper_ele_dia > lower_outer_id = false
    //  expansion_funnel_len             = min((e.face_z_bot for e in unconstricted), default=inf) = 10.057
    //  upper_housing_len                = max((e.face_z_top for e in elements)) = 100.482
    //  upper_housing_od                 = max_upper_ele_dia + 2 * upper_barrel_thk if is_wide else flange_flange_od = 68.1
    //  slot_lo                          = stop.spacing - (stop.thk + stop.clr) / 2 = 20.857
    //  upper_floor                      = expansion_funnel_len if is_wide else mount_offset + flange_flange_len = 10
    union() {
        difference() {
            union() {
                difference() {
                    union() {
                        // HousingSection
                        //  bot_id        = 53  (input)
                        //  thk           = 1.5  (input)
                        //  top_id        = 53  (input)
                        //  top_overshoot = 0.01  (input)
                        //  z_bot         = -7.3  (input)
                        //  z_top         = 5  (input)
                        translate([0, 0, -7.3]) {
                            // Tube
                            //  h  = 12.31  (input)
                            //  id = 53  (input)
                            //  od = 56  (input)
                            difference() {
                                cylinder(h=12.31, r=28, center=false);
                                translate([0, 0, -0.01]) {
                                    scale([1, 1, 1.00162]) {
                                        cylinder(h=12.31, r=26.5, center=false);
                                    }
                                }
                            }
                        }
                        // HousingSection
                        //  bot_id        = 53  (input)
                        //  thk           = 7.55  (input)
                        //  top_id        = 53  (input)
                        //  top_overshoot = 0.01  (input)
                        //  z_bot         = 5  (input)
                        //  z_top         = 10  (input)
                        translate([0, 0, 5]) {
                            // Tube
                            //  h  = 5.01  (input)
                            //  id = 53  (input)
                            //  od = 68.1  (input)
                            difference() {
                                cylinder(h=5.01, r=34.05, center=false);
                                translate([0, 0, -0.01]) {
                                    scale([1, 1, 1.00399]) {
                                        cylinder(h=5.01, r=26.5, center=false);
                                    }
                                }
                            }
                        }
                        // HousingSection
                        //  bot_id = 53  (input)
                        //  thk    = 7.55  (input)
                        //  top_id = 53  (input)
                        //  z_bot  = 10  (input)
                        //  z_top  = 100.482  (input)
                        translate([0, 0, 10]) {
                            // Tube
                            //  h  = 90.482  (input)
                            //  id = 53  (input)
                            //  od = 68.1  (input)
                            difference() {
                                cylinder(h=90.482, r=34.05, center=false);
                                translate([0, 0, -0.01]) {
                                    scale([1, 1, 1.00022]) {
                                        cylinder(h=90.482, r=26.5, center=false);
                                    }
                                }
                            }
                        }
                        // HousingSection
                        //  bot_id = 56  (input)
                        //  thk    = 1.825  (input)
                        //  top_id = 56  (input)
                        //  z_bot  = 1.2  (input)
                        //  z_top  = 5  (input)
                        translate([0, 0, 1.2]) {
                            // Tube
                            //  h  = 3.8  (input)
                            //  id = 56  (input)
                            //  od = 59.65  (input)
                            difference() {
                                cylinder(h=3.8, r=29.825, center=false);
                                translate([0, 0, -0.01]) {
                                    scale([1, 1, 1.00526]) {
                                        cylinder(h=3.8, r=28, center=false);
                                    }
                                }
                            }
                        }
                    }
                    translate([0, 0, 20.857]) {
                        intersection() {
                            // Tube
                            //  h  = 2  (input)
                            //  id = 52.9  (input)
                            //  od = 69.1  (input)
                            difference() {
                                cylinder(h=2, r=34.55, center=false);
                                translate([0, 0, -0.01]) {
                                    scale([1, 1, 1.01]) {
                                        cylinder(h=2, r=26.45, center=false);
                                    }
                                }
                            }
                            translate([0, 35.241, 0]) {
                                cube([70.482, 70.482, 70.482], center=true);
                            }
                        }
                    }
                    translate([0, 34.06, 5]) {
                        rotate([90, 0, 0]) {
                            linear_extrude(height=4.245, center=false) {
                                polygon(points=[[-0.25, -0.01], [0.25, -0.01], [0, 0.3]]);
                            }
                        }
                    }
                    union() {
                        rotate([0, 0, -15]) {
                            translate([0, 0, 16.757]) {
                                linear_extrude(height=10.2, center=false) {
                                    polygon(points=[[34.06, -1], [34.06, 1], [32.45, 0]]);
                                }
                            }
                        }
                        rotate([0, 0, 195]) {
                            translate([0, 0, 16.757]) {
                                linear_extrude(height=10.2, center=false) {
                                    polygon(points=[[34.06, -1], [34.06, 1], [32.45, 0]]);
                                }
                            }
                        }
                    }
                }
                rotate([0, 0, -15]) {
                    rotate_extrude(angle=210) {
                        polygon(points=[[34.04, 27.157], [36.55, 27.157], [34.04, 29.657]]);
                    }
                }
                rotate([0, 0, -15]) {
                    rotate_extrude(angle=210) {
                        polygon(points=[[34.04, 16.557], [36.55, 16.557], [34.04, 14.057]]);
                    }
                }
                rotate([0, 0, -5]) {
                    translate([0, 0, 1.2]) {
                        linear_extrude(height=3.8, center=false) {
                            polygon(points=[[29.815, -3], [32.225, -3], [32.225, 3], [29.815, 3]]);
                        }
                    }
                }
                rotate([0, 0, 125]) {
                    translate([0, 0, 1.2]) {
                        linear_extrude(height=3.8, center=false) {
                            polygon(points=[[29.815, -3], [32.225, -3], [32.225, 3], [29.815, 3]]);
                        }
                    }
                }
                rotate_extrude() {
                    polygon(points=[[29.815, 3.25], [30.025, 3.75], [29.815, 4.25]]);
                }
            }
            rotate_extrude() {
                polygon(points=[[34.06, 111.632], [34.06, 113.332], [33.65, 112.482]]);
            }
        }
        // ElementHolder
        //  element    = Element(code='L1198', type='ACH', dia=34.2, edge_thk=23.75, spacing=87.907, face_z_top=100.482, face_z_bot=75.332, constricted=False, throat_dia_required=34.5, clearances=ElementClearances(axial=0.2, radial=0.3))  (input)
        //  grip_depth = 1.5  (input)
        //  grip_width = 1  (input)
        //  od         = 53.02  (input)
        union() {
            translate([0, 0, 75.332]) {
                // Tube
                //  h  = 25.15  (input)
                //  id = 34.5  (input)
                //  od = 53.02  (input)
                difference() {
                    cylinder(h=25.15, r=26.51, center=false);
                    translate([0, 0, -0.01]) {
                        scale([1, 1, 1.0008]) {
                            cylinder(h=25.15, r=17.25, center=false);
                        }
                    }
                }
            }
            translate([0, 0, 75.332]) {
                // Tube
                //  h  = 0.5  (input)
                //  id = 32.7  (input)
                //  od = 53.02  (input)
                difference() {
                    cylinder(h=0.5, r=26.51, center=false);
                    translate([0, 0, -0.01]) {
                        scale([1, 1, 1.04]) {
                            cylinder(h=0.5, r=16.35, center=false);
                        }
                    }
                }
            }
            translate([0, 0, 99.982]) {
                // Tube
                //  h  = 0.5  (input)
                //  id = 32.7  (input)
                //  od = 53.02  (input)
                difference() {
                    cylinder(h=0.5, r=26.51, center=false);
                    translate([0, 0, -0.01]) {
                        scale([1, 1, 1.04]) {
                            cylinder(h=0.5, r=16.35, center=false);
                        }
                    }
                }
            }
        }
        // ElementHolder
        //  element    = Element(code='L11561', type='ACH', dia=38.5, edge_thk=7.5, spacing=51.907, face_z_top=56.357, face_z_bot=47.456999999999994, constricted=False, throat_dia_required=38.8, clearances=ElementClearances(axial=0.2, radial=0.3))  (input)
        //  grip_depth = 1.5  (input)
        //  grip_width = 1  (input)
        //  od         = 53.02  (input)
        union() {
            translate([0, 0, 47.457]) {
                // Tube
                //  h  = 8.9  (input)
                //  id = 38.8  (input)
                //  od = 53.02  (input)
                difference() {
                    cylinder(h=8.9, r=26.51, center=false);
                    translate([0, 0, -0.01]) {
                        scale([1, 1, 1.00225]) {
                            cylinder(h=8.9, r=19.4, center=false);
                        }
                    }
                }
            }
            translate([0, 0, 47.457]) {
                // Tube
                //  h  = 0.5  (input)
                //  id = 37  (input)
                //  od = 53.02  (input)
                difference() {
                    cylinder(h=0.5, r=26.51, center=false);
                    translate([0, 0, -0.01]) {
                        scale([1, 1, 1.04]) {
                            cylinder(h=0.5, r=18.5, center=false);
                        }
                    }
                }
            }
            translate([0, 0, 55.857]) {
                // Tube
                //  h  = 0.5  (input)
                //  id = 37  (input)
                //  od = 53.02  (input)
                difference() {
                    cylinder(h=0.5, r=26.51, center=false);
                    translate([0, 0, -0.01]) {
                        scale([1, 1, 1.04]) {
                            cylinder(h=0.5, r=18.5, center=false);
                        }
                    }
                }
            }
        }
        // ElementHolder
        //  element    = Element(code='L14929', type='ACH', dia=38.6, edge_thk=6.3, spacing=13.907, face_z_top=17.757, face_z_bot=10.057, constricted=False, throat_dia_required=38.9, clearances=ElementClearances(axial=0.2, radial=0.3))  (input)
        //  grip_depth = 1.5  (input)
        //  grip_width = 1  (input)
        //  od         = 53.02  (input)
        union() {
            translate([0, 0, 10.057]) {
                // Tube
                //  h  = 7.7  (input)
                //  id = 38.9  (input)
                //  od = 53.02  (input)
                difference() {
                    cylinder(h=7.7, r=26.51, center=false);
                    translate([0, 0, -0.01]) {
                        scale([1, 1, 1.0026]) {
                            cylinder(h=7.7, r=19.45, center=false);
                        }
                    }
                }
            }
            translate([0, 0, 10.057]) {
                // Tube
                //  h  = 0.5  (input)
                //  id = 37.1  (input)
                //  od = 53.02  (input)
                difference() {
                    cylinder(h=0.5, r=26.51, center=false);
                    translate([0, 0, -0.01]) {
                        scale([1, 1, 1.04]) {
                            cylinder(h=0.5, r=18.55, center=false);
                        }
                    }
                }
            }
            translate([0, 0, 17.257]) {
                // Tube
                //  h  = 0.5  (input)
                //  id = 37.1  (input)
                //  od = 53.02  (input)
                difference() {
                    cylinder(h=0.5, r=26.51, center=false);
                    translate([0, 0, -0.01]) {
                        scale([1, 1, 1.04]) {
                            cylinder(h=0.5, r=18.55, center=false);
                        }
                    }
                }
            }
        }
        difference() {
            // StopHolder
            //  barrel_id  = 53  (input)
            //  grip_depth = 1.5  (input)
            //  grip_width = 1  (input)
            //  od_bot     = 68.1  (input)
            //  od_top     = 68.1  (input)
            //  stop       = [21.857, 1.5, 0.5]  (input)
            color("green") {
                translate([0, 0, 21.857]) {
                    union() {
                        translate([0, 0, 1]) {
                            // Tube
                            //  h  = 0.5  (input)
                            //  id = 51.5  (input)
                            //  od = 68.1  (input)
                            difference() {
                                cylinder(h=0.5, r=34.05, center=false);
                                translate([0, 0, -0.01]) {
                                    scale([1, 1, 1.04]) {
                                        cylinder(h=0.5, r=25.75, center=false);
                                    }
                                }
                            }
                        }
                        translate([0, 0, -1.5]) {
                            // Tube
                            //  h  = 0.5  (input)
                            //  id = 51.5  (input)
                            //  od = 68.1  (input)
                            difference() {
                                cylinder(h=0.5, r=34.05, center=false);
                                translate([0, 0, -0.01]) {
                                    scale([1, 1, 1.04]) {
                                        cylinder(h=0.5, r=25.75, center=false);
                                    }
                                }
                            }
                        }
                    }
                }
            }
            union() {
                rotate([0, 0, -15]) {
                    translate([0, 0, 16.757]) {
                        linear_extrude(height=10.2, center=false) {
                            polygon(points=[[34.06, -1], [34.06, 1], [32.45, 0]]);
                        }
                    }
                }
                rotate([0, 0, 195]) {
                    translate([0, 0, 16.757]) {
                        linear_extrude(height=10.2, center=false) {
                            polygon(points=[[34.06, -1], [34.06, 1], [32.45, 0]]);
                        }
                    }
                }
            }
        }
        difference() {
            translate([0, 0, 100.472]) {
                // TruncFilletRing
                //  base_angle = 68.5  (input)
                //  id         = 37.7  (input)
                //  od         = 68.1  (input)
                //  rim_width  = 9.29134  (input)
                //  slant      = 'inwards'  (input)
                //  h_full     = tan(base_angle) * (od - id) / 2 = 38.5874
                //  z_t        = tan(base_angle) * ((od - id) / 2 - rim_width) = 15
                difference() {
                    // FilletRing
                    //  base_angle = 68.5  (input)
                    //  id         = 37.7  (input)
                    //  od         = 68.1  (input)
                    //  slant      = 'inwards'  (input)
                    difference() {
                        cylinder(h=38.5874, r=34.05, center=false);
                        translate([0, 0, -0.0681]) {
                            cylinder(h=38.7236, r1=18.85, r2=34.1181, center=false);
                        }
                    }
                    translate([0, 0, -0.00635931]) {
                        scale([1, 1, 1.00042]) {
                            translate([0, 0, 15]) {
                                cylinder(h=23.5874, r=34.06, center=false);
                            }
                        }
                    }
                }
            }
            rotate_extrude() {
                polygon(points=[[34.06, 111.632], [34.06, 113.332], [33.65, 112.482]]);
            }
        }
    }
}
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
