brianssparetime/bronica-lens-housing/releases/caps/rear_lens_cap-rear_cap.scad

// Generated by scadwright. Do not hand-edit —
// edit the Python source and regenerate.

$fn = 96;

translate([31.45, 31.45, 0]) {
    // BronicaS2RearLensCap
    //  cam_barrel_id = 56.5  (default)
    //  cam_barrel_od = 60.5  (default)
    //  cup_od        = 60.5  (default)
    //  cup_wall_thk  = 2  (default)
    //  disc_thk      = 2  (default)
    //  lug_axial     = 1.15  (default)
    //  lug_tube_len  = 7.3  (default)
    //  lugs          = ((90.0, 49.0, 1.8), (214.75, 39.0, 1.2), (324.25, 40.5, 1.2))  (default)
    //  total_h       = 50  (default)
    //  cup_h         = total_h - lug_tube_len = 42.7
    //  cup_tube_len  = cup_h - disc_thk = 40.7
    //  cup_id        = cup_od - 2 * cup_wall_thk = 56.5
    union() {
        translate([0, 0, 2]) {
            // Tube
            //  h  = 40.7  (input)
            //  id = 56.5  (input)
            //  od = 60.5  (input)
            difference() {
                cylinder(h=40.7, r=30.25, center=false);
                translate([0, 0, -0.01]) {
                    scale([1, 1, 1.00049]) {
                        cylinder(h=40.7, r=28.25, center=false);
                    }
                }
            }
        }
        cylinder(h=2.01, r=30.25, center=false);
        translate([0, 0, 42.69]) {
            // CameraMount
            //  barrel_id = 56.5  (input)
            //  length    = 7.31  (input)
            //  lug_axial = 1.15  (input)
            //  lugs      = ((90.0, 49.0, 1.8), (214.75, 39.0, 1.2), (324.25, 40.5, 1.2))  (input)
            //  wall_thk  = 2  (input)
            //  barrel_od = barrel_id + 2 * wall_thk = 60.5
            //  body_or   = barrel_od / 2 = 30.25
            union() {
                // Tube
                //  h  = 7.31  (input)
                //  id = 56.5  (input)
                //  od = 60.5  (input)
                difference() {
                    cylinder(h=7.31, r=30.25, center=false);
                    translate([0, 0, -0.01]) {
                        scale([1, 1, 1.00274]) {
                            cylinder(h=7.31, r=28.25, center=false);
                        }
                    }
                }
                translate([0, 0, 6.16]) {
                    linear_extrude(height=1.15, center=false) {
                        // Arc
                        //  angles  = [65.5, 114.5]  (input)
                        //  r       = 31.15  (input)
                        //  width   = 1.8  (input)
                        //  inner_r = r - width / 2 = 30.25
                        //  outer_r = r + width / 2 = 32.05
                        difference() {
                            // Sector
                            //  angles = [65.5, 114.5]  (input)
                            //  r      = 32.05  (input)
                            intersection() {
                                circle(r=32.05);
                                polygon(points=[[0, 0], [26.5818, 58.3285], [-26.5818, 58.3285]]);
                            }
                            circle(r=30.25);
                        }
                    }
                }
                translate([0, 0, 6.16]) {
                    linear_extrude(height=1.15, center=false) {
                        // Arc
                        //  angles  = [195.25, 234.25]  (input)
                        //  r       = 30.85  (input)
                        //  width   = 1.2  (input)
                        //  inner_r = r - width / 2 = 30.25
                        //  outer_r = r + width / 2 = 31.45
                        difference() {
                            // Sector
                            //  angles = [195.25, 234.25]  (input)
                            //  r      = 31.45  (input)
                            intersection() {
                                circle(r=31.45);
                                polygon(points=[[0, 0], [-60.6851, -16.5447], [-36.7493, -51.048]]);
                            }
                            circle(r=30.25);
                        }
                    }
                }
                translate([0, 0, 6.16]) {
                    linear_extrude(height=1.15, center=false) {
                        // Arc
                        //  angles  = [304, 344.5]  (input)
                        //  r       = 30.85  (input)
                        //  width   = 1.2  (input)
                        //  inner_r = r - width / 2 = 30.25
                        //  outer_r = r + width / 2 = 31.45
                        difference() {
                            // Sector
                            //  angles = [304, 344.5]  (input)
                            //  r      = 31.45  (input)
                            intersection() {
                                circle(r=31.45);
                                polygon(points=[[0, 0], [35.1732, -52.1465], [60.6124, -16.8093]]);
                            }
                            circle(r=30.25);
                        }
                    }
                }
            }
        }
    }
}
