brianssparetime/bronica-lens-housing/releases/mount-ring/lens_mount_locking_ring-print.scad

// Generated by scadwright. Do not hand-edit —
// edit the Python source and regenerate.

union() {
    translate([35.55, 35.55, 0]) {
        union() {
            // BronicaS2LockingLensMount
            //  cam_barrel_id        = 56.5  (input)
            //  cam_barrel_od        = 60.5  (input)
            //  lug_axial            = 1.15  (input)
            //  lugs                 = ((90.0, 49.0, 1.8), (214.75, 39.0, 1.2), (324.25, 40.5, 1.2))  (input)
            //  clearance            = 0.2  (default)
            //  entry_arc_clearance  = 1  (default)
            //  groove_depth         = 0.3  (default)
            //  groove_width         = 0.5  (default)
            //  inner_shrink         = 1  (default)
            //  lock_angle_deg       = 60  (default)
            //  lug_axial_clearance  = 0.25  (default)
            //  lug_radial_clearance = 0  (default)
            //  mount_skirt          = 1.7  (default)
            //  protrusion_len       = 5  (default)
            //  wall_thk             = 2  (default)
            //  insertion_depth      = lug_axial + lug_axial_clearance + mount_skirt = 3.1
            //  h                    = protrusion_len + insertion_depth = 8.1
            //  max_lug_proj         = max((p for c, w, p in lugs)) = 1.8
            //  outer_od             = cam_barrel_od + 2 * max_lug_proj + 2 * wall_thk = 68.1
            //  inner_id             = cam_barrel_id - 2 * wall_thk - inner_shrink = 51.5
            //  body_or              = cam_barrel_od / 2 = 30.25
            //  outer_or             = outer_od / 2 = 34.05
            //  rest_z               = h - insertion_depth = 5
            //  bore_inner_r         = body_or + clearance - inner_shrink / 2 = 29.95
            //  channel_breakthrough = 0.5 = 0.5
            //  channel_inner_r      = bore_inner_r + clearance - channel_breakthrough = 29.65
            //  widest_w             = max((lw for lc, lw, lp in lugs)) = 49
            //  widest_center        = [lc for lc, lw, lp in lugs if lw == widest_w][0] = 90
            //  groove_angle_deg     = widest_center - lock_angle_deg = 30
            union() {
                difference() {
                    union() {
                        // Tube
                        //  h  = 8.1  (input)
                        //  id = 51.5  (input)
                        //  od = 68.1  (input)
                        difference() {
                            cylinder(h=8.1, r=34.05, center=false, $fn=128);
                            translate([0, 0, -0.01]) {
                                scale([1, 1, 1.00247]) {
                                    cylinder(h=8.1, r=25.75, center=false, $fn=128);
                                }
                            }
                        }
                        rotate([0, 0, 310.5]) {
                            translate([0, 0, 0]) {
                                linear_extrude(height=1.35, center=false, $fn=128) {
                                    polygon(points=[[34.04, -3], [36.5, -1.55], [36.7023, -1.53674], [36.9012, -1.49719], [37.0932, -1.43201], [37.275, -1.34234], [37.4436, -1.2297], [37.596, -1.09602], [37.7297, -0.94358], [37.8423, -0.775], [37.932, -0.593159], [37.9972, -0.40117], [38.0367, -0.202316], [38.05, 0], [38.0367, 0.202316], [37.9972, 0.40117], [37.932, 0.593159], [37.8423, 0.775], [37.7297, 0.94358], [37.596, 1.09602], [37.4436, 1.2297], [37.275, 1.34234], [37.0932, 1.43201], [36.9012, 1.49719], [36.7023, 1.53674], [36.5, 1.55], [34.04, 3]]);
                                }
                            }
                        }
                        rotate([0, 0, 310.5]) {
                            translate([0, 0, 6.75]) {
                                linear_extrude(height=1.35, center=false, $fn=128) {
                                    polygon(points=[[34.04, -3], [36.5, -1.55], [36.7023, -1.53674], [36.9012, -1.49719], [37.0932, -1.43201], [37.275, -1.34234], [37.4436, -1.2297], [37.596, -1.09602], [37.7297, -0.94358], [37.8423, -0.775], [37.932, -0.593159], [37.9972, -0.40117], [38.0367, -0.202316], [38.05, 0], [38.0367, 0.202316], [37.9972, 0.40117], [37.932, 0.593159], [37.8423, 0.775], [37.7297, 0.94358], [37.596, 1.09602], [37.4436, 1.2297], [37.275, 1.34234], [37.0932, 1.43201], [36.9012, 1.49719], [36.7023, 1.53674], [36.5, 1.55], [34.04, 3]]);
                                }
                            }
                        }
                    }
                    translate([0, 0, -0.01]) {
                        linear_extrude(height=8.12, center=false, $fn=128) {
                            offset(r=0.2, $fn=128) {
                                circle(r=29.75, $fn=128);
                            }
                        }
                    }
                    translate([0, 0, 5]) {
                        linear_extrude(height=3.11, center=false, $fn=128) {
                            offset(r=0.2, $fn=128) {
                                union() {
                                    // Arc
                                    //  angles  = [63.6606, 116.339]  (input)
                                    //  r       = 30.75  (input)
                                    //  width   = 2.2  (input)
                                    //  inner_r = r - width / 2 = 29.65
                                    //  outer_r = r + width / 2 = 31.85
                                    difference() {
                                        // Sector
                                        //  angles = [63.6606, 116.339]  (input)
                                        //  r      = 31.85  (input)
                                        intersection() {
                                            circle(r=31.85, $fn=128);
                                            polygon(points=[[0, 0], [28.2628, 57.0868], [-28.2628, 57.0868]]);
                                        }
                                        circle(r=29.65, $fn=128);
                                    }
                                    // Arc
                                    //  angles  = [193.393, 236.107]  (input)
                                    //  r       = 30.45  (input)
                                    //  width   = 1.6  (input)
                                    //  inner_r = r - width / 2 = 29.65
                                    //  outer_r = r + width / 2 = 31.25
                                    difference() {
                                        // Sector
                                        //  angles = [193.393, 236.107]  (input)
                                        //  r      = 31.25  (input)
                                        intersection() {
                                            circle(r=31.25, $fn=128);
                                            polygon(points=[[0, 0], [-60.8003, -14.4766], [-34.8525, -51.8802]]);
                                        }
                                        circle(r=29.65, $fn=128);
                                    }
                                    // Arc
                                    //  angles  = [302.143, 346.357]  (input)
                                    //  r       = 30.45  (input)
                                    //  width   = 1.6  (input)
                                    //  inner_r = r - width / 2 = 29.65
                                    //  outer_r = r + width / 2 = 31.25
                                    difference() {
                                        // Sector
                                        //  angles = [302.143, 346.357]  (input)
                                        //  r      = 31.25  (input)
                                        intersection() {
                                            circle(r=31.25, $fn=128);
                                            polygon(points=[[0, 0], [33.2519, -52.9203], [60.7366, -14.7417]]);
                                        }
                                        circle(r=29.65, $fn=128);
                                    }
                                }
                            }
                        }
                    }
                    translate([0, 0, 5]) {
                        linear_extrude(height=1.4, center=false, $fn=128) {
                            offset(r=0.2, $fn=128) {
                                union() {
                                    // Arc
                                    //  angles  = [5.5, 114.5]  (input)
                                    //  r       = 30.75  (input)
                                    //  width   = 2.2  (input)
                                    //  inner_r = r - width / 2 = 29.65
                                    //  outer_r = r + width / 2 = 31.85
                                    difference() {
                                        // Sector
                                        //  angles = [5.5, 114.5]  (input)
                                        //  r      = 31.85  (input)
                                        intersection() {
                                            circle(r=31.85, $fn=128);
                                            polygon(points=[[0, 0], [63.4067, 6.10537], [31.85, 55.1658], [-26.416, 57.9645]]);
                                        }
                                        circle(r=29.65, $fn=128);
                                    }
                                    // Arc
                                    //  angles  = [135.25, 234.25]  (input)
                                    //  r       = 30.45  (input)
                                    //  width   = 1.6  (input)
                                    //  inner_r = r - width / 2 = 29.65
                                    //  outer_r = r + width / 2 = 31.25
                                    difference() {
                                        // Sector
                                        //  angles = [135.25, 234.25]  (input)
                                        //  r      = 31.25  (input)
                                        intersection() {
                                            circle(r=31.25, $fn=128);
                                            polygon(points=[[0, 0], [-44.3866, 44.0009], [-62.2853, -5.17551], [-36.5156, -50.7234]]);
                                        }
                                        circle(r=29.65, $fn=128);
                                    }
                                    // Arc
                                    //  angles  = [244, 344.5]  (input)
                                    //  r       = 30.45  (input)
                                    //  width   = 1.6  (input)
                                    //  inner_r = r - width / 2 = 29.65
                                    //  outer_r = r + width / 2 = 31.25
                                    difference() {
                                        // Sector
                                        //  angles = [244, 344.5]  (input)
                                        //  r      = 31.25  (input)
                                        intersection() {
                                            circle(r=31.25, $fn=128);
                                            polygon(points=[[0, 0], [-27.3982, -56.1746], [25.6699, -56.9851], [60.2269, -16.7024]]);
                                        }
                                        circle(r=29.65, $fn=128);
                                    }
                                }
                            }
                        }
                    }
                    rotate([0, 0, 30]) {
                        translate([0, 0, -0.01]) {
                            linear_extrude(height=8.12, center=false, $fn=128) {
                                polygon(points=[[33.75, 0], [34.06, 0.25], [34.06, -0.25]]);
                            }
                        }
                    }
                    translate([0, 0, 2.65]) {
                        linear_extrude(height=4, center=false, $fn=128) {
                            // Arc
                            //  angles  = [285, 292]  (input)
                            //  r       = 32.65  (input)
                            //  width   = 4.8  (input)
                            //  inner_r = r - width / 2 = 30.25
                            //  outer_r = r + width / 2 = 35.05
                            difference() {
                                // Sector
                                //  angles = [285, 292]  (input)
                                //  r      = 35.05  (input)
                                intersection() {
                                    circle(r=35.05, $fn=128);
                                    polygon(points=[[0, 0], [18.1432, -67.7114], [26.2599, -64.9956]]);
                                }
                                circle(r=30.25, $fn=128);
                            }
                        }
                    }
                    translate([23.7049, -27.7548, -0.5]) {
                        cylinder(h=9.1, r=0.75, center=false, $fn=32);
                    }
                    union() {
                        rotate([0, 0, -5]) {
                            translate([0, 0, -0.01]) {
                                linear_extrude(height=3.96, center=false, $fn=128) {
                                    polygon(points=[[29.94, -3.15], [32.375, -3.15], [32.375, 3.15], [29.94, 3.15]]);
                                }
                            }
                        }
                        rotate([0, 0, 125]) {
                            translate([0, 0, -0.01]) {
                                linear_extrude(height=3.96, center=false, $fn=128) {
                                    polygon(points=[[29.94, -3.15], [32.375, -3.15], [32.375, 3.15], [29.94, 3.15]]);
                                }
                            }
                        }
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
