brianssparetime/bronica-lens-housing/(commit log)

2026-08-01 Add lens housing, mount rings, and caps
    3D-printed parts for the Bronica S/S2/S2A/EC/EC-TL system, built with
    SCADwright. The lens housing resolves every dimension from a JSON
    optical configuration and splits along the optical axis into two
    snap-fit halves, mounted by a locking bayonet ring with a pivot lever.
    Also included: waterhouse stop discs and slot cover, clip-on hood and
    front lens cap, rear lens cap, body cap, a bare lens-mount ring, and
    diagnostic test-fit variants for checking fits without printing a full
    housing.
    Printed releases for 13f, 14a, 15a, and 16c are kept under releases/.
    OLD.zip archives the source of earlier iterations.
    [v13f-mount_ring_slice.scad, v13f-mount_ring_slice.stl, v14a-display.scad, v14a-print_aperture_cover.scad, v14a-print_aperture_cover.stl, v14a-print_hood.scad, v14a-print_hood.stl, v14a-print_lens_cap.scad]
2026-08-01 Add --allow_dirty to stamp test prints from an uncommitted tree
    The barrel stamp refuses a dirty working tree, since the commit alone
    would not reproduce the geometry. That is right for anything worth
    keeping, but it blocks the throwaway prints made while iterating.
    --allow_dirty passes through to print_stamp, which appends a "-dirty"
    suffix so the part still records that its source was not committed.
    Also correct the flag syntax in the README and in a test_fit comment:
    boolean flags are bare, so --no_locking_mech=1 is a parse error.
2026-08-01 Lead the README with the finished lens on the camera
    A photo of the mounted lens says what the project is faster than the
    opening paragraph does, so it now sits above the goal section.
2026-08-01 Add the locking mount ring STL under releases
    No printable ring was committed; releases/13f only held the 30 degree
    slice used for checking the bayonet profile, which isn't a usable part.
    The ring sits in its own folder rather than under a version, because its
    geometry comes from spec.py and mating_disc_lock.py and never touches the
    optical config, so one ring fits every housing.
    Rendered from current source rather than reusing the stale copy from
    June, which predates several changes to the mating disc.
    [lens_mount_locking_ring-print.scad, lens_mount_locking_ring-print.stl]
2026-08-01 Publish the bare mount ring for reuse in other designs
    The bare ring is the part worth handing to someone else: a Bronica
    bayonet they can import and fuse onto a part of their own, without the
    pivot lever or the modeled supports getting in the way.
    Both forms are included, the ring alone and the ring laid out with its
    supports to print standalone. arrange_on_bed leaves the geometry sitting
    on the bed rather than on the origin, so the README gives the translate
    that centers it on the optical axis.
    Also replace "carries" throughout the README with plain verbs.
    [lens_mount_ring-lens.scad, lens_mount_ring-lens.stl, lens_mount_ring-lens_print.scad, lens_mount_ring-lens_print.stl]
2026-11-03 Lift the body-cap support pillar off the plug disc
    The pillar sat flush on the disc's top face, so the CSG union fused the
    PETG supports into the PLA cap and the combined cap_print STL came out
    as one body. Starting the pillar support_air_gap above the disc keeps
    the supports as separate solids the slicer can split, matching how the
    mount ring's lens_print variant already behaves.
2026-11-03 Add the body cap and rear lens cap STLs under releases
    [body_cap-cap.scad, body_cap-cap.stl, body_cap-cap_print.scad, body_cap-cap_print.stl, rear_lens_cap-rear_cap.scad, rear_lens_cap-rear_cap.stl, rear_lens_cap-rear_cap_sym.scad, rear_lens_cap-rear_cap_sym.stl]
